frubem/NE_Delta_Schematics/Docs/delta_floppy_interface.pdf

ln Iaae dl progettazione. contemporaneamente alla piastra base del computer DELTA, cl siamo preoccupati di realizzare anche una adatta e specifica lntariaocla tloppy. in quanto tutti i DRIVE FLOPPY utilizzati nei computer Apple sono totalmente diversi da quelli utilizzati nei normali cornputer standard, per cui diversa risulta anche la tecnologia circuitale.
Per questo motivo, diciamo subito che questa interiaccia serve solo per i computer Apple 2 e Apple 2E, per tutti i compatibili Apple giapponesi. thailandesi. ecc.. per il nostro Delta e per gestire esclusivamente DRIVE FLOPPY per computer APPLE.
Non tentata quindi di pilotare con questa intertaccia altri modelli di Drivelloppy, perche non tunzionerebbero.

Questa interiaccia cl occorreva "subito", non solo per collaudare il nostro computer DELTA, ma ancor più per controllare tutti i vari Drive compatibili Apple, e verilicarne l'attidabilità di funzionamento.
lnlatti. troppi sono i Drive reperibili sul mercatoe troppe le "ditterenze" di prezzo da una marca ad un'altra.
Pertanto, volevamo appurare se per alcuni Drive si paga il "nome". oppure la qualità. e la conclusio~ ne a cui siamo giunti è che non conviene mai scegliere dei Drive economici ritenendo di fare un affare, perchè dopo pochi mesi, immancabilmente. occorre sostituirli con quelli più costosi
il Drive è l'accessorio più IMPORTANTE di un computer' quindi, è meglio spendere subito un po' di più, perchè con il tempo se ne trae un vantaggio

### Per utlllzzare con Il nostro computer DELTA. la vastissima blblloteca dl programmi, glochl ed applicazlonl varie disponibili per I'Apple, è

Indispensabile questa “lnteriaccla tloppy disk", In quanto Il software Apple è reperibile più facilmente su norrnall dischetti.

Nella pagina accanto, In

### hanno. potete osservare

l'lntorinocla che vi permettere dl gatlrc due
drive-floppy.

# per computerDELTA

sull'attidabilità. che si traduce in un sicuro vantaggio economico. Non bisogna dimenticare intatti, che il Drive e l'unico componente MECCANICO gestito dal computer ed e sufficiente che dopo breve tempo presenti anche ll più piccolo inconveniente. per ritrovarsi irrimediabilmente “in panno".

SCHEMA ELETTRICO
Iniziamo la descrizione dello schema elettrico di questa interiaccia visibile In tig. 1. dal connettore dl ingresso posto sulla sinistre che. nella realtà. rappresenta il connettore a "pettine", che andrà Inserito nel connattoridiespansionedel computer. Procedendo dal basso verso l'alto. troviamo aubito il collegamento al BUS degli INDlFlIZZI (ingressi da 2 B a 9 B), raggruppate nella lascia colorata in BLU e siglato ADO-ADI
Questo BUS che comprende B tili. giungerà sui piedini 1-2-34-5-6-7-8 dell'integrato ICS, una EPROM tipo 2716 siglata EPJBÀ/B. nell'intemo delle quale e scritto tutto Il programma dl gestione peri tloppydisk` cioè. in pratica, tutte le istruzioni che il computer dovrà eseguire per leggere o scrlvere i dati sul dischetto

ll BUSdegli indirizzi giunge anche sull'íntegrato ICQ. un TTL tipo 74LS259. dal quale preleveremo i segnali di comando per il motore PASSO~PASSO del drive tloppyt necessario per spostare avanti o indietro sul disco le testina di lettura e scrittura del drive stesso
Ritornando al connettore di ingresso collocato sulla sinistra, subito sopra al BUS degli indirizzi troviamo il terminale siglato 1 8 (vedi I/O SEL.) sul quale giungerà il segnale di selezione delle EPROM EP.784/B(vedlpiedlnl18 e 20 di ICE), per leggere e selezionare le istruzioni in essa contenu-
te,
Questo stesso segnale di selezione verrà utilizzato anche perabilitare l'integrato ICS (vedi piedini 1-19). un “bufler” TTL tipo 74L8244. necessario per amplificare e squadrare i dati provenienti dalla eprom EPJBA/B da inviare al computer4
Sempre sul connettore di ingresso, troviamo il terminale siglato Ztl A (vedi RES) che servirà.all'atto dell'eccensione, a RESETTARE tutto il circuito di interfaccia floppy.
Subito sopra, troviamo il terminale 10 A, siglato DRVSEL a. come dice la parola stessa (^'Drìve Selector"). questo ingresso ci serve per selezionare.

99

..In
H'.
.mi
l-

## Il lc: n I

u ls us n

# JB; L-«-1--«1-H--- i ë. nav'- l'" _' '4' '_

Fly. 1 Schola: olcflrlco doll'lmuilcela dmn Iloppy. La had. “fucili vlnlbllc I :Iulm npprucnh Il conncflon I pmlm, lo duo luca poni a dmn l due connettori dl una": pu I dll".Prlcllllmo che I hrmlnlll dl quufl duo connollml(uclulllplldlnl14)nm llfll colhßlfl In pirlllllc, anche u per non templlcln Il dlugm lbhllmo "ldlndllo In colon II mln colloglmønlo del phdlnl 2 n 10.

tramite ICQ. lCt/D ed lCi/C. uno dei due drive collegati ai due connettori di uscita posti a destra. sul quale desideriamo scrivere o leggere. Osservando lo schema elettrico potrete notare che. in questo circuito di selezione dei due drive. e presente anche un integrato. IC1. che altro non e che un NE.555.
Questo NE.555 utilizzato come temporizzatore. ci serve per mantenere in lunzione il drive-tloppy selezionato per un breve periodo di tempo. determinato dai valori della resistenza R3 e del condensatore 06. dopo che il computer ha tinito le operazioni di lettura o di scrittura sul dischetto.
Questo ritardo risulta indispensabile. soprattutto nei casi di lettura o di scrittura ripetuta e veloce dei dati` onde evitare che, accendendo e spegnendo continuamente il drive. si possano veriticare degli errori di accesso.

ELENCO COMPONENTI LXJM

111 : 3.300 ohm 1/4 walt
Il! 3.300 ohm 1/4 wall
R3 : 41.000 ohm 1/4 “11
C1 : 22 mF elettr. 25 volt C2 : 22 mF elettr. 25 volt 03 : 100.000 pF poliestere

## ca = 100.000 pF poliester- = 100.000 pF poliestere

C6 : 22 mF elettr. 25 volt

I DRIVE-FLOPPY. invece. accettano questi Dati solo in versione SERIALE. cioè abbiamo a disposizione un solo “tllo” d'lngnaao per scrivere sul dischetto (vedi il terminale 18 del connettore di uscita. posto sulla destra. e siglato W DATA) ed un un loto “tile” d'uaclta per leggere dal dischetto (vedi Il terminale 16 del connettore dl uscita siglato Fl DATA). Per questo motivo. ci occorre un "circuito" che legga dal computer questi otto bit paralleli e Ii converte in SERIAL! ed ancora che legga dal tloppy i dati "seriali" e Ii riconverta, prima dl giungere al computer. in dati PARALLELI.
Il circuito costituito dalla eprom EP.784/A e degli IC4 ed lCä svolge appunto tale tunzione. cioe converte i dati PARALLELI in SERIAL! per trasterirli dal BUS sul dischetto o. viceversa. converte i dati SERIAL! in PARALLELI. per trasterirti dal dischetto al BUS DATI.

C7 : 100.000 DF poliestere

Tornando al connettore di ingresso. troviamo ora il BUS DATI (piedini da 2A a 9A) raggruppati ih un'unlca tascla colorata in AZZURRO.
Tale BUS. come vedesi in tig. 1. giunge direttamente sui due integrati ICS ed ICS.
Il primo integrato. cioè ICS. è un normale "butter" TTL tipo 74L5244. che utilizzeremo per ampliticare e squadrare i dati provenienti dalla eprom EP,784/B, entro la quale sono contenuti tutti i programmi di gestione dei lloppy. mentre il secondo integrato. ICS. un TTL tipo 74L5323. ci servirà per trasterire i dati dal disco tloppy al computer. Questo stadio. puressendo composto da pochi e semplici Integrati (vedi ICS. lcd. i tre inverter lC2/B. lC2/C. lCZ/A. e i due NAND lCl/A ed ICI/B), svolge complesse ed importanti tunzionl. L'integrato ICS. ad esempio. collegato al BUS del DATI (vedi piedini 1H-15-5-14-6-13-7l. viene utilizzato pertrasterire i dati dal computeral circuito di intertaccia eviceversa. Tale BUS. costituito in pratica da otto lili. prowederà ad ettettuare lo scambio dei dati tra I'intertaccia ed il computer in modo parallelo. cioe a otto bit alla volta (un "bit" su 'ogni tllo del BUS).

Continuando la descrizione dei terminali presenti sul connettore di ingresso. visibile sulla slnistra dello schema elettrico di tlgÀ 1. sopra alla connessione del BUS dei DATI. troviamo il terminale 1M. siglato 03. che il computer utilizzerà per Inviare il ugnalc dl controllo necessario per abilitare il trasferimento dei dati tra la scheda di intertaccla ed il computer.
Salendo ancora su tale connettore troviamo due ponticelli. posti tra i terminali 248 e MA e tra I terminali 235 e med inline i terminali per le tre tensioni dl alimentazione a+ 5 volt.-12 volt e+ 12 volt, più Il terminale comune di massa (vedi 25/1)A
La tensione dei 5 volt positivi verra utilizzata per alimentare tutto il circuito di lntertaccia e. congiuntamente ai + 12 volt ed ai- 12 volt. per allmentare i DRIVE-FLOPPY.
Queste tre tensioni di alimentazione giungeranno sui due connettori dl uscita (posti a destra). più precisamente sui quattro terminali 13. 15. 11 e 10 giungeranno i + 12 volt. sul terminaleã i-12volt. sui due terminali 11 e 12 i + 5 volt. iterminali1,3.$ e 1. come riportato nel disegno. sono tuttl collegati alla MASSA..

DIIIVE 2 | DRIVE I
j I f | I | H _ L
iiliiiiilllliiiillliilii..

Fig.2 Schemapratloedlmontaggiodall'lntarlaociadrivatioppy.Cernovedeeineliatotod inizio articolo. nello zoccole siglato Im andrà Inserita la Eprorn siglata EPJMIA. mentre. mile zoccolo siglato IGG, ia Eprorn siglata EPJM/l.

Anche se nello schema elettrico troveremo congiunti tra loro solo i terminali 2 e 10dei due connettorl di uscita DRIVE posti a destra. e sottointeso che anche gli altri tenninaii che portano lo stesso numero risulteranno collegati tra dl loro4
Fa eccezione a tale regola il solo terminale 14. che dovrà giungere separato ai due connettori.
perchè su questi deve giungere al Drive i eal Drive 2 Il segnale di abilitazione Di quanto sopra precisato non dovrete assolutamente preoccuparvi. perchè` inserendo nei circuito stampato i due connettori. le piste in rame presenti prowederanno automaticamente a collegare tra di loro i diversi piedini.
Anche per il connettore d'ingresso posto sulla sinistra non avremo alcun problema. perchè sarà sufficiente inserire il circuito stampato nel CON-NETTORE 6 presente sulla scheda base del computer e tutti i collegamenti verranno effettuati come richiesto.
Per agevolarvi ulteriormente, in tig. 4 abbiamo riportato il CONNETTORE 6 visto dall'aito, quindi se avete dei dubbi in proposito potrete sempre controllare i terminali A17 - A18 - i325. perchè su questi dovrete rilevare. rispetto alla massa (piedino A25). ie tensioni dl - 5 voit,- 12 volt e + 5 volt.

Terminata la descrizione dello schema elettrico, possiamo ora passare tranquillamente alla realizzazione pratica. che risulterà molto più semplice dl qualsiasi supposizlone.

REALIZZAZIONE PRATICA

Il circuito stampato che riceverete per tale realizzazione. oltre a risultare a lori metallizzatl e completo di vernice protettiva, perevitare in iase di saldatura di cortocircuitare due piste adiacenti per eccesso di stagno. dispone di piste argentate per assicurare un perfetto contatto con il CONNET-TORE 6.
Ancora una volta vi ricordiamo che il segreto per ottenere. a montaggio ultimato` un circuito perfettamente funzionante sono le “saldature”.
II montaggio avrà inizio inserendo subito i due connettori di uscita per i due drive.
Dopo averne saldato tutti i terminali. inserirete nello stampato tutti gli zoccoli. poi proseguirete inserendo le poche resistenze. i condensatori al poliestere e gli elettrolitici. rispettando per quest'ultimi la polarità dei terminali
Terminate tutte le saldature, potrete inserire negii zoccoli tutti gli integrati controllandona ia sigla e rivolgendo la tacca dl riferimento come chiare-
mente riportato nello schema pratico dl fig. 2.
A questo punto. potrete inneslare tale scheda nel CONNETTORE 6 presente sul circuito base del computer. e indicato con ia dicitura CONN.6. Come vedesi nella foto. questa scheda andrà inserita tenendo il lato con sopra tutti gli integrati rivolto verso il "CONNETTORE 7".
Se inserirete tale scheda alle rovescia, oltre ad uscire esternamente dal circuito base del computer parte di esse, con un risultato decisamente antiestetico. invertirete tutte le connessioni e le tensioni di alimentazionl.
Invertendo in un integrato le tensioni dl eilmentazione. non solo questo non funzionerà subito. ma si danneggere . Se disponete di un drive idoneo per APPLE. po-

trete collegarlo subito al CONNETTORE USCITA "DRIVE i" e per stabilire se funzione correttamente. potrete iniziare a scrivere sul floppy e a rileggerIo.

COME UTILIZZARE L'INTERFACCIA
Per utilizzare I'interfaccia floppy-disk. dovrete aempllcemente Inneetare la schede ultimata nel connettore dl espansione 6 (vedi CONN.6). Inserita la scheda e collegati a questa uno o due drive-floppy. potrete accendere il vostro compu-
ter.
lmmediatemente udrete uscire dalf'eltoperlante un "beep" e. contemporaneamente. vedrete apparire sul video le scritta DELTA.
Non vi apparirà invece il “cursore”. ne il simbolo “1" che indica “computer pronto a funzionare". Infatti. il computer rimane in attesa di leggere del dischetto le istruzioni da eseguire e. perciò. fino a quando non inserirete nel drive un dischetto con un qualsiasi programme. Il computer rimarrà in “attese di istruzioni".
Se avete a disposizione due drive-floppy. noterete che solo su uno dl questi. precisamente su quello lnnestato nella presa DRIVE 1. si accendere il l'led" frontale.
Il dischetto con il programma gia memorizzato dovrà essere inserito In queeto drive ed. infatti, appena chludereie lo sportello frontale. Il computer inizierà a leggere i dati presenti sul dischetto e ad eseguirli.

## SNMIIS

nua | v..
ni | iu
ei un
in | ns
n: : | :i ns
in | 1 u-
n: | 1 in
m | :unu
SN74I74 | SIT/“5244
m | m
mami | miu
un. | unu
mu _ | :uu-u
'E555

## SNMLSIJZ

Flg. 3 Conneulonl degli Integrati vletl tutti da copre. Le Eprom

## uglm :nel me In pmiu cui. "2110 (nei magma ma a

dalle), progremmete appositamente perquesta Inievfloeia floppy.

“ur

SN74LS3ZJ | 52784

IIiIIII tinimil'
l-Ll-l-luJ-IJJ-Llw-l-l-l-I-l-LA-l-I
_

Fig. 4 Questa Interfaccia andrà Inserita nei COMME. rivolgendo gli Integrati siglati ICI - IC'I (vedi schema pratico di tig. 2) vano la “traccia” e gli Integrati lc! - lcd verso l'lnterno del computer.

Se aveiea disposizione un solo drivetloppy. non inseritelo mai nella presa DRIVE 2: intatti. poichè inizialmente il computer leggerà sempre il DRIVE
I. non vedrete accendersi il led posto sul Irontale del drive ed il computer rimarrà bloccato.
ln questo caso. dovrete spegnere nuovamente Il computer. spostare la presa del drive sul connettore DRIVE 1 e riaccenderlo.
Utilizzando un qualunque programma per Apple su dischetto. non sarà necessario scrivere alcuna Istruzione. in quanto tutte le operazioni di accesso. caricamento e lettura del disco vengono eseguite automaticamente. senza alcun intervento esterno
dell'operaiore.
Per terminare vogliamo aggiungere di non epognare mal il computer con il dischetto lneerlto nel drive. in quanto, anche se accade raramente. tale operazione potrebbe danneggiare i dati contenuti nel dischetto.
Lo stesso dicasi all'accensione del computer. cioe non accendete il computer con dei dischetti Inseriti nell'inierno dei drive.

IN UN FLOPPY. DOPPIA CAPACITÀ

Non tutti sanno che il disco tloppy puo essere utilizzato da entrambi I lati. pertanto. se prima ci occorrevano 10 dischetti per memorizzare programmi o giochi` adottando I'accorgimento che ora vi Illustreremo na occorreranno solo la meta.
cioè 5. e questo comporterà un certo risparmio.
Provate intatti a controllare II vostro dischetto
tloppy. e noterete che su un solo lato del perimetro è presente una "tacca" a U: se inserirete nel Drive-
Floppy il dischetto In senso Inverso al richiesto.
provando a salvare un tile su tale disco. sul video del computer apparire un messaggio di errore. Se invece pratichere un'ideniica "tacca" anche sul lato opposto della custodia del vostro dischetto. potrete utilizzare entrambe le taccie del disco. che owiamente siglerete lato A e lato B. ed II cornputer lunzionera perfettamente
Ottenere questa "tacca" supplementare e molto semplice. perche sarà sulliciente appoggiare sopra ad un dischetto. un secondo rovesciato. e segnare con una matita questa U' che pol tepllerete con un paio di lorbici.

COSTO DI REALIZZAZIONE

Tutto I'occorrente per la realizzazione dl questa interlaccie. come visibile nella loto e in tig. 2 cornpreso ii circuito stampato. gli zoccoli per gli Integrati e un circuito a to metallizzatl completo di
disegno serigralicc | L. 84.000
Il solocircuiiostampato LXJM | L. 10.500
Nei prezzi sopraindicati non sono Incluse la spese postali di spedizione a domicilio.
