frubem/NE_Delta_Schematics/Docs/delta_computer.pdf

Qualche annoia. quandodecidemmo dl presentare ai nostri lettori il primo ed unico kit di un computer, la nostra prima preoccupazione tu quella di realizzare un computertecnicamente pertetto e molto duttile. suscettibile di espansioni tramite schede periferiche e. cosi iacendo. ritenevamo di aver raggiunto un valido obiettivo.
Purtroppo avevamo sottovalutato un particolare. che In seguito sl e rivelato londamentale. cioe tuttii lettori che avevano acquistato ii nostro kit. dopo averlo montato. hanno Iniziato a richiedercl sempre più insistentemente dal "software", cioe l programmi per il computer. i giochi più svariati. ecc..e noi. colti alla sprowista da tali sollecitazioni. non alamo stati In grado dl soddisiare le loro richieste. non avendo minimamente previsto un tale servizio. Nel progettare quel nostro primo computer cioe. avevamo proceduto come nella realizzazione di un qualsiasi "organo elettronico" o di un “distorsore perchltarra". nei quali casi diamo per scontato che chi ha acquistato tall kit. conosca gia bene gli raggiungere ll massimo delle prestazioni. tralasciando il iattore "costo".
Chi si costruisce un computer, intatti, non lo la per usarlo con del "video giochi". (per l quali esistono già dei computer a bassissimo costo). ma lo costruisce perche ha bisogno di un computer professionale. per gestire magazzini. amministrazioni, per stampare bolle di accompagnamento e fatture. e volendo.m anche per giocare.
Abbiamo quindi previsto anticipatamente l'inserimento di uno. due drive-floppy con la possibilità di sostituirli con dei winchester. abbiamo pol Inserito un doppio banco di memoria per un totale dl 128 K. scegliendo degli integrati solleticati. anche se questa operazione ha accresciuto considerevolmente ll costo linale del computer: ci e comunque sembrato assurdo risparmiare 100.000 lire. per
tornirvi poi un circuito tecnicamente sorpassato.
gia al momento deli'acquisto.
Abbiamo anche realizzato un circuito stampato a tori metallizzati protetto da una speciale vernice.

### Il computer DELTA da noi realizzato. pouleda l'Impagabile caratteriatlca di lunxlonara con tutti l programmi utilizzati per I'APPLE 2 e

per I'APPLE 2 E. Progettandolo. abbiamo cercato di renderlo univer-

### aala e periettamente compatibile. tanto che tutte le schede paritari-

che utilizzata per I'APPLE. pouono essere tranquillamente Inserite
in questo computer DELTA.

# DELTA an COMPUTER m

strumenti in questione e non ci richiederà certo una descrizione accurata del pentagramma. ne delle lezioni per imparare a suonarli.
Con il computer perciò cl siamo trovati in ditiicolta ed abbiamo cercato di owlare a questo inconveniente. prevedendo un adattamento che lo rendesse compatibile con qualsiasi programma in CP/M. rlsultandoquesto un sistema operativo. dotato dl rilevanti programmi. tacllmente reperibili. Proprio per evitare che sl rlpetesse una tale esperienza. nel progettare questo “nuovo computer". contrariamente alla prassi normale che si segue In iase dl progettazione. per cui sl ricercanogli integrati e su questi sl costruisce la "macchina". abbiamo ricercatoquanti equali siano i programmi più facilmente reperibili e a basso prezzo e. In iun~ zione a questi. abbiamo progettato la macchina. scegliendo owiamente soluzioni clrcuitall tecnicamente all'avanguardia. che ci permettessero dI

### 1 .allunmmnalmma

### per evitare che con il tempo le piste si possano

ossidare e abbiamo iatto “testare” ogni circuito da industrie specializzate di Milano. per escludere subito. quelli che in fase dl incisione preaentaaaero una pista interrotta o in corto.
Cosi facendo. possiamo assicurarvi une maggiore afiidabilita, anche se un tale servizio. tra apeee di controllo, corrieri' iVA, hanno ulteriormente contribuito e tar salire ii prezzo del nostro computer.
ll computer DELTA che ora vi presentiamo. e un progetto che abbiamo realizzato circa un annoia e che abbiamo graduaimente periezionato, al punto

### Nmmfkmmdhw ddhmlptùcelcpuadd

tale che oggi possiamo proporvelo, certi che sarà un'altra realizzazione di cui rimarrete pienamente Søddlafatil.
il vantaggio principale offerto da questo computer. come gia accennato, consiste nel risultare pariettamente compatibile con I'APPLE 2 e I'APPLE 2
E. anche se ciò non deve iarvi pensare che esso ala una volgare "imitazione", come tante altre presenti in commercio, con nomi di frutti più o meno mangerecci.

### Come potrete constatare controllando lo sche-

ma elettrico` si tratta di un progetto Interamente realizzato nei laboratori di Nuova Elettronica. quindi totalmente diverso da un qualsiasi APPLE. Per tal motivo. realizzando questo nuovo computer, abbiamo Inserito tutte quelle innovazioni
che esaliassero al massimo le caratteristiche del-I'APPLE, senza dovere aggiungere in un secondo tempo costosi circuiti di espansione.

La configurazione del computer DELTA puo eesere cosi riassunta:

## ,-uønmmlmwloman

l - Oadonadeividao

### VVideoaitlloaotioratoarie

f maddtartaoiuzloneeom

## i, -nxupunansmri

hmaifipuntlaloolorl

Aggiungendo a tutto questo. il vantaggio di poter utilizzare tutti l programmi che gia sono disponibili pcrI'APPLEZ E, (che non riescono a "girare" su tutti gli svariati compatibili venduti in commercio), comprenderete come Il nostro computer sia veramente completo.
li DELTA accetta intatti tutti i:

Owiamente, volendo che tutti questi programmi, gia disponibili in commercio per I'APPLE 2 e I'APPLE 2 E, riescano a girare sul nostro "nuovo computer”. abbiamo dovuto scegliere come CPU l'integrato 8502, e realizzare schede periferiche standard. che possano ìnnestersl senza alcuna moditica in qualsiasi computer APPLE. cosi come le APPLE su questo computer DELTA.
Per avere questa completa compatibiilta` abbiamo progettato anche tutti i collegamenti sui connettori d'lngresso e di uscita. per poter cosi utilizzare piattlne, drive-floppy, registratori, tastiere. che gia possedete, adatte all'APPLE.
L'ultimo e più importante l'ventaggio" presentato dal DELTA. consiste nel iatto che avendolo montato voi stessi. lo conoscete a iondo. quindi ln caso dl guasto sarete in grado di riparario e in brevissimo tempo.
lnlattl, un guasto può essere causato solo da un integrato che con il tempo si rivela dilettoeo. e poichè tutti gli integrati sono montati su zoccoli, siilario. per sostituirlo con un altro eimilare. e una operazione semplicissima.
Se In passato avete posseduto un computer commerciale, che Improwlsamente ha cessato di iunzionare, avrete constatato personalmente quanto sia diiticoltoso ripararlo, non solo perche tutti gli integrati sono saldati sul circuito. ma anche perche spesso non risultano più disponibili sul mercato. con i'owla conseguenza di dover sostituire "tutto" il computer.
Nei nostro caso. tutti gli integrati utilizzati sono facilmente reperibili e se da soli non riuscite a scoprire il guuto. noi siamo pronti a rimettervelo ln iunzione. comunque possiamo gia tin d'ora assicurarvi che se iarete delle perlette saldature, s non vi dimentichereto di saldare un piedino di un integrato. e non ne Inserirete alcuno alla rovescia. ll computer vi funzionerà subito e senza Inconvenientl.
Da oltre un anno maltrattiemo i nostri prototipi.

### togliendo e sostituendo Integrati. inserendo proto-

tipi di lnterlaoce varie, che spesso presentano dei coflocircuítì, inserendo distrattamente In uno zoccolo degli integrati destinati ad un'altrs zona, ci e anche capitato di sovraaiimentsrll con un “variac” a 250 volt. pertanto. non avendoci mal dato il benchè minimo problema. possiamo assicurarvi ia totale aflidabiiita dei nostro computer.

INTRODUZIONE ALLO SCHEMA ELETTRIOO

Prima di passare alla descrizione dello schema elettrico. dobbiamo precisare che questo computer e un "single-board", vale a dire che tutti lcompcnentl. memorie. interfacce, CPU, eprom. prom, ecc.. risultano montati su di un unico circuito stampato (vedi loto e scheme pratico), pertanto. non potendo iar rientrare in un'unica pagina questo complesso circuito elettrico. lo abbiamo dovuto dividere ln tre stadi.
Osservando questi tra schemi. si avrà subito l'impressione di trovarsi di ironte ad un circuito molto complesso, riservato a "super-esperti". in~ vece, come voi stessi potrete constatare' montare questo computer e semplice quanto montare un circuitoad un solo Integrato, con i'unica diiierenza che. in queato caso. occorre montare “un solo" integrato, per un maggior numero di volte.

inoltre. ii circuito stampato a lori metallizzati da noi lomlto e protetto da una apposita vernice leo-Iante. in modo da lasciare scoperti i soli punti da saldare. per scongiurare cosi il rischio di mettere in corto. per un eccesso di stagno. due piste vicine. Le scuole e gli istituti professionali che da tempo ci hanno chiesto di presentare nella rivista il progetto di un “Computer”. per dotare di questo prezioso e moderno strumento di insegnamento I propri laboratori. troveranno in questo articolo la soluzione a tale problema.

SCHEMA ELETTRICO DI FIG. 2

iniziamo pertanto la descrizione dei nostro schema elettrico. riprodotto in llg. 2. dalla CPU tip06502. siglata I031. percheatale lntegratosono collegati tutti gli altri integrati supplementari pre-
senti nello schema.
Precisiamo che questo collegamento ira ia CPU e tutto ii resto dei circuito avviene attraverso due “vie principali". che sono la "vie" dei DATI e la "via" degli INDIRIZZI.
La terminologia corretta sarebbe ln realta ben diversa da quella con cul ora cl siamo espreai. Iniattl si dovrebbe parlare dl BUS-DATI e BUS-INDIRIZZI; in analogia con Il termine “BUS"dl uso comune (cioè “mezzo di trasporto pubblico". BUS o autoBUS). perche Ii BUS nel computare il "mezzo di trasporto" sul quale "vlagglano'I tutte ie iniormazioni che necessitano. sia alla CPU. che a tutti gli altri integrati presenti nel computer.
Queste due via di comunicazione sono riportate nello schema elettrico dl tig. 2. con delle luce colorate. quelle in blu per gli lNDIflIZZI. quelle in azzurro per l DATI e quelle In grigie per l DA11 SECONDARI.
Utilizzando queste lasce "compatte" per la reppresentazione dei BUS di comunicazione. lo schema risulta molto più comprensibile, iniatti.sara sulticiente immaginare che entro queste "fasce" colorate scorrono tutti l lili. che collegano tra dl loro gli integrati.
Accanto ad ogni singolo lilo che esce da queste "tasca". abbiamo riportato una sigla per individua-
re i vari collegamenti.
Partendo dalla CPU (ICST). le uscite degli INDI-RIZZI che lanno capo ai piedini dal 9 al16 e dai11 al 25. si coliegheranno direttamente agli ingressi del due integrati l635 ed ICSG.
Questi due Integrati. tipo 74LS244, ci servono per ampiiiicare la debole corrente che le CPU lornisce in uscita. che non potrebbe msi giungere attraverso le lunghe piste del circuito stampato. agli altri integrati con una intensità sui'liciente per pilotarli correttamente.
i DATI escono invece dalla GPU. sul piedini 26-27-28-29-30-3142453. e poiche Il corrente che la

CPU e In grado di iomlre e più che sufficiente per pilotare qualsiasi integrato posto anche a notevole distanza. risulta superfluo ampliflcaril.
Seguendo verso ii basso questo IUS del DATI. troviamo l'integrato siglato 1038.
Ouestc integrato SN.74LSZ45 viene utilizzato solo per amplliicere e squadrare i del provenienti da eventuali circuiti dl espansione. che innesteremo nei CONNETTORI presenti sulla scheda del
computer.
La linea del BUS del DATI collocata a sinistra. dopo poco rlplega verso destra. per collegarsi al due integrati. siglati l027 ed i028. due memorie EPROM tipo 2764, che contengono Il programma dl IAONITOR in linguaggio macchina, tutti l programmi BASIC perla gestione del vldeeaeoeaen

### colonne. sia in bassa che in alta risoluzione. ed aitrl

programmi supplementari. necessari alla gestione di lunzioni particolari del computer (come ad esempio l'assegnazione dei vari indirizzi ai connettori di espansione. le routines di inizializzaziane per il RESET del computer. ecc.).
Sopra a questa due EPROM e sempre collegata ei llJSdel DATI. troviamo la prima tlia dleRAM del banco di memoria da 64 Kilobyte. siglata rispettivamente iCS. ICH. ICIS. ICIS, ICW. ICI9. I021 ed
lCZJ. | ` La seconda ille di integrati presente in alto. sigla-
ti IOS. lCiO. i612. ICH. ICIG. ICIB. IC20ed | .
costituisce un secondo banco di memoria da 64 Kilobyte (totale tuKllebyta). che. adlllerenza del primo. non risulta collegato direttamente al BUS principale dei DATI. bensi ad un BUS secondario. collegato e quello principale tramite 1024.
Per chi conosce la tecnologia APPLE. possiamo dire che questo secondo banco dl memoria gli presente nel nostre computer. sostituisce la "LANGUAGECARD" che. originariamente. doveva essere acquistata a parte e che consentiva di ottenere. assieme ad un'altra scheda aggiuntiva. un lormato video ad 80 caratteri ad alte risoluzione. Risultando questa due espansioni gia presenti sul circuito stampato. il formato video sara immediatamente sugli 00 caratteri-alta risoluzione: pertanto. sul DELTA potrete iar"girare"tutti quel programmi che neII'APPLE 2 richiedevano l'espansione della “LANGUAGE-CHARD".
ln pratica. Il nostre computer DELTA disponendo gli internamente del massimo delle espenslonl possibili. ci consente di adottare tutti l "migliori" programmi reperibili per I'APPLE 2 e l'APPLE 2 E, che richiedono una espansione di memoria a 128 Kilobyte4
Proseguendo con il BUS del DATI che ci coile~ gava con la prima lila RAM. troveremo. In londc a destra. l'lntegrato l026: questo Integrato. congiunto a ICZS. serve per interfacciare i'unlta video con Il bus principale del DATI. ln modo da rendere dispo-

### _ 1i'f`

# la"1.» II

# '¦___ g

I

ü

'4L

FlgY 1 Foto della scheda base dI questo computer. SI notlno a destra I sette connettori che utilizzem rno perle iuiure eapanalenl e le lnteriloce drive-floppy, stampante, ecc. Oueato oempuiere completo dl 128 Kllohytee di memoria RAM e dl 16 Kllobyle dI memoria ROM. Tutti l componenti che vedete riportati negli schemi elettrici dI ilg. 2-4-5. risultano Inseriti In quello circuito stampato.

nibíle all'interiacoia video un'eree di memorie. nella quale verranno poi riportati tutti i dati necessari
per “creare” la pagina video.
Completato Il percorso del HUS dei DATI. vedlamo ora quello relativo al IUS degli INDIRIZZI che. come già sappiamo. parte amplitloata dal ple~ cllnl dl uscita 3-5-7-9-12-14-16-18 del due Integrati l035 ed ICSG, visibili sulla sinistra nello schema elettrico di Iig. 2.
All'lnizlo dl questo BUS. troviamo collegate le due memoria EPROM (vedi l027 ed ICZB). di cui abbiamo gia parlato precedentemente. risultando questa pure collegate al BUS dei DATI, quindl. proseguendo in linea retta possiamo osservare la "lascia" di questo BUS scendere verso ll basso, per collegare! al piedini BZ e 517 del connettore (vedi rettangolo in verticale. collocato alla sinistra del

### BUSL

80

Questo unico connettore. in pratica “saranno SETTE connettori". tutti collegati In parallelo, come potremo anche vedere nella ilg. 4. Proseguendo sempre vereo il basso su tale Iaeoia del BUS degli INDIRIZZI troviamo una ulteriore dlramezione (vedi bollini poatl In basso con ecrltto A4-A5-A6 lino ad A11, SLCS-SLCX e SLCXX e ROM/C), che andrà a collegarsi allo schema riportato in Iig. 4.
Inline, proseguendo. questo BUS ei collegherà agli integrati siglati IC41, IC42, IC45, IC47 e ICÀB. necessari per abilitare le varie iunzioni del compu-
ter.
Solitamente. per gestire tutta queste iunzionl el utilizzano nei computer delle reti di porte logichee dl il-ilop` ma, cosi Iacendo. ll circuito sarebbe diventato notevolmente più complesso per I'eleva-

### to numero di integrati necessari. Noi, invece, ab-

I1=1M01IIIMUNOII11I | | | | | 100:”.7m
I! : 1M Ohm nb "dm | | | | | 104 : SNJ4LS1$I
Il : 470 Ohm 1/4 'Ill | | | | | ICS = SNJ4LU4
R4 : 470 ohm 1/4 Il!! | | | | | IO. : SN.74L832
IIS : 33 ohm 1/4 Intl | | | | | IC'I : 811.103180
Il : nohm 1/4II1! | | | | | ICI-Im : Hula
m : 1M ohm multi' | | | | | IW _ SNJ4L8245
Ill : 1M Ohm 1/4 "Ill
R9 = 1.000 ohm 1/4 Um | 11:25 | SN.74L$374
.10 | .M ohm 1/4 N.11 | 1627 | EPJOO/À (EPROI m)
'11 | .000 Ohm 1/4 'Ill | le” | EPJlO/B (EPROI m)
l12 : 1.000 ohm 1/4 Il!! | Im | EP.700/1 (MIDI)
R13 : LM ohm 1/4 mi! | IGM | SNJ4L874
l14 : 1.000 Ohm 1/4 M | | | | | 1031 : SN.74LS153
500 011m 114 un | | | | | Im = smmsm
seo «mn 1/4 un | | | | | una = smusm
su ohm 1/1 un | | | | | ma = “msm
seo «nm 1/4 un | | | | | ma = mmszu
| | | | | una = snmszu
| | | | | 1001 = crussoz
| | | | | ma = 011.141.024; 11:0 = summa
| | | | | 1040 = sunwoa
| | | | | 11:41 = mmsm
| | | | | la: = :nno/:(00011) lcu = :N.mszo
1011 = 014.141.000 = 1. | las = :nno/a (non) = 10. | Im = smusn = .2 mega | 1c41 = :nno/4011011) n01 = 12.000 ohm 114m | lcu = :nno/5911010)
m = :1,: mmm 1/4 ma | | | | | Im = :mamme
c1 = 1001111¦ ohm. :s un | | | | | lw = sNJussn
m = 100.000 pr peu-mn | | | | | 11:1 = 311.141.002
u = 100.000 pF pøumm | | | | | lcs: = 001.141.3014
a = 100.000 pr palm-n | | | | | less = 011.1415151
- cs = 100.000 pF palm-n | m4 = :ano/0 (mou) 00 = 100 mr .1110.201011 | las = :nno/cammina) c1 = 10.000 pF poll-mn | leso = 911.141.015: ci = 100 mr 01.111. as von | lw = 511.100” (non) 00 = 22.000 pr poumm | Icon = smuszsø

Im : SN.14L8203
I000 : SNJ4LSM
1001 : SNJ4L$151
Im : CRTCM
Im : 91.10.8251

ALTO? = mimi-l
y
Nei In schemi olmrici dl flg. 2-4-5 non comp-bono I oondunutorl dl lug. alqlau 05. tutti di. pF. dbuItl sulla scheda bu.null. pino 0h.dlmmtml dmn! lmgml. In pmünl.

### MOSmlonchunnprlflcodfig. 18linúhflohlultliul-III-.udllpullllmddfil

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
biamo voluto sempllilcare questa parte di circuito utilizzando delle memoria programmate. per avoigere tutte queste iunzionl necessarie el iunzionamento del computer.
Senza “appeaantire” lo schema. abbiamo inserito in esse anche la gestionedi tutti l `l'a'litiiolryted

### memoria. quella del vldeoaBO colonnee la graiica

ad alta risoluzione.
In particolare. le iunzloni svolte da queste FROM. possono essere cosi riassunte:
- IO!! (vedi EPJBO/ã) gestisce I'abilltaxlone deil'area di memoria delle due EPROM 1021 ed I02! e seleziona l'aoceseo al due banchi di memoria RAM, abllitando il banco principale o quello secondario
(64 o 126 K).
- Ice! (vedi EPJBO/S) decide. ln base alla richir ate della CPU. quale delle due EPROM deve essere collegata al BUS principsiadei dati ed inoltre attiva con la giusta temporizzazione l`ampliilcatore/ aquadratore (vedi 1638) per i dati provenienti dai connettori dl espansione e gestisce l'acoesso della CPU per la grafica ad alta risoluzione (vedi segnale
SLO.3).
- IO" (vedi EPJSOM) genera ll segnale dl "STROBE" da associare al dati Inviati alle peritonche inserite sul connettori di espansione e serve per "comunicare" alle periferiche stesso. che Il dato presente in queil'lstante sul BUS puo essere letto.
- lu. (vedi EPJBO/S) gestisce l'acoesao al due banchi di memoria RAM e genera i segnali necesaari al "rinfresco" di queste memorie.

Ii circuito completo per Ii rinfresco delle memorie e costituito. oltre che da lcee. dei tre nand IGM-B. IGM-C e lCN-D e dai quattro inverter lC2-B. iCZ-C. lCâQ-C e lCSS-D.
Per I meno "esperti". specifichlamo che la tunzlone oi "riniresco" delle memorie dinamiche e dl iondamentale importanza. perche queste. a ditterenza di quelle "statiche". mantengono I dati in memorie. solo se le loro celle vengono ripetitivamente attivate ogni 2 milllaaoondl; mancando tale “rinfresco”. le memorie si cancellerehbero. biocoando cosi li funzionamento del computer. ll vantaggio che offrono le memorie dinamiche. rispetto a quelle statiche. e essenzialmente dl tipo "eccnß mico": se avessimo utilizzato delle RAM statiche. il prezzo avrebbe subito un ulteriore aumento di 200.000 lire. pertanto. un tale risparmio ripaga abbondantemente questo circuito supplementare. necessario per "gestire" ll ciclo di rlniresco dei
banco dnamioo.
Ritornando al nostro schema elettrico di iig. 2. al due lati superiori ed interiori degli integrati siglati l031.iC32. ICSG ed lCM. troviamo altri due BUS aeoondari.
B4

ll primo. riportato in alto e siglato MAO-MAL si congiungera al due banchi di memorie RAM. mentre llsecondo. siglato VAO-VAT. riportato in basso. raggiungere l'interiacoia video.
Per completare questa prima parte dello schema elettrico. ci rimane ancora da descrivere lo stadio dei segnali di clock.
Questo circuito. composto da una memoria programmata (vedi IC29 siglata EPJetJ/i). dal due inverter ICS-B ed ICS-C. dal nand ICS-B e dal Flip/-Flop l030-A, lo troviamo riportato si centro dello schema elettrico di ilg. 2. L'oscillatora quartato ottenuto con i due Inverter siglati ICS-B ed ICS-C. iunziona ed una irequenza di 14.310 ll.
Il segnale ad onda quadra. presente sul piedino dl uscita 12 di ICS-B. giungere sul piedino di ingresso 1 di IC29. che provvedere. con uns complessa rate di divisori. a iomlre ln uscita tutte le frequenze necessarie per il corretto funzionamento del computer. cosi:
- Dai piedino 1! uscire una irequenza ad onda quadre di 1,10. ll, necessaria all'interiaccia vi-
deo per ottenere il iorrnato a en colonne.
- Dal piedino 10 uscira il segnaledi RAS. necessario alla selezione delle memorie RAM.
- Deipiedlno iluscira il segnaiedl ciooii0a1. i r" mix. necessario alle espansioni e all'intsriaccla video.
- Di piedino 15 uscire il segnale di dock 1, sem-

### pre a 1.023 Ill-lx . ma con iase invertita rispetto al

clock 0, che viene utilizzato dall CPU come segnale di cioeii principale.
- Dal piedino 10 uscira una frequenza di 1 MHZ. necessaria alla sincronizzazione delle schede di
espansione.
- Dal piedino 13 uscire una trequenza di 2.046 I": asimmetrica. che viene utilizzata come "STROBE" per le perlterlche di espansione.
- il piedino 2 è un ingresso utilizzato dall'integrato
16.29. per stabilire se la irequenza necessaria all'interiaccia video deve essere da 14,31! IN: (iorrnato ad 00 colonne), oppure da 1.100 IH: (ionnato a 40 colonne).
- Dal piedino 12 usciranno degli lmpulsi di clock a 1.040 Il. per ottenere il segnale SRLO per ii circuito di uscita dell'lnteriaccia video (vedi "2.40 ed lC.50 sullo scheme elettrico di tig. 5).

Prima di passare al successivi schemi elettrici riportati in iig. 4 eiig. 5. precisiamo che al rettango- ~ lo In colore con sotto scritto "GONNA-7", visibile in basso nella parte centrale di tale schema. ianno capo tutti I segnali che giungeranno ln parallelo sul SETTE connettori di espansione visibili in iig. 4. Sempre in basso. spostandosi verso destra. e visibile una iils di 13 bollini. indicati DEV.8. M. A5.... ROM C. che andrannoacollegaral ai 13 bollini collocati alla alniatra dello schema elettrico di q. 3 Foto dello atldlo di alimentizlone utlilmto per questo computer. Al due tati dello atampato andranno applicate due alette dl ratlrodoemenin. come visibile nella toto d peg. 103.

tig. 4, cioe quello completo del 7 connettori di espansione.
Sui lato destro di questo stesso schema elettrico. sono inoltre presenti tutte ie altre connessioni. contraddistinte da delle lreccette in colore. che andranno a congiungersl aiio schema elettrico di llg. 5, cioe a quello relativo ali'intertaccia video ed aii'ingresso della tastiera.
Per terminare. i rettangoli colorati. al cul interno sono disegnate un certo nu mero di resistenze (vedi R1-R2-R7). sono delle reti relative inciuae In un unico chips.

QCNEMA ELETTRICO DI FIG. 4
In lig. 4 troviamo la seconda parte dl questo scheme elettrico, quella cioe completa del 7 connettori di espansione. Questi connettori vi consentiranno di inserire nel computer DELTA tutte ie schede di espansione che già possedete deil'AP-PLE 2 e delI'APPLE 2 E, oppure di utilizzare le nostre schede di espansione per lnserlrie nel vostro APPLE.
Tra le schede più comunemente utilizzate. potremmo citare i'eapanslone per ii Happy-dial: controller e quella per ia stampante. per le quali poesiamo pia anticiparvi che appariranno sul prossimo numero della rivista.
Lo schema di tig. 4 e molto più semplice rispetto lo schema precedente. perche su di esso troviamo un numero inlen'ore di integrati, utilizzati come "decodilicatori" di Indirizzi. per selezionare uno qualunque dei aette connettori di espansione presenti.
in particolare IC4 lomìace in uscita un segnale che specilice la "DIREZIONE" dei datl. cioe indice ae ie lnlorrnazioni da scambiare ira ii computer ed ilcirouitodiespansioneselezionato.devonoandaredalcomputervenolaporttericaovlceveraa (vedi piedino B1 del connettore, Indicato con la sigla llOn), mentre iCT lornisce il segnale di abilitazione ad ogni singola scheda. Come. intatti. potreteconatatare. le sue sette uscite risultano collegate al piedino A10. siglato DEV. SEL. (abbreviazione dail'lnglese "Devices Seiect"), che potremo tradum molto semplicemente "seiezionami Ii connettore sul quale devo lavorare".
Su ognuno dei sette connettori giungeranno tutte ie tensioni di alimentazione, che lenno capo ai connettore posto In basso a sinistra nello achema

### elettrico (vedi rettangolo in colore siglato

l'(30NN.8"). l valori di tensione che giungeranno su ogni connettore sono i seguenti:
+ 12 volt (piedino 2) : utilizzati dell'lnterteocll video e dalla schede dl espansione.
- 5 volt (piedino S) : utilinati dal circuito di interfaccia-registratore e dalla schede dl espertalone.

- 12 'ott (piedino 4) : utilizzati delle tlltlerl e dalle schede dl espansione.
+5 veit (piedino 5) = utilizzati da tutti gli integrati presenti sulla scheda.
llaeea (piedino 1) : terminale comune a tutto ll circuito.
Come precedentementeaccennato. tutti I "bollinl" visibili sul lato sinistro di questo schema. risultano elettricamente collegati con le uscite riportate in ilg. 2 (vedi uscite con identica dicitura).
Per quanto riguarda i sette connettori. precisiemo. che tutti i loro piedlnl (eccetto l piedini dl "lezione e direzione del datl)l risultano collegati In parallelo.
Vi ricordiamo che nello schema elettrico tutti l connettori aonovlati dal baeao, quindi osservando-Il dall'alto` la iiie A sera sopra e le illa B sotto (vedi disegno lngrandlto ln bacio. rlproducente un solo
connettore).

### SCHEMA ELETTRICO DI FlG. 5

Per completare la descrizione del computer DELTA. rimane ore lo schema elettrico visibile ln iig. 5.
Sul lato sinistro di tale schema. e riportata la sezione relativa all'inieriaccia video, mentresul iato destro I'inieriaecia per la tastiera. per il JOV-STICK dei giochi e per il regiatraton a ceaeetta. Sul lato alnlstro di tale scheme. riportato in baaao. troviamo l'integrato l062. una CRTC tipo M. in gradodi generare tutti i segnali videodi base. sia per ll iormato a 40 che per quello a 80 colonne. compresa owlamente la grafica.
ll CRTC per "comunicare" con la CPU e ricevere da questa tutte le istruzioni necessarie al auo tunzionamento. utilizza il BUS di DATI (vedl la fascia colorata siglata DO-D7 ed I collegamenti sul piedini 26-27-28-29-30-31-32-33).
Per l'indrlne. invece. e sufficiente un solo collegamento (vedI fascia in basso del BUS A0-A15ed il collegamento aul piedino 24 di l062).
Sul piedini 4-5-6-12-13-14-16-7-6-9-15 della CRTC risultano dlsponlblii gli indirizzi per l'area dl memoria della pagina video.
Come vi avevamo precedentemente accennato nella descrizione dello schema elettrico di iig. 2. una parte della memoria principale del computer verra utilizzata per "creare" le pagina video e a questo punto possiamo precisare che. quando viene richiesto il iermeto a BO colonne ola pagina greiica ad elia risoluzione, occorre più memoria, pertanto, tutte le iniormazioni relative ad una pagina a 40 colonne vengono n'poste nel banco principale di memoria da 64 K. mentre per le BO colonne inizieremo a siruttere ed occupare anche le memorie nel banco secondario, composto da altri 64 K. Per questo motivo. abbiamo ineerito nel computer Il banco secondario di memoria per une eepanaioM totale dl 12. Kllobyte, per ottenere subito 80 colonne e una grafica ad alta risoluzione. senza dover inserire nessuna scheda aggiuntive nel connettori di espansione.
Flitomendo alla CRTC. collegato sulla uscite de-

### gli Indirlzzl di l062 (vedi pledinl da 4 a15), e pre-

sente I'Integrato elglato ICSD.
Questo integrato svolge una lunzione molto Imponente. cioe quella che cl ha permesso dl rendere questo computer DELTA periettamente compatibile con tutti i modelli APPLE; lnlatti. nell'APPLE 2 e neli'APPLE 2 E vengono ulilizzatealcune speclflche "zone" deli'area di memoria per creare l'lmmagine video. pertanto. era assolutamente necessarlo "ricomporre" scrupolosamente tale Indirizzamento anche su questo computer. in modo da garantire la totale compatibilità dl tutti i programmi reperibili in commercio per I'APPLE.
Per le stessa esigenza dl "compatibilita", abbiemo inserito nel circuito anche l'intagrato lOßi, che “rlcompone”. punto per punto. lo stem codicedel colori presente sugli APPLE.

bmw

I | __ alareiaxruuvn-olieu

miamutdl Ira-a

unu O n. E:
"I 0 | ,Käìš'

Lf! wgnvvmwm.

### .. Emnun r W" I N q A Ji

# ,bl-ML. mm “'IIIII

Flg.. mmmdollonchomlflomeadlqlmtompubmnquubmmllm rlpomfl Mil l eonnnflorl menu!! por lo Mura uplmlonl. 8| Il punnh em hm! I lennlnlll dl quufl conmflofl, nella! I nell collogunonll dl ululonu, sono collegati In plrlllolo. ln quulo lemmi I. connuølonl dol oonndlafl rllulhno vllíl dll buio, momn ml dla-gno dl :Iulm nono vldl Inne- dall'lllo, :la como vlnlbllo In Ilg. 13.

# f ` *_- :ƒz'ä :ff-h' *f*g*

IL. | w | " Ii" | ›- | “' iQIMT. | ' | '7

un"

# "2: Ill! liiii

o..
"- | c ICSI-C

ICI-C

u

myvasuu. | nuuxßzlu
I: 5
Ißlšd | I | ICGS u
"121.m | nlll

u u u ß |
ICSI!

M5 Ummmmm

# › sw.m E m.. m

pjmm m
I ISVIC | EI
'1"
' | W | comu

# ~ n coun

*___-___-

Flg. 1 Se possedete un
monitor a colori con Inom R-O-B, In costituzione della scheda
LXJH, dovrete realizzare questa scheda slglala LXJBS e, coal lecendo, potrete ottenere
Immagini a colori ad alta
dellnlxlone.

Proseguendo nella descrizione. troviamo poi le EPROM del generatore di caratteri I055 (una EPJED/C) collegata al BUS secondario dei dati (vedi lascia con indicato VDO-VD?). che sl collega sul piedini 54-3-2-1-23-22.
Con i'aiuto degli integrati IC49, ICSO` ICS2 ed i053. il codice del caratteri presente sui piedini dl uscita 17-16-15-14-13-12-11-10-8 di 1055. giungerl sulla PROM ICS4, visibile in alto e destra. dalla quale preleveremo i segnali per un monitora colori In lt-G-B, o per un monitor monocromatico (cioe in blanco e nero), oppure per un normale TV In blanco e nero. per portarli al connettore video (vedi
comu).
Poichè un monitor a colori in Fl-G-B richiede del

Flg. e Foto della Interleccla LXJUI. che dovrete Inserire nel computer ae desiderata utilizzare come monitor un
qualalaal televisore a colori o in blanco a nero.
Sul TV a colori le scritte risulteranno umore In
B/N.

segnali diversi da quelli necessari per un monitor monocromatico e diversi sono anche quelli richiesti per un normale TV` abbiamo previsto due schedine esterne da lnnestare a scelta nel connettore di uscita video (vedi CONN.9). e grazie alle quali si potranno collegare indifferentemente al nostro computer, un monitor a colori o monocromatico. oppure un normale TV In bianco e nero.
Poichè siamo passati sul lato destro dello schema eiettrico. proseguiamo la descrlxione con i due “CONNETTOHI GIOCHI" visibili nella parte superiore di tale schema.
Su questi due connettori potremo collegare un qualsiasi JOY STICK, per control lare il movimento delle "astronavi" o dei vari "personaggi" che ani-

### CDNNETTUHE VIDEO

Fig. 0 Schema elettrico della inlerlaccla n.702. lhdlspensahlle per utlllzzare unmonltorlnblaneoeneroounnolmlle TV.

ELENOO COMPONENTI mm
R1 : 1.500 ohm 1/4 'III
R2 : 3.300 ohm 1/4 'III
R3 : 020 ohm 1/4 IMI
R4 : 1.500 ohm 1/4 v1.1!
R5 : 3.900 ohm 1/4 watt
R6 6.800 ohm 1/4 WII!
R1 : 1.000 ohm 1/4 Wall
RI : 41 ehm 1/4 watt
m | 410 ehm trimmer
R10 | 90 ohm 1/4 wlfl
R11 | 20 ohm 1I4 WII!
R12 | .300 ohm 1/4 Will
R13 | .700 ohm 1/4 WIR
R14 | .300 ohm 1/4 vlltl
R15 | 680 ohm 1/4 watt

## 100.000 pr pollame

| 100.000 pF poliestere
| 47 mF eletti. 25 volt
| 100.000 pF polleolel'l
| 100
| mF eleltr. 25 vol!

ll ll U ll Il Il ll

889.822889

.200 pF poliestere

vedi tuto . NPN tlpo 88X10 o BFRJI L$04

cn
m

mano l numerosi video-games. ecc.. disponibili per I'APPLE e per questa specifica lunzlcne abbiamo dovuto Inserire nello scheme elettrico, gli Integrati ICSG, ICGG. l067 ed ICSB.
Scendendo. sul lato destro dello schema troviamo |l Flip-Flop siglato ICH-A e l'operazlenele ICTO. necessari al reqlstretoiev Il connettore posto

### nello schema elettrico vicino all'altoparlante. ci

consentire di collegare a questo computer un qualsiasi registratore e cassetta. ullle per salvare su nastro tutti i vostri programmi.
A chi volesse usare un dltve noppy dieci. tin d'ora possiamo assicurare che il progetto di questa interfaccia verra pubblicato sul prossimo numero della rivista.
il secondo lllp-llop, siglato ICH-B. ed il transistor TH1. cl serviranno per l'altoperlanle, utile per indicare "acusticamente" un errore dl battitura. oppure per creare divertenti efletti acustici nel vi-
deo giochi. | ›
In basso a destra. sempre nella lig. 5, troviamo il circuito composto da lCâO-B. lCS1-D. TR2 e da IC73. cioè lo stadio che genera l'impulso di RESET. (esce sul pledino 5 dl 1073). che ci consentirà. ad ogni accensionev di ìniziellzzare tutti i vari stadi del computer.
Il diodo D82 collegato al piedino 3 dei "CON-NETTORE TASTIERA". cl e utlle per resettare Il computer (agendo sul tasti CTRL - Mela chluse -SYS RES della tastiere), se per un errore dl pro-

### CONNETTORE VIDEO

### gramma o por un comando errato, ll computor si

bloochorì . Controllando la llala dei componenti. potrete no~

tare che I'lntegroto IC73 è un doppio temporizzotore, tipo 556. pertanto, avendone utilizzato una metà por generare l'lmpuloo dI reset, siruttoremo II secondo tomporimtoro por ottenere la lunzlono di “BLINKER”, cioè per lor Iompogglare sul video dei

### oaratteri4

Per terminare, vl dlromo che l'intogroto IC72. posto moralmente al “CONNETTORE TASTIE-RA". urve da lntorioooìa par la lutiora atomo

INTERFACCIA VIDEO BIANCO/NERO

Questa prima intorioocla cl conaontira di collogaro al nostro computer un qualsiasi monitor in blanco o nero o un qualalui toloviaore. :ampio in blanco o nero.
Como vedasi in Iig. 8, quella interfaccia utilizza un aolo integrato TTL. tipo 74LSO4, al cui Intorno sono contenuti l sei Inverter. lndlcall nello schema elettrico con lo sigla lCl.
Tromlio In rote di diodi collegata sulle uscite di questi 6 inverter. tutti i segnali video provenienti dal computer, vorranno aommntl Ira loro` paflanio :ul terminulo di congiunzione dei sette diodi DSG-DSG-DSlO-DS11-DSiì›DSlS-DSN sarà presente il segnalo vlooo oompoallo. che polnmo applicare dirottamento ull'lnorosoo di un quolalul monitor monocromatico.

Fig. 9 Schema elellrico deil'inlerlaccia LXJOS, da utilizzare solo "al dispone dl un monitor a colori con Ingrosso
R-G-D.

ELENCO COMPONENTI LIJI

### R1 : 270 ohm 1/4 watt

390 ohm 1/4 WIR
210 ohm 1/4 watt
90 ohm 1/4 n.11
210 ohm 1/4 WII!
90 ohm 1/4 wall
.000 ohm 1/4 Will
60 ohm 1/4 Will
60 ohm 1/4 In!!
R10 560 ohm 1/4 vllfi
R11 : 470 ohm 114 'III
R1! : 410 ohm 1/4 'III
R13 : 410 ohm 1/4 “Il
R14 : 410 ohm 1/4 WII!
R15 : 60 ohm 1/4 VIII!
R15 : 60 ohm 1/4 WII!
R17 : 60 ohm 1/4 walt
R10 : 68 ohm 1/4 mlt

## c1 = 100.000 pF pollame

### 1111-1114 : NPN llpolflm Il¦1 : SN.14LSM

Per utilizzare invece un normale TV. dovremo necessariamente servirci di un modulatore in VHF ' (un minuscolo trasmettitore).
ll modulatore VHF utilizza un solo translator aigieto TRl . La frequenza di oscillazione vieneetablilta dal valore del condensatore CG e dalla spaziatura tra spira e spira della bobina L1, pertanto ailargando o restringendo leggermente queste spire. ne varieremo la sintonia.
La modulazione dì ampiezza della portante VHF si ottiene applicando il segnale video sulla presa presente sulla bobina L1. ii trimmer R9 ci permettere dl dosare la modulazione, cioe dl impedire che un segnale troppo "torte", sovrarnmoduli il segnale VHF
li segnale VHF modulato. verra prelevato tramite ll condensatore C10 e da questo applicato al cavetto coassiale, che coilegheremo alla presa d'antenna dei nostro TVA

### Come risulta owio osservando lo schema elet-

trico, se per I'uaclta monitor avevamo prima posizionato ii ponticello P1 au A-B. per utilizzare un televisore dovremo ora posizionare P1 su I-C. Per I'alimentazione di questo primo circuito ver-

ZNIZZZ | S

B
Fio. 10 Connessioni
vlete dall'alto dell'inb- | E | c
'rato SNJlLSM e dal
translator, vieta invece
albano. | ISXZ!

ranno utilizzate le tenaloni preeenti sul connettore del computer (vedi tig. 2), cioe i + 12 volt (vedi tenninaie 4 dei connettore video), peraiimentare ii transistor TRI ed i + 5 volt (vedi terminale 2 eui connettore video). per alimentare l'lntegreto lO1.

INTERFACCIA COLORI RB...

Questa seconda interlaccia (vedi tig. 9), ci permettere di collegare al noatro computer un qualsiasi monitoracolori in lt-G-lesequeato risultadl qualita , otterremo il massimo della risoluzione e della delinizione dei colori.
Anche in tale circuito troviamo un integratom tipo "LSM, (vedi i 6 inverter siglati lC1), che utilizziamo per amplilicare e squadrare iaegnall video provenienti dal computer.
ln questa scheda. anziche sommare tutti i segnali. come avevamo tatto precedentemente sulla scheda di lig. 5, ne sommeremo solo duepercanalel in modo da ottenere in uscita i tre colori tondementaii H-G-B (roaeo. verdev blu).
Più precisamente:
IC1/A, ICI/l ci sommerenno i due segnali RM ed FlL. relativi ai codice del ROSSO.
lc1/C. Ici/D ci sommeranno i due segnali GM e GL relativi al codice dei VERDE. (La lettera G ata per GREEN che. in ingiaae, aignitica appunto “verde").
Ic1/E, IC1/Fciaommerennoiduesegnali BMeBL relativi al codice dei BLEU.
i tre aegnell sommatl dalle coppie di resimnme R1/R2-H3/R4-R5/R6. verranno amplificati in corrente dal tre transistor TR1, TFl2 e TM.
Dagli emettitorl di questi transistor il segnale verra poi applicato sul connettore di uscita dal quale potremo poi preievario, per lneerlrlo aui monitor a colori.
Il translator TR4 presente in tale scheda (collegato tramite ia resistenza R7 ai terminale 5 siglato SVNC), lo utilineremo per amplificare eernpre in corrente il eeonele dl elncrenluno da applicare ench'eeso al monitor.

UN ALIMENTATORE SPECIALE

Per alimentare questo computer etrbiemc progettato un circuito Inedlto. che impiega un trader'-metore toroldele di qualita . Poichè le massime correnti aaeorblte sl verifica-

no aulle due tensioni dal 5 volt positivi edel 12 volt positivi, abbiamo realizzato un circuito "avrichtlng", onde evitare di utilizzare alette di ratlreddamento mastodontiche e di inserire della ventole perespellere tutto il calore generato da un normale alimentatore lineare.
Per aempiilicare lo schema, in questi due stadi

“awichtlng” abbiamo Impiegato due Integrati L296 (vedi i e l02). appositamente studiati per tale funzione, in grado di erogare picchi massimi anche di 5 amper.
Sulle uscite delle due lmpedenze JAF1 e JAF2 avvolte su due nuclei loroidali. sono presenti le due tensioni richieste perfettamente stabilizzata. che potremmo gia inviare alia scheda del computer, ma, per questo DELTA. abbiamo voluto aggiungere un qualcosa in più .
.- Sapendo che per un lnvolontario errore. la tensione in uscita potrebbe superare il valore prestabilito. con Il pericolo quindi di bruciare tutti gli Integrati del computer. senza troppo complicare lo schema. vi abbiamo aggiunto un "efficace" circuito di protezione.
Come vedasi in fig. 12. in parallelo alle due uscite e dopo i lusibili indicati con le sigle F2 e F3. abbiamo inserito due diodi SCR. collegando il "gate". al piedino 15 dei due integrati stabilizzatori L.296. Se per una malaugurata ipotesi la tensione dovesse salire bruscamente fino a raggiungere valori pericolosi. immediatamente i due SCR si porterebbero in conduzione. "cortocircuitando" l'usci~
fa.

### ln tale modo. alla scheda del computer non

giungerà più alcuna tensione "dislruttrice". e. saltando i due fusihili F2 e F1. il resto del circuito non correre più alcun pericolo.
Per le altreduetensloni richieste. cioè perquella dei 5 volt negativi e per quella dei 12 volt negativi, considerato il basso assorbimento. abbiamo utilizzato direttamente due integrati stabilizzatori uA.7905 e uAi7912. indicati nello schema elettrico con le sigle ICJ e lcd.
Risultando gia completi di una sufficiente protezione nei confronti del cortocircuitl e considerando che le due tensioni servono unicamente per alimentare le periferiche aggiuntive sul sette connettori. o per ottenere tensioni di polarizzazione. 'risulterebbe superfluo Inserire anche au dl esse altri due SCR, perche. anche se accidentalmente dovessero raggiungere valori elevati. Il computer non sublrebbe comunque alcun danno.

REALIZZAZIONE PRATICA

Proouratevi un piccolo. ma buon saldatore, perche in tale scheda dovrete ora saldare ben 75 zoccoli per integrati e se eseguirete delle saldature fredde o vl dlmenticherete di saldare anche "un solo piedino". il computer non funzionerà . Noi abbiamo cercatodi agevolarvi In tale compi-

to. lasciando"scoperti" equindi ben visibili. rispetto al verde della vernice che ricopre tutte le piste del circuito, solo i "punti da saldare".
ll segreto del perfetto funzionamento dl questo computer consiste nelle saldature. e di questo siamo più che certi. perche da oltre un anno montìamo e rimontiamo diversi prototipi e tutti. a mon~ taggio ultimato. hanno "sempre" funzionato.
Se qualche volta ciò non è avvenuto. sapevamo gia che per una disattenzione avevamo inserito un integrato in uno zoccolo sbagliato. e. infatti, rimettendolo nei suo esatto zoccolo. il computer riprendeve immediatamente a funzionare
Le operazioni che dovrete compiere per non dimenticare neanche una saldatura. saranno quelle dl inserire uno zoccolo per volta. di saldare tutti l relativi piedini. passndo poi ad un secondo zoccolo e cosi via. lino ad avere la scheda totalmente ricoperta di zoccoli.
Eseguite questa operazione. potrete inserire nelle posizioni visibili ln fig. 13. tutte le resistenze, i pochi diodi. non dimenticando dl collocare la lascia che contorna il corpo come visibile nello schema pratico.
Per evitare ogni possibilità di errore. troverete riportato su ogni circuito stampato un disegno serigralico dei simboli, con accanto indicata la relativa sigla della resistenza del diodo o del condensatore.

K A

## BYWIO

### MAZ lì Tl'lllC

### M E U pATUIli-IA'IQIZ

Flg. 11 Connessioni dell'lntegralo LJ” dal diodo achotllty BWIM) del trlac plaattco a del due integrati stabilizzatori implagatf nello afadio dl alimentazione.

Flg. 12 Schema omlrlco doll'nllmcnhwn pu ll compuhr DELTA. Como :pm mll'afllcolo. domh nulocoslrulul la due Impødcna JAFl o JAF2. lmlgundo lul nuclio Id mollo prucnlø nel klt Ilapln con Illo amalblo da 1 ,2 mm. A dmn In 1110.1. hmlunl, call come uoclrlnno dal CONNJ.

ELENCO COMPONENTI LXJH | €15 - 220.000 pF polieslere
00.000 pF pullula"
ll1 - 15.000 ohm 1/4 will | | 220.000 pF pollulen
1500 ohm 1/4 ma | | uomo pF pallam-
00 ohm 1/4 volll | | dlcdo Schollky BYVIM
.100 ohm 1/4 wall | | diodo Schollky DYWM
4.100 ohm 1/4 wlfl | .IAF1 : 300 mHenry
15.000 ohm 1/4 will
100.000 pF 900001010
4.100 mF elellv. 50 M
2.2 mF elettr. 63 vali
300 pF I disco
22.000 pF polluti"
100 lnF del". 35 'dl
1m mF eum. as vøll | | mp!
2.200 pF pollame | R52 | ponte mldrln. 1lll 'dl 1 In..
2.2 mF elellr. 63 volt | F1 | lullblle 1 A
C10 : 300 pF a disco | F2 : lunlblles A
€11 : 22.000 pF pullman | F3 | luslblle 5 A
C12 : 100 mF elettr. 35 volt | 11 : lnllumlllørl (n.101) mbflnll
C13 : 100 mF elellr. 35 vol! | | sec/26 volt-3 ampeflfls volt-0,5 lmpu)
C14 : 2.200 mF elellr. 25 vol! | S1 : lnlerrullore

# Qflfiäâflfl

ß

# flåãšãš

Sl'llfll | A v | m | E"Il/1 | SIMLSS!

f

g”

mln/x

e
sumsm
Q | m

snmsm

%

SNNIS'SJ

Il U i É mai!

mau/4

a | ß
:1|aq

m
sumslzs | Sumsls:
° | < f | man/s | smalsnz | sumsls: | SNNLSJM
SNTILSMI | SNHLSJM | sun 15245
Sir/.LSI | SNNLSEJ | a"
*% (5%
snmszsl | 'HI/'i

SNMLSZEI

SNMlSZN | 331741515!
Wlìlmflflli YlSTlflÃl | | sumssn
† | _\
. ›-. 1 -_ | .con

_E
SIUMS). | E97" 7 | IMSJYI

l
WW' | :umsm | u

i'
i 5

SNNLSW
SiNLSM | EFNü/ì

## FIl- 13 Summa Meo dl manna»

### “Mb-lim

Slfllßzfi
ICO]
r' v

SVINlSII

EPnu/l

SNTÃLW e
_ | "238 | ` v «susa | YYYYYYYYV | mumu "MANU | uu" | ` menu | Smnsxu | .www

gn ICH

su MLSIN

K: sumsm

m mangi!!
P'I
a- sumszsl
IC19¬¢

## ~ v v v y v v v

l ü!

Pi | "mi In_Y Y _' ` Y _' 'I

# mi: .@n_

| g_v ' f v ' r
“HQ MWx I

Proseguendo. monterete tutti icondenmtori poliesterl, ricordandovi che tutti quelli siglati 05 (per un totale di 32 condensatori), sono da 100.000 pF (sull'involucro troverete la sigla .1 mF). e pol i pochi elettroliticl. rammentando dl rivolgere il termi-
nale positivo verso il segno +.
Il quarzo siglato XTAL. contrariamente a quanto disegnato in tig. 13 dove è raffigurato in posizione orizzontale. lo potrete anche tenere in verticale. l tra clps di resistenze. vedi R2 collocata sopra a lCß, H1 sopra e IC9 e R1 posta vicino al connettore di uscita CONNJ. li dovrete inserire nei circuito. controllando che il "punto" di riterlmento riportato sull'invoiucro risulti rivolto comevedesi nel disegno. cioè per la R2 verso destra e per le R1 ed R1 verso sinistra.
Nelle posizioni riportate. lnserirete tutti i piccoli connettori maschi siglati Pt-PZ-Pa. ecc.. sui quali dovrete poi inserire gli spinottl dl cortocircuito secondo l'ordine che, a tine articolo. vi lndictieremo. lnserirete anche i due transistor. ricordando di rivolgere il lato piano del transistor plastico TR1 verso sinistra, mentre per ll transistor metallico TR2 la tacca sporgente andrà rivolta verso il condensatore 019.
Sul lato destro dl tale schema inserirete i sette connettori. cercando possibilmente di collocare la tile indicata B in basse e quella Indicata A In alto. questo solo per avere un rllerlmento che corrisponda a quanto riportato nello schemaelattricodi
rig. 2.
Per completare questa scheda manca il CONNJ! (vedi in alto a destra). necessario per il connettore iammine che parte dall'alimentatora. poi il connettore CONN.9 posto in basso. necessario per Insanre le schede per l'uscita Video, inline il connettore CONN.11. nel quale potrete inserire un qualunque Joystick da “video-games" ed inline i due spinotti

### femmina tipo Jack. per prelevare dal computer i

dati da memorizzare su dl un comune registratore a cassetta (vedi presa "uscita"). oppure per leggere dal registratore l dati precedentemente salvati (vedi presa "entrata").
Facciamo presente che per l "giochi" dovrete utilizzare lo zoccolo a 16 piedini índ lcato CONN.12: oppure` potrete servlrvi del connettore CONN.11 per quei Joystick da video-giochi, che dispongono di una tale presa maschio a 9 piedini.

## Per ami i Joystick APPLE per videogames che

dispongono di un connettore a 16 piedini disposti

### su due iile da 8 piedini ciascuno. dovrete necess-

riamente utilizzare iI CONN.12,
Polche tale connettore e del tutto simile al contenitore di un qualsiasi integrato e dispone di una tacca dl riferimento In corrispondenza del piedino
1. dovrete. sulla sua presa. rivolgere questa "tacca" verso la scritta CONNJZ.
Per collegare al computer la tastiera AiƒANU-MERICA si utilizzerailCONN.10. posto in basaoa sinistra nello achema di tig. 13 e. a questo punto. sara utile precisare quanto segue:
- La tacca di riferimento del connettore maschio andrà rivolta verso SINISTRA.
- La TASTIERA che vi torniremo, e gia completa di interfaccia SERIALE/PARALLELO con stan~ dard APPLE 2 e. quindi. utilizzando l'interlaccia che troverete ail'interrio della contezione della tastiera completa della relativa plattlna gia cablata. la dovrete solo innestare nello zoccolo sul "connettore tastiera" CONNJO. come visibile nella toto di tig. 17
- Se disponete di un'aitra qualsiasi tastiera AP-PLE 2 compatibile. potrete tranquillamente utilizzarla innestando le presa di uscita nel “connettore tastiera", rispettando la numerazione dei piedini riportata In tig. 19. cioè ii piedino 1 dello zoccolo andre rivolto vero il ponticello P8 ed Il piedino 16. ovviamente, verso IC.72.
- Poichè da tale connettore vengono prelevate anche le due tensioni di alimentazione per gli integrati della tastiera, tate attenzione a rispettare esattamente tale disposizione. per non invertire le tensioni di alimentazione e danneggiare cosi la vostra tastiera. Nello zoccolo troverete sempre incisa Ia numerazione 1-8 e 9-16. Terminato il montaggio, vi consigliamo di veriticare con una lente d'ingrandimento tutte la saldature di ogril zoccolo. perchè se avrete dimenticato anche solo un piedino. non potrete poi pretendere che il computer funzioni.
Dopo aver eseguito questo controllo. potrete iniziare ad Inserire negli zoccoli tutti gli integrati. veriticsndo attentamente che l'integrato che Inse-

### rirete in quel detemilnato zoccolo sia quello ri-

chiesto. e non dimenticando dl rivolgere. come vedasi nel disegno. la tacca di riferimento verso sinistra. esclusi l soli integrati lC62 < ICSS - ICS'I. peri quali andrà rivolta verso il basso. Neil'inserlre l'lntegrato. controllate che tutti I piedini si innestino nel proprio vano; diciamo quasto, perche spesso, risultando questi piedini molto divaricati, una iila s'lnnesta in modo perfetto, mentre I'altra rimane tuorl sede
Se vedete che i piedini sono molto divaricatl. anziche restringerii uno per uno con un paio div pinze. appoggiate un lato deil'lntegralo su un piano del tavolo. pol tate pressione e subito vi accorgerete che tutti l piedini si ripiagheranno leggermente ed in modo uniiorme verso l'lntemo. ed ln questo modo. entreranno senza alcuna difficolta nelle due tile degli zoccoliV
Completate anche questa operazione. metterete questa scheda in disparte. perchè ora vi converra montare lo stadio alimentatore e la scheda Intertaocia Video.
Prima di passare a questa reallzmzione vi diciamo ohe. per questo computer. abbiamo realizzato

..__-uso. ga!! ..oo 2:..

.2. 8.... .._ .2...- . .3... :_ .2

## ...8... __. :28..šsi .az .ãn

.8. . STE-..5x 22... i.
.._-..E3252 _u ugo.. ...v ...o

...È- oãiicø 2-2::- Bua-.u

.n _... Se _< ...2.2.5. 2.8..

## .5 .a 22 ._ 2-. _.. u :2255..-

oì- ..__-_. 238.5.: ì ..uz-:_
'EQ-0- o. ...non _:O 3 .ai

›...›!

Flg. 15 Salumi pratico doll'lnllrhoda LX.182 mentali.. a Il utlllm un monito' o TV. Ouuh ichidl andrà ncchlull .niro un continuare matllllco come
"dal qul nono. ll conmflon posto In bano lo lnnuhrnh sul CONN.9 dl "5.13. Non dlmenllu-M dl lnnrln la :him dl carloelrculto sul common P1.

Flg. 16 Schema pratico dall'lnlullccla LXJIJ. da utlllum lolo u Il dimm dl un monitor l colori con lngnuo R-G-B.

ma
“WI Ill

Y, ..vun elegante mobile. al cui lntemo troveranno posto anche due drive floppy.
Poichè questi contenitori il facciamo preparare da industrie specializzate in mobili metallici per apparecchiature elettroniche, che per eaegulre atarnpi, eerlgrafla. verniciatura e fuoco, ecc., cl chiedono perla coneegna un minimo di 80 giorni (abbiamo effettuato gli ordini ai primi di Novembre. pertanto. la coneegna dovrebbe avvenire alla fine di Dicembre). pertanto non ci estate poeeibile disporre dl un prototipo completo per iotogralario (la riviate anche ee eece ore in edicola, e andata in stampe Il 30 di ottobre). poiche la lavorazione viene effettuate in eerìe.

### Cioe. vengono prima trancietl tutti i pezzi, poi

foretl. rlpiegatì, infine ealdatl, dopodiche vengono tutti verniciati ed inline aerigraleti: pertanto. al momento della consegne. ritiriamo 2000-3000 mobili contemporaneamente e solo allora abbiamo le possibilità di fotografarll.
Perlleeare tutti iclrcuiti atampatientro il mobile. abbiamo utilizzato supporti in plaetlca eutoadeeivl. Come potrete constatare.al lnlllerenno l perni dl queetl aupportl nel forl preeenti In ogni circuito atampeto. pol sotto alla loro beso al togliere la carta protettiva, mettendo coat e nudo Il collante adeaivo. Pigiando fortemente sul piano dei mobile, questo eupporto al Incollere tenacemente.
Per togliere In seguito il circuito stampato dal mobile. occorreràeoio etringere Il gancio di fermo.

WPRATICA DELL'ÃLIEN'I'ATOE

Sul circuito elglato LXJBL monterete tutto lo stadio alimentatore come vleiblle in flg. 15.
Prime di iniziare ll montaggio. dovrete prenderei due nuclei delle due impedenze JAF1 eJAF2 e con li filo di rame arnalteto da 1,2 mm.. presente nel kit, dovrete avvolgere attorno a questo anello. eaattamente 4B epire.
Non dimenticatevi di nechlare ie eatremita del due termineli da saldare eul circuito stampato. W aendo ll filo protetto da uno etratodl vemlce isolante. A questo punto. potrete iniziare Il montaggio. lnaerendo nei circuito stampato tutte le reeletenze.
e. eucceaeivernente tutti i condenaatorl poiieeteri. gli elettroliticl. rispettando la polerlta dei terminali; potrete quindi proeeguirecon idue portafusiblli. le due moreettiere ed li connettore siglato CONN.8. Prendete ore l due SCR plaetlci ed lnaerlteli con l'aletta metallica rivolta vereo l condensatori elettroiltlcl C7-C12-C13.
Ineerite anche il piccolo ponte raddrlmtore R52 e, prima di proseguire. poiche nel disegno pratico non eono presenti. vl diremo che al due lati di questo circuito stampato andranno applicate due lunghe alette di raflreddamento (vedi lig. 17). au una delle quali andranno fieeatl l corpi dei ponte raddrizzatore R81 del diodo DS1 deil'lntegrato IO!

(I due integrati i013 e IC4 non vengono montati eull'alette). mentre auil'altra l corpi di IC2 e del diodo DS2.
Pertanto. quando liseerete sul circuito stampato li ponte raddriuatore R81. dovrete ripiegare l auol quattro terminali e L. rivolgendo vereo l'aito il terminale NEGATIVO (che dovra eeaere posizionato aulia deetre) ed uno deldue terrnlnali di "alternata" (che dovre eeaere posizionato sulla elnletra): di coneeguenza, vi ritroverete con Il terminale POSI-TIVO rivolto vereo il basso sulla elniatra. pereeeere direttamente inneateto nel circuito atempeto (vedi tig. 14).
Proseguendo verso destra. inaerirete il diodo raddrlzzetore DS1 (che ha la forma dl un translator. ma con due eoll piedini). pol l'integrato lCl. Infine ICS e ICÀ.
E owlo che. prima di saldare tutti questi componenti. dovrete controllare che i fori di fiangglo ai trovino ln aeee con oueiil praticati aulie alette di raffreddamento.
Passando ali'aletta oppoata, llaeerete l'lniegrato I02 ed il diodo D82.
Per terminare II montaggio. lnneeterete ora le due Impedenza JAFl eJAF2 e. a queeto punto. ee ineerirete anche l due tuelblil ll circuito rleultera completo.
Non dimenticatevi dl lnaerlre tra li corpo dei due diodi 081 e DS! e la superficie doll'aletu di ralfreddemento le due MICHE ISOLANTI. che troverete nei kit ed anche di ínneetare nelle due vItl dl lleaegglo le due RONDELLE lSOLANTI, perche ll corpo di queetl due diodi debbono rlaultara elettricamente lSOLATl del metallo delle due elette. Per quanto conoeme i due integrati IC1 - lCZ ed il corpo del ponte raddrizzatore RSI. non andra applicata alcuna mica isolante.
Come vedeel in llg. 17, i'allmentatore andra flauto entro al mobile. tenendolo auila destra del circuito stampato del computer. ll traeforrnatore d'r llrnentazlone toroidale T1 andre rivolto vereo lI pannello frontale. per poter coai inaerlre direttemente l auol fili nella moreettiere a 8 ingressi. Per questo computerabblamo pure previsto una l'speciale preea rete" (andre fieaata eui retro dei mobile). completa di eplna con prela di terre. dl fueiblle di rete ed anche dell'interruttore generale dl accensione.
Sul pannello frontale andre pol fienta una piccole apie al neon e 220 volt, che allmenterete direttamente con ia tensione cheentrera euil'lngreeeodel traeformatore T1 (la tensione dovrà eeaere prelevata dalla moreettlera poeta vicino al conden-tore elettrolitico C2).
Sui retro di questa "speciale preae rete" rieulteranno presenti tre terrnlnall. che dovrete collegare alla moreettlere a 3 poll (poeta vlclno ai fuaiblll), rammentando che li illo centrale. indicate I. e

101 quello dl MASSA. più precisamente la presa di

### terra chedovrebbe risultare presente inognl presa

rete a 220 volt.
Dali'altro lato. cioe sulla morsettiera a B poll.

### partendo dal basso verso l'aito, sono presenti:

morsetti 1- 2. A questi due morsetti collegherete il secondariodel trasformatore Ti a 15 volt (questi iilí dovrebbero esare di colore ROSSO e piú grossi). morsetti 3 - 4. ln questi due terminali e presente ia PRESA TERRA della rete a 220voit. pertanto. a uno di questi morsetti collegherete un filo. che congiungerete ai metallo della scatola dei mobile.
morsetti 5 - 6. ln questi due terminali e presente ia tensione dl rete a 220W". pertanto. ldue lìli d'ingresso dei trasformatoreTt andranno iisseti su questi due morsetti. raschiando i due illi per togliere lo smalto isolante. morsetti? - 8. in questi due terminali collegherete il secondario dei trasformatore Tt. che eroga 28 volt (questi iiii dovrebbero risultaredicolofe GIALLO). Per trascorsa esperienza. vi consigliamo sempre. prima di collegare un trasformatore. di controllare con un tester la tensione erogata dai suol secondari, perche puo verificarsi che. senza saperlo. ci consegnino trasformatori con i colori dei secondari lnvertiti. per cui e meglio perdere due minuti par un tale controllo, che Incorrere in spiace-
voli inconvenienti.
Anche per fissare questo stampato sul mobile, abbiamo utilizzato dei distanziatori plastici autoadesivl (più alti di quelli usati per il circuito base Lx.1eo).
. Le due alette di raffreddamento possono anche rimanere volanti. comunque se ritenete valido rendere questo montaggio più stabile. potrete utilizzare due piccole squadrette s L. per fissare. su entrambi i lati. ie due alette ai piano del mobile.
Per il fissaggio dei trasformatore toroidaie dovrete utilizzare una sole vite. che inserirete ai centro dl tale trasformatore. non dimenticando dl sppilcare sopra e sotto. ie due grandi rondelle dl plastica.
Una volta terminato ii montaggio. potrete con~ troliare se sul connettore di uscita CONN.8. sono presenti tutte le tensioni indicate nello scheme pratico.
Per portare queste tensioni dallo stadio di alimentazlone alle scheda CPU dei computer, avrete a disposizione due connettori completi di clriava. cioe due connettori che si innesteranno nello zoccolo solo nei giusto verso. per scongiurare Ii perlcoio di applicare alla CPU tensioni invertito. o dlverse al richiesto.

INTERFACCIA USCITA TV

La prima interfaccia indispensabile per lavorare su questo computer ela scheda utile perfarapparire sullo schermo di un qualsiasi TV. tutto quanto viene digitato su tastiera.
Ovviamente sul TV. anche se a colori, vedrete ie scritte in bianco/nero. Per ottenerie in colore, occorre. in sostituzione del TV. un monitor a colori con uscita RGB.
Tra qualche mese prepareremo anche una interiaocia a colori. perche possiate sfruttare il vostro comune TV color. in sostituzione dei monitor.
Lo schema elettrico di questa parte di circuito e visibile in fig. 8. mentre in tig. 15ev|sìbile il relativo schema pratico.
Montare questa scheda è molto semplice. Dopo aver inserito lo zoccolo per I'integratc ICi , saiderete di lato tutti i diodi ai silicio, rivolgendo ia lascia che contorns il corpo verso IO1.
Parallelamente ai diodi. lnserlrete tutte ie resistenze ed Il trimmer quadrato R9. poi. proseguendo, tutte le altre resistenze. l condensatori. e li diodo zener DZi
in basso inserirete il connettore maschio con l terminali ripiegetí a L e sulla destra il connettore a tre terminali. siglato P1.
in questo stesso circuito stampato inserirete anche ia presa uscita video. sulla quale lnnesterele poi lo spinotto maschio collegato ad un normale cavetto coassiale per TV. che. dal lato opposto. coliegherete alia presa f'antenna" del vostro televisore.
Proseguendo. inserirete anche il transistor oscillatore TRI. rivolgendo la tacca sporgente dai corpo verso destra.
A questo punto potrete iniziare ad avvolgere la bobina L1 e perfar otiesto dovrete procedere come

### segue:

- prendete lo spezzone di iiio di rame argentato da 0.5 mm. inserito nei kit e sopra ad un supporto cilindrico da 6 mm. avvolgete 7 spire affiancate, poi allungato Il tutto. in modo da ottenere un scienoide lungo esattamente 13 millimetri.
- inserite questa bobina nel circuito stampato, tenendola distanziata dal piano di 1 mm.
- Dopo aver saldato in modo perletto questi due till. con un corto spezzone di illo (anche più sottile). ettettuarete la presa centrale. ealdandolo auiie 3.5 spire. dopo averlo infilato nel foro del circuito stampato e qui saldato.
La bobina da noi consigliata oscillera sulla frequenza di 65 MHz circa. cioe ln gamma VHF canale B; pertanto, se nella vostra zona in questo stesso canale e presente una emittente TV che disturba lo schermo. potrete ieggennente rastrlngeria o allargaria e spostarvl cosi In frequenza.
li circuito montato. andra racchiuso entro una

## Illl-llllllll

Flg. 11 In questa Ioiovl lndlchllmocorm vorrà nun. :ul Muro mobile, In aelred: dl quinto compulor, completo oil tuo allrncnhlon. In mo a slnlllu, pole! notre Il trullomllton loroldllo dl lllmonlulono e dl fianco. lo lhdlo dl ullmenhzlnne glù complolo delle due Ilolll dl nfinddnmonlo, neque, lnflne, la prua dl rete (fluah lul mobile), completa dl luslhllood lnhmmunr a, loflo ad un. I'alloperlanle. In bauo I destra. con la piattini che .com lungo Il bordo del computer lbbhmo llmlo. sul retro del moblle, l'lnhrlaocla hill-ri vlslhllo In '19.19. Nel collogare ll common dl quuh pllfllnl cuenta dl non lmmrlrh, mll'mlcolo Ibhllmo lplcøllo chiarimento come dmn-h collegarti.

Flo. `Il Per portare tutte lo tensioni erogate dall'aiimontaton alle scheda base (GONNA), dopo aver tagliato cinque apemnl dl iiio ri~ coperto in plastica, ne aalderete le estnmitl

## ml piccolo mimmo metallica vlusllø in rigun

ed, eeequlta questa oporlzlone, lo splngonh con tom aii'lnteme della custodia In plastico.

piccola 'scatola di alluminio gle iorats. che lo echennerl totalmente. e per iissare questo circuito entro tale scatole dovrete servirvl ancore del supporti autoadeelvl. precedentemente menzionati. Ouestl ultimi avendo una base molto larga, endranno tagliati. per dere el coperchio la possibilità dl chiudersi.
Quando coilauderete questa interieccla. dopo aversintonlzzete Il TV sulla gamme VHF, provate a sintonizzarlo da un estremo all'altro delle gamme. per evitare di sintonizzervl. su di una irequenu armonica. lnlatti. se troverete due "punti" di sintonie, uno di essi risulterà sempre più potente come segnale.
Slntonlzzato ll TV, dovrete in seguito. sperimentalmente. ruotare il trimmer R9, ilno n quando ie scritte da vol digitate risulteranno sullo schermo ben nitide e localizzate.

INTERFACCIA A COLORI USCITA ROI Questa seconda Interfaccia la realizzerete solo se evete già a disposizione un monitor a colori con ingresso Ft-G-B. ll montaggio di questa scheda risulterà più semplice rispetto eoueilo della precedente. perche. come vedesi in tig. 16. su di seu dovrete solo montare lo zoccolo per i'lntaqto lC1. un condono-tore poliestere, 16 resistenze e I vquattro transistor metallicil rivolgendo verso de-
stra le tacca di riferimento che sporge del corpo.
Per completare questa schede dovrete saldare. In basso. Il connettore maschio a 13 terminali e di leto. il connettore iemmine e vaschette, entro al quale lnnesterete la presa maschio che esce del
monitor a colori.
Non dovrete racchiudere questo circuito entro alcune scatola scherrnante. quindi. una volte ultimato, lo potrete innestare direttamente sul connet-IOrB CONNB visibile in ilg. 11.
LI Milone del PONTICELLI
Sulle scheda base dei computer riportata In tig.
13. sono presenti alcuni ponticelli. che dovranno essere predisposti, come vi spleqheremo qui di seguito.
Vicino e tutti questi ponticelli. siglati P1 - P2 - P3, ecc.. troverete anche due lettere.Aec. (il termineie B e il centrale).
Inserendo le spina lemmine rivolgendola verso ie lettere A, il ponticello risulterà APERTO. mentre rivolgendola verso le lettere t:v ii ponticello risultera CHIUSO. cioe ll terminale centrale B verre cortocircultato su C.
Per un corretto lunzionamento dei computer. dovrete predisporre questi ponticelli come segue:

Pig. 19 Questa lntorincciaohovi londnmo gli montata miomeolla tastiere, vl servire per collegare la piattino che lnnntcrete nel connettore CONN.10(| 16 piednl) posto sul circuito bose (vedi tlg.1¦t)ln bosco a sinistre.

### INTERFACCIA TASTIERA

M = verso A (ponticello aperto) - Questo ponticailo porta il segnale ABTLTX sul solo connettore dl espansione 1 (vedi nello schema elettrico dl iig. 4 CONNJ) e sl users solo per applicazioni video particolari (ad esempio per rendere compatibili i colori APPLE con l colori standard del TELE-TEXT). Quando vi presenteremo questa interloccia da Inserire nel connettoredl espansione 7. eliora questo ponticello andre rivolto verso C.

P2 : verso C (ponticello chiuso) - Ouesto ponticeiio porta Il segnale dl SYNC solo ed esclusivamente sul connettore di espansione 7 (vedi CONNJ in ilg. 4). pertanto, come P1 questo cl servire solo per applicazioni video particolari.
PS : verso A(pontlcello aperto) - Questo ponticello serve per eliminare li colore delle pagina video. Questa tunzlone e molto lmpomnte quando. utillzzando un monitor o TV In blanco e nero. sl desiderano struttare del programmi utilizzati per monitor a colori.
Polche ad ogni colora corrisponde. sul blanco e nero. un diverso livello di grigio, alcune scritte In colore risulterebbero. su un normale monitor In bianco e nero, poco l“leggibili”.
Ellmlnando II colore, scompariranno tutte le "sfumature" e, pertanto. sullo schermo l contract! risulteranno più netti. Utilizzando un monitora colori RGB. questo ponticello andre eu C.
M : verso A (ponticello aperto) - Questo ponticello college il piedino 11 di ICSB el piedino 12 di ICST e serve per abilitare la pagina video ad attieellna risoluzione (560 x 192 puntl a 6 colori). Poiche nella maggioranza dei programmi grallci per I'APPLE. questo ponticello dovrà risultare rivolto verso A. Solo chi aoqulstera dei programmi ad "altissime risoluzione". dovrà rivolgere questo ponticello verso C.

### i": verec A (ponticello aperto) - Ouasto ponti-

ceilo non e riportato sul lato superiore dello stampato. ma sl trova lotto ad esso. In prossimità del tenninall della resistenze R13 (si noterenno due bollini a ionna di D). Soltanto per tuture applicazioni, queste due piste dovmnno essere collegate tra dl loro. ma dl cio parleremo. quando presenteremo queste particolari Interlacce.
PI = verse C (ponticello chiuso) -Serve percollegare I'lngresso SWO della tastiera al piedino 2 dl lceo. Questo segnale corrisponde al tasto delle MELA APERTA evlene utilizzato come uno del due pulsanti presenti sui JOYSTICK. percomandare il movimento del personaggi o delle varie "astronavi" dei numerosissimi video giochi disponibili par I'APPLE.
Polche ail'lntemo del JOYSTICK sono gia presenti tali contatti. se collegate stabilmente un Joystick el computer. potrete anche lasciare aperto tele ponticello. escludendo le funzione della MELA APERTA sulla tastiera. Lesciandolo CHIUSO. come nol ore consigliamo. questa funzione verra svolta contemporaneamente dal Joystick e della tastiera.
P1 = verso c (ponticello chiuso) - Questo ponticello, analogamente a P6. se lasciato aperto ellmlna dalla tastiera la funzione della MELA CHIUSA (vedi segnale SW1).
PI : verse A (ponticello aperto) - Anche quest'ullimo ponticello agisce su di un aegnsle proveniente dalla tastiera (vedi AKD sul CONNJO posto In basso al centro nella ilg. 5) e serve per adattare al nostro computer diversi modelli di tastiera. Esiettr no intatti alcune tastiere particolari che. al poeto del segnale di STROBE presentano ln uscita Il eegnale di AKD (Abbreviazione dall'lnglese "Any Key Down" che. tradotto. signltica "un qualunque tasto premuto"). Se disponete quindi di simile tastiera (nella note della tastiera e sempre speclilcato ee e presente tale segnale). potrete utilizzarla spostando ll ponticello P8 su C.
Dopo avere posizionato tutti l ponticelli come vi abbiamo appena descritto. potrete collegare alle piastra principale, sia la tastiera, che l'allmentato-
re.
Per l'alimentstore (vedi tig. 1B) dovrete prepararvi un cavetto di connessione. utilizzando le due prese iemmlna volanti che troverete nel Kit.
Come riportato in ligure, dovrete preparare cinque spezzoni dl liio di Identica lunghezza e. quindi. saldare al due capi di ciascun (lio ia piccola spira metallica che andre inserita all'intemo della presa. Fatto questo. Inserite a iondo ciascuna spina all'intemo del supporto plastico. (lnoa quando non avvenlrete un leggero "scatto". che aegnalerl che la spina metallica e saldamente Inserita all'intemo della presa.
Per ll connettore della tastiera. invece. non dovrete realizzare alcun connettore` in quanto lo troverete gil pronto all'intemo della contezlone della tastiera stessa, assieme all'intertaccla, che llsserete sul lato posteriore del mobile.
lntattl. all'intemo della scatola della tastiere tro-

### verete un piccolo stampato con un connettore in plastica ed uno zoccoic da stampato: nel connetto-

re andra inseritaie presa posta sul (ilo della tastiere, mentre sullo zoccolo per integrato andre innestata la pisttina pinzata tornlte assieme alla tastiera. L'altro estremo della piattina andra pol inserito nello zoccolo per integrato posto sulla scheda principale. Come vlslbiielnilg.11.lo zoccolo a16 piedini gia cablato su plattlna. andre inserito nello zoccolo presente in tale interiaccla con il lato stamplgllato 1-16 rivolto verso II basso. NON IN-VERTITE questo connettore nello zoccolo. se non volete tar giungere alla tastiera unatensione Invertite di polarità .
105

## Fl.. zo

ACCENDIÀIIO IL COMPUTER
Terminato il montaggio ecoiiegati l'allmentatore e ia tastiera. il vostro computer DELTA sara gia pronto per I'uso. Dopo aver accuratamente ricontroilato che la presa per I'elirnentatore sia stata inserita correttamente, cosi come il connettore delia tastiera. potrete collegare i'uscita deli'eitopar-

### iante sulle apposita presa. posta in basso a destra

(vedi prese l'ialtopisriante"), utilizzando un filo biliiare e i'apposita spina iemmina. Senza collegare sul CONN.9 I'interfaccie video. fornite tensione ai computer agendo suli'interrutore posto sul retro del mobile.
L'altopariante dovrà subito produrre un breve ` suono. che vI indicherà che tutto il circuito e perfet-

tamente funzionante.
Ottenuto questo "BEEP'. potrete spegnere nuovamente il computer e collegare I'lnterteccia video neceeaarla ai vostro caso (cioe ii circuito LXJBG. se disponenie di un monitor a colori in R-G-B. oppure il circuito LX.782. se disponete di un monitor in bianco e nero o di un normale TV). Rieccendendo li computer, dovrete ruotare la sintonia dei vostro TV (posto in gemma VHF). fino a trovare la posizione in cui, al centro dello echer~ mo vi apparirà la scritta DELTA ed in basso a sinistra il simbolo di una parentesi quadre chiuse "1', accento alla quale risulterà posizionato il cursore. A Aii'accensione. il computer DELTA (come avviene anohe nelI'APPLE). entrerà direttamente In BASIC. per cui potrete subito iniziare ad utilizzarlo come un normale microprocessore in BASIC. con tutti i comandi standard del BASIC APPLE-SOFT. Utilizzando la nostra tastiera. avrete anche dei tuti funzione preprogrammati. con i quell richie-
_ | 1 | \
| | f.

In questa loto, la tastiera che vi ternlremo gia monhta o compleh della lnlerlsc.` ela visibile In lio. 19. Nel prezzo di questa tastiera e compresa l'lntsrtaecia, le piattino gia oebtsta con due connettori ed I illo aneh'esso completo di connettere.

mare alcune iunzioni specifiche dei BASIC. corno ad esempio RUN (vedi il tasto F2). oppure LOAD (vedi tasto F3) o SAVE (vedi tasto F4).
Come vedrete. inizialmente ll computer utilizzerà il formato standard del video APPLE. cioe e 40 colonne. ma poiche nei nostro computere già presente I'espensione di memoria a 12! Kliohyte ed anche l'intertaccla video. a 80 colonne. potrete subito passare e questo secondo iormato video sompiicemente digitando i'istruzione:
PR 3 e RETURN.

In pratica. questa istruzione "dice" ai computer di eseguire le routine di controllo presenti nella schede di espansione 3. che. nella versione classica dei computer APPLE 2. e quella dedicata ali'e-:pensione video a BO colonne.
Come vi abbiamo detto. tale espansione e gia presente eli'interno del nostro computer. perciò. anche se nel connettore 3 non e presente “lisicamente" alcuna scheda. otterrete ugualmente una pagina video a 80 colonne, più le grafica ad alh rlsoludeno.
Se avete già utilizzato un computer APPLE 2 o APPLE 2 E. saprete gia come utilizzare questo computer DELTA. perche , come gia accennato. tutte le istruzioni sono periettamente identiche. Nei prossimo numero vi proporremo le costruzionedell'interiaccia per lloppy-dlaclt e deli'interiaocla stampante, costruite in modo che. una volta Inserite nei connettori di espansione ed acceso Ii computer. tutto si svolga “automaticamente”. cioe il computer. constatando la presenza dei "drive iloppy" e della "stampante". provvedere a gestirie
senza alcuna supplementare operazione. penanto.

inserito ll dischetto nei drive. ii computer eeegulra Immediatamente tutte le Istruzioni In esso contenute e sul video vedrete riportate anche tutta le istruzioni da eseguire.
Per ora i vostri programmi li potrete solo caricare e prelevare da un normale registratore e, come gia saprete. per leggere un programma da cassetta. dopo aver collegato I'uacita dei vostro registratore alla presa ENTRATA e I'lngreaao microfono alla PRESA USCITA del computer. sara sufficiente digitare:
LOAD e RETURN

per caricare i programmi presenti nel registratore. nei computer. oppure:
.AVE a RETURN

per memorizzare i programmi da voi preparati su una normale casaatta.

CONCLUSIONE

A questo punto sarete curiosi di conoscere il costo del kit del computer Delta. un calcoloche noi avevamo effettuato ancor prima dl acclngerci alla aua progettazione.
La cifra che ne ricavammoci sembro subito poco competitiva a confronto dei prezzi dei computer pubblicizzati nei giornali e nelle riviste. equesto ci meraviglio. poichè ii nostro costo llnale era. ed e sempre. la somma del prezzi dei soli componenti inclusi nei progetto. senza I'aggiunu di supplementi per la progettazione, per l'ammortizzamento, per i master, per i prototipi. ecc.
Eppure le cifre che compaiono nelle pagina pubblicitarie sono veramente allettanti. "computer X, L.399.000". "computer Z. L.599.000". tanto da suscitare in nol molta curiosita. E cosi. perun giorno, ci siamo improvvisati “comuni acquirenti". Dai negoziante a cui ci siamo rivolti ci a subito stato sconsigliato Il modello di prezzo interiore, perche non suscettibile di espansioni di memoria. non in grado di accogliere. eventualmente ne avessimo i'esigenza, un secondo drive-lioppy ed. infine. perche valido solo per chi avessecome unico line quello di divertirsi con dei "semplici video giochi".
Desiderando noil invece. un computer per un futuro uso gestionale, ci e stato consigliato di soagilera ii modello da L.599.000. Siamo quindi passati alla "cassa" e qui, anziche pagare 599.000 lirel abbiamo dovuto versare con l'iVA. 101.000 lire. Giunti in sede. cisiamo accorti che nei computer appena acquistato non erano Inclusi, nè i'estenaionedi memoria. nè I'interiaccia videoa80coionne. ne tanti altri piccoli. ma indispensabiiiaccesaori. per poterlo utiilnara.
Abbiamo cosi dovuto acquistare diverse interfacce. con l'aopiunta dl 200.000-300000 lire. ecc.. e alla line questo computer ci e venuto acostare quasi 3.700.0w lire.
A questo punto. abbiamo pensato di estendere la nostra "Indagine" ai servizio assistenza e. dopo aver deliberatamente bmclato una comunlasima memoria (costo massimo 4.000 lire). cisiamo rivolti ai medesimo negoziante per la riparazione. Ouesti. dopo averlo ritirato. ha Inviato a Milano il nostro computer e dopo 2 mesi quest'uitimo ci e stato restituito con una spesa di 145.000 lire per la riparazione. Per lortuna non abbiamo bruciato. com'ara stata nostra Iniziale intenzione, oltre alla memoria. anche un decodificatore di lndiriai. Conoscendo tutti questi particolari. possiamo ora affermare che Il costo dei DELTA. essendo gia COMPRESO DI lVA. con inclusi un banco di rnemaria da 128 K. un video ad 80 colonne e una gralica ad alta risoluzione. e vantaggioslsslmo. Dobbiamo inline considerare. che nessun intagrato presente in tale computer è saldato direttamente sul circuito stampato. ognuno di essièiniatti dotato del relativo zoccolo. quindi se un domani sl dovesse bruciare una memoria. e possibile sostituirla ln pochi secondi e con una modica spesa. senza rovinare lo stampato.

### cOITO DI REALIZZAZIONE

Scheda base LXJBO visibile in flg. 13. completa di circuito stampato a lori metallizzatl. zoccoli. ln-

### tegratl. connettori. quarzo, condensatori. resisten-

ze, altoparlante. ecc. | | L. 600.0m
Lo stadio di alimentazione LX.781. completo dl un trasformatore toroldalel due alette di raffreddamento. presa rete speciale. tutti gli integrati. SCR, lampada spia. nuclei toroidail. ponti raddrizzatori.
connettori. ecc. | L. 150.000

interfaccia TV ( lanco/narc) LX.782. completa di
scatola metallica | | L. 18.0fl)

interfaccia per Monitor a Colori in RGB. siglata
LX.783, visibile in lig. 16 | L. 15.00)
li solo circuito stampato base LXJBO a lori metal-
iizzati con disegno serigratico | L. 05.000
ll solo circuito stampato LXJM | L. 12.000
Il solo circuito stampato LX.782 | L. 3.000
ll solo circuito stampato LXJBS | L. 3.000
Una tastiera proleasionale dl 86 tasti. completa dl una schedina di interfaccia seriale / parallela Ap-
ple. come vedasi in loto ...... | L. 260.000
NOTA = Nei prezzi lndicatl I'IVA e gia Inclusa
