frubem/NE_Delta_Schematics/LX782_Monochrome_Video/scans/lx782_front.jpg

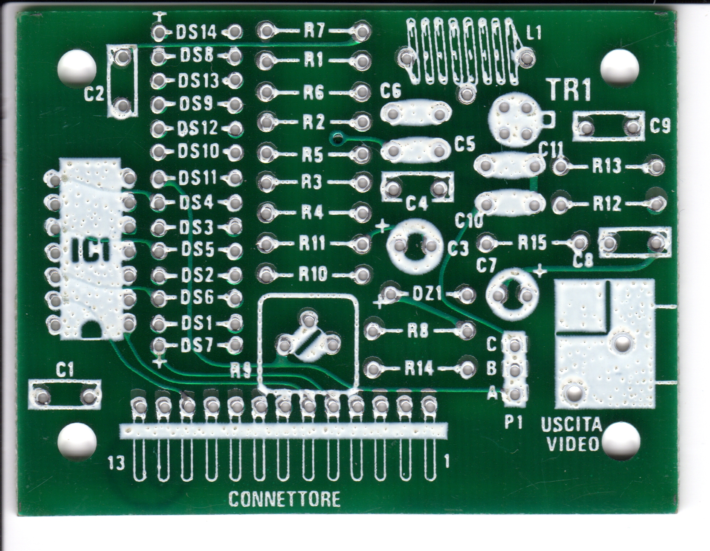
LX782_Monochrome_Video/scans/lx782_front.jpg
