frubem/NE_Delta_Schematics/LX782_Monochrome_Video/scans/overlay.jpg

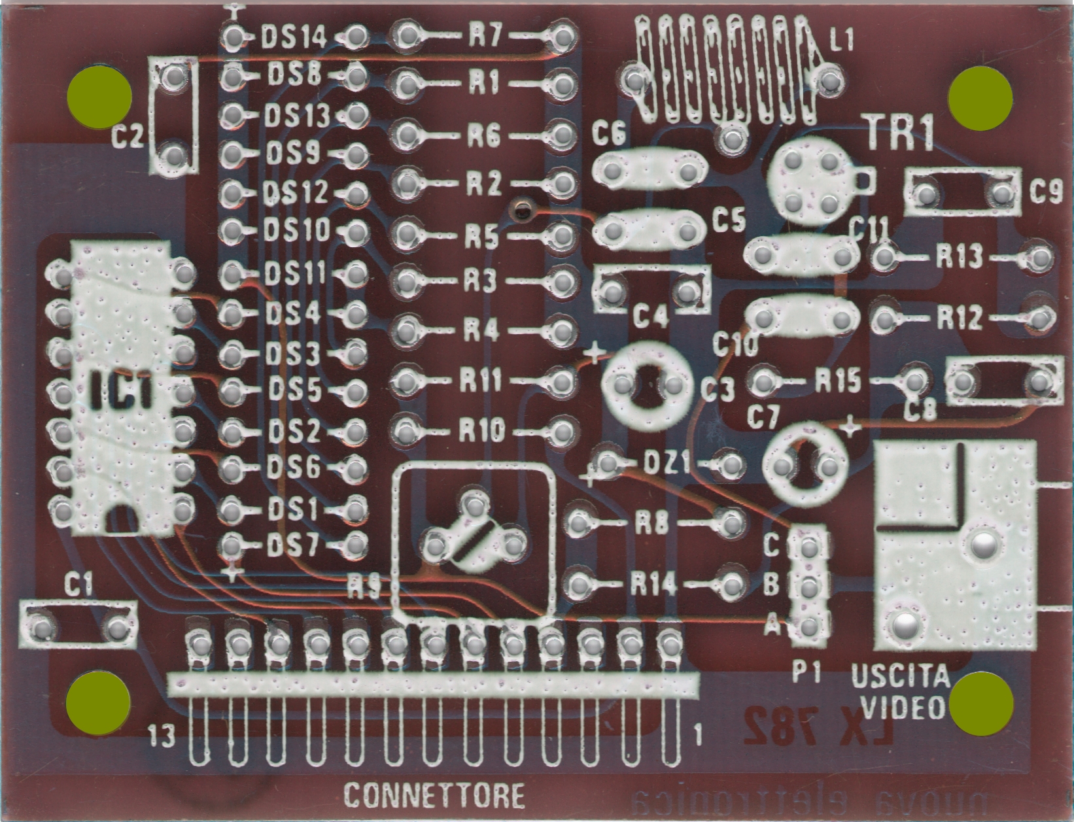
LX782_Monochrome_Video/scans/overlay.jpg
