frubem/NE_Delta_Schematics/LX783_RGB_Video/scans/lx783_front.jpg

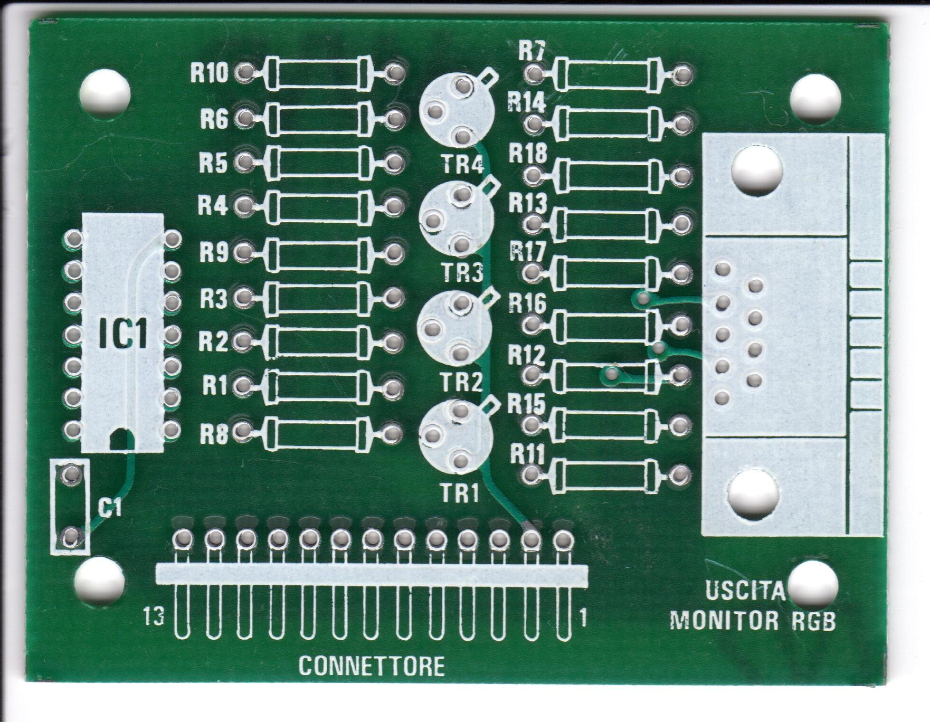
LX783_RGB_Video/scans/lx783_front.jpg
