frubem/NE_Delta_Schematics/LX783_RGB_Video/scans/overlay.jpg

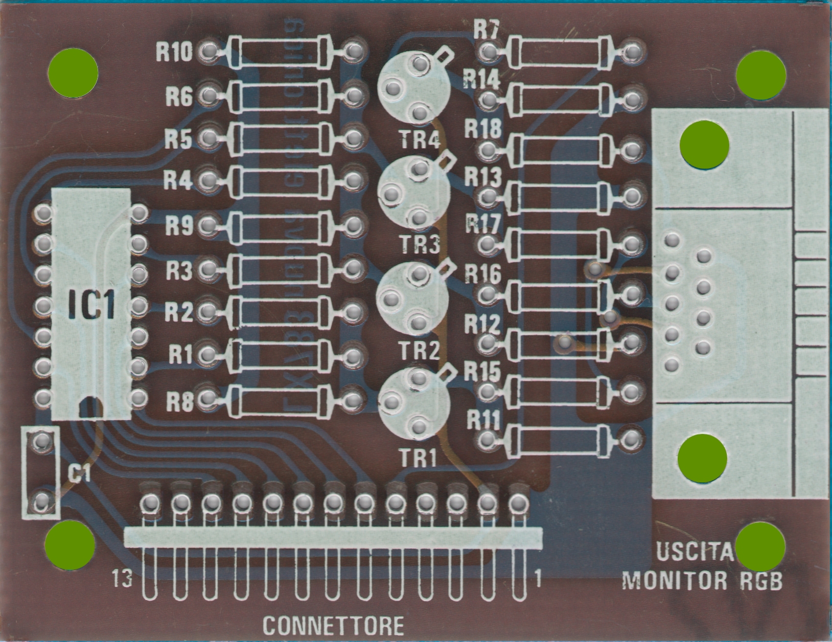
LX783_RGB_Video/scans/overlay.jpg
