frubem/NE_Delta_Schematics/LX783_RGB_Video/bom.md

# LX783 RGB Video board - BOM

| Component | Qty | Type / Value | Notes |
| --- | --- | --- | --- |
| C1 |  1  | 100nF/16V+ MLCC capacitor, 5mm pitch | |
| CONN.1 |  1  | pin header, 13P, 2.54mm pitch, right angle | |
| IC1 |  1  | 74LS04 DIP-14 | Make sure to use an LS here, HCT works but colors will be off unless resistor values are adjusted |
| J1 |  1  | DSUB-9 socket, horizontal | |
| R1, R3, R5 |  3  | 270ohm resistor, 1/4W | |
| R2, R4, R5 |  3  | 390ohm resistor, 1/4W | |
| R7 |  1  | 1Kohm resistor, 1/4W | |
| R8, R9, R10 |  3  | 560ohm resistor, 1/4W | |
| R11, R12, R13, R14 |  4  | 470ohm resistor, 1/4W | |
| R15, R16, R17, R18 |  4  | 68ohm resistor, 1/4W | |
| R19 |  1  | 100ohm resistor, 1/4W | |
| TR1, TR2, TR3, TR4 |  4  | 2N2222A, TO-92 | |
