frubem/NE_Delta_Schematics/LX780_Delta-fixed/component_notes.md

# Notes on components

- Noticed an improvement on DHR graphics stability/cleanliness replacing IC33 with an ALS variant.
- Clock tends to drift and be unstable using a 74LS04 for IC5. 74ALS04 or 7404 give a stable clock.
