frubem/NE_Delta_Schematics/Docs/delta_printer_interface.pdf

Se un terminale "video" e un componente Indispensabile per un computer. perche cl consente di vederetutto quello che digltiamo sulla tastiere. una "stampante" lo eancordi più . in quanto con essaè sufficiente premere un scio tasto per scrivere quanto è memorizzato nel nostro computer. ripetere ali'inlinito lo stesso testo. preparare tabulati. fatture, bolle di consegna. cataloghi e quanto altro
ancora dobbiamo conservare su carta stampata.
Per far funzionare una stampante non e sufficiente collegarlo ad una presa dl rete ed accenderia. ma occorre aggiungervi una "interfaccia". che. inserita in uno dei tanti connettori di espansione presenti sulla scheda base. ci consenta di gestlrla e controllarle. per poter cosi. a seconde della nostre esigenze. stampare in minuscolo o maiuscolo. ln chiaro o in neretto, scrivere caratteri a doppia altezza o larghezza. oppure compressi ed. infine. andare a capo a fine riga.

-lnnumerevoll integrati. invece basterà dare uno sguardo alla flg. 1. per scoprire che per Il nostro progetto. occorrono soltanto cinque integrati. quattro resistenze e sei condensatori.
Con il rettangolo a colore. visibile sul lato sinistro di questo scheme elettrico. abbiamo raffigurato ii connettore a pettine riportato direttamente sul circuito stampato. che andrà innestato in uno qualsiasi dei connettori femmina di espansione presenti sulla scheda base del computer Delta. anche se. per questa funzione sarebbe consigliabile utilizzare il CONNiiÀ
Su tele connettore giungono tutti I segnali di comanda necessari alla stampante. più precisamente. partendo dai basso verso i'aito. i DATI (vedi ingressi lndlcatl A2-A9) per un toteledi B fili. che. al solo scopo di semplificare lo schema elettrico. abbiamo raggruppate In una lascia di colore "azzurro"4

### Chl dispone di un computer senza dubbio avvertira i'eslgenza di

completano con una atampante e per far cio e indispensabile una

### “interfaccia”. Quella che ora vi presentiamo. oltre che con Il nostro computer DELTA, può essere utilizzata anche con qualsiasi com-

puter APPLE e relativi compatibili.

L'interfaccia che vi presentiamo. progettata per Il nostro computer DELTA. oltre a rispondere a tall esigenze. presenta il vantaggio di poter essere utilizzata con i computer APPLE 2 e APPLE 26 e con qualsiasi altro computer compatibile APPLE.
In uscita da questa interfaccia è possibile utiiizzare qualsiasi stampante reperibile in commercio. purchè predisposta per un INGRESSO STAN-DARD CENTRONICS PARALLELQ
Essendo questa nostra interfaccia un modello STANDARD/APPLE. precisiamo che sare in grado di gestire tutte le funzioni di stampa per qualunque tipo di carattere. me non per i caratteri semigrafici e in grafica ad alta risoluzione.

SCHEMA ELETTRICO

Quando si parla di interfaccia stampante ai pensa subito e schemi estremamente complessi con

Questi DATI. come vedasi chiaramente. giungeranno sul piedini 940-1 1-13-14-15-16-17 deli'lntegrato IC4 e. contemporaneamente, sul piedini 3-18›4-13~B-14-7-17 deli'integrato lCã.
L'integrato iC4. in pratica. è una Eprom programmata, contenente "tutte le istruzioni" necessarie alla CPU per gestire una stampante. vale a dire che il computer` interrogando questa Eprom. conoscerà quali istruzioni dovrà inviare alla schede interfaccia. per far funzionare in modo perfetto la stampante ed esso collegata.
L'integrato iCS, un normale TTL tipo 74LSG74. è una memoria temporanea. indispensabile per ricevere dal computer tutto quanto dovrà essere stampato e tenerlo in memoria. per ii solo tempo necessario alla stampante per preievarlo e stamparlo. Non bisogna infetti dimenticare che nel BUS dei DATI. oltre ai "caratteri da stampare". sono pre senti anche numerosissime altre informazioni per gestire i rimanenti integrati presenti nel computer. che. se giungessero alla stampante. non essendo da quest'ultima riconosciute, potrebbero incepparla.
L'integrato ICS seleziona. Ira tutte queste inlormozioni. isoli “caratteri da stampare". in modo che la stampante Ii possa da qui prelevare pertettamente "puliti" e pronti per essere stampati. Proseguendo sempre lungo il connettoredi sinistra. sopra al BUS dei DATI. troviamo il terminale
18. siglato I/O ri. collegato direttamente al piedino 20 della Eprom lCd.
Questo ingresso servirà al computer per selezionare entro alla Eprom. il programma gestione stampante.
Salendo ancora su tale connettore. incontriamoi piedini siglati 28 a12B(11 ingressi). che abbiamo raggruppate in un'unica fascia di color "blu" e che ci serviranno per il BUS INDIRIZZI. che indirizza tutte le celle di memoria di ICd.
Intatti. come vedesi nello schema elettrico. il BUS INDIRIZZI la capo ai piedini 8-7~6-5›4-3~2-1-23-22-19 della Eprom IC4.
Sempre continuando a salire lungo tale connettore. incontriamo due ingressi ponticellatl (vedi terminali 243-24A e 238-23A). poi ll terminale 10A siglato DEV SEL (Device Select). utilizzato dal computer per Inviare alla Interfaccia I segnali di abilitazione.
Pertanto. lCt/A. congiuntamente a ICI/BlC1/D-lCt/C. ci permetterà di abilitare il trasferimento dei dati dall'lntegrato ICS alla stampante. dl generare. tramite ICZ. l'irnpulso di STROBE con Ia giusta temporizzazione ed. inline, di leggere i segnali di controllo provenienti dalla stampante verso il computer. tramite gli integrati ICS/A e ICß/B. Intatti. la stampante deve “sapere” quando può prelevare i dati da ICS e. ancora. deve essere in grado di abilitare il computerad inviare a ICS altri “caratteri”. solo quando ha terminato di stampare quelli precedentemente immagazzinati. Infatti. non dobbiamodimenticare che. in Iase di stampa. la carla può venire a mancare. si può rompere. o. per errore. si può spegnere la stampante stessa. ecct. pertanto. senza questi "controlli" di protezione il computer oontinuerebbe ad inviare a ICS tutto quanto gli abbiamo comandato di "stampare” e non risultando la stampante in funzione. tutti questi dati andrebbero irrimediabilmente persi.
Cosl. se la stampante dovesse lermarsí per un

n
ln
l
›
Ivt
t

I 55 P⁻.-~†,--

E-LENCO COMPONENTI LXJBS
R1 : 10.000 ohm 1/4 "Il" | 02 : "n.000 DF polluti"
R2 : 10.000 ohm 1/4 watt | ü : 220 pF I dlaco
H3 : 1.000 ohm1/4 watt | CA : 220 pF I dllco
R4 : 1.000 ohm 1/4 WIN | C5 : 100.000 DF 00|t
| Cß : 100.000 DF 000"t
CI : 100.000 pF hdmi". | IC1 : SNJÃLSM

IC2 : SN.14LS123
ICJ : SNJOLS125
ICI : EP.785
IOS : SNJOLSSN
P1 : pontlcnllo
P2 : pontlutlo

Flg. 1 schema elettrico doll. lntemoctl Itampanto per Il computer Delta presentato sul numero 104-105 della nvlntn. Con la tucln colorata vlllbllo lull- pam llnlstra dello lchm, lbhllmo rufllgurnto Il connettori l pltflnt da tnnutan nel CONNJ dal computer. ment'. con la Iucll color-ta peut. nulli dum, Il connettore dl uscita per la numplnte. Nella tig. 2 quutl du. conmttofl ma bon dlstlngulblll.

# 'JL Jura'. _ MINETTOK STAMPANTE

"fine carta" o per un qualsiasi altro motivo, ìl computer si bloccnerebbe e tomerebbe a riprendere la stampa laddove I'aveva precedentemente interrot~ te e. in tal modo. non perderemmo alcun carattere. Per terminare` sul nostro connettore di sinistra troviamo, in alto. gli ultimi due terminali di alimentazione, e qui è intuibile che il terminale 25^ è quello di "massa" e il 258, quello dei "5 volt positivl".
A questo punto, possiamo passare al connettore posto a destra. che ci servirà per collegercl. tramite piattlna, alla stampante.
Nello schema elettrico dl questa interfaccia non ahbiamo ancora precisato la completa funzione del doppio temporizzatore, siglato IC2.
La prima sezione, che fa capo ai piedini 15-14 (vedi R1 e C3). ci servirà per ottenere un ritardo di circa 1 microsecondo, per dare la possibilita all'integrato ICS di prelevare i dati di stampa dal BUS e trasierirli al connettore di uscita della stampante. La seconda sezione che fa capo ai piedini 7-6 (vedi R2 e C4). ci servirà per ottenere l'impulso di STROBE, necessario ad avvisare la stampanteche sul terminali di uscita del connettore sono gia disponibili i successivi caratteri da stampare.
Questo secondo temporizzatore risultando collegato in serie el primo (vedi piedini 4 e 10)` genererà un impulso sempre di 1 microsecondo. dopo aver ricevuto dal primo temporizzatore l'impulso di start.
Perconcludereladescrizione delloschema elettrico, vi indichiamo a cosa serve il ponticello P1 collegato sul piedino 15 di lcd e il ponticello P2. collegato in aerle alla resistenza RdV

P1 Per ora questo ponticello andrà lasciato aperto, cioè si dovrà Inserire la spina femmina tra il terminale centrale e A, oppure non inserirla affatto. Tale ponticello è stato previsto per adattare stampanti speciall, che potrebbero in futuro presentarsi sul mercato.
P2 Questo ponticello serve perdlsabilitare la tunzione di controllo "fine carta". Infatti` molte stempanti non dispongono di tale controllo4 per cui Il computer non ricevendo dalla stampante questa informazione, si bloccherehbe subito. ln questo caso, dovremo cortoclrcultare a mau- la resistenza R4 e cio si otterrà inserendo la spina femmina tra il terminale centrale e il C.
Se la vostra stampante dispone di tale controllo, dovrete lasciare aperto questo ponticello, cioe inserire la spina femmina tra il terminale centrale e I'A. oppure non inserirla affetto.
Per stabilire se la vostra stampante dispona del controllo di fino carta. sara sufficiente leggere nel libretto in dotazione, se sul connettore di uscita e presente un terminale siglato PE. che. in pratica. significa PAPER END, cioe “fine carta".
Nel dubbio se tale controllo esista o meno. potre-

### te coliegare la vostra stampante e se non Inserendo

la spine femmina. essa non entra in funzione, non dovrete far altro che innestare la spina per corto-

### circuitare, come sopraocennato. il terminale cen-

trale di P2 con il terminale C.
Owiamente. li connettore di uscita visibile sulla destra servirà esclusivamente per innestare la

### stampanteA

Pensiamo sia Interessante accennare al perche abbiamo collegato a massa tutti i terminali che

Flg. 2 Folc della Inlerfaecla come al prenatara a costruzione ultimata. La eprom con la “finutro" ancora leoparh
vlalblle al centro, la rico-

### verato programmata o

“coperta” da una eti-

### chetta con 'apra Itam-

pntø enna.

109

Flg. J Schema pratico
di montaggio deli'lntarfaccia descritta nali'artlcolo. i due ponticelli siglati P1 a P2 (vedi ln alto. sopra a ICS) andranno
predisposti come chianmanto spiegato nel testo.
:iliililllliiliiiiliiiiii.

vanno dal n. 15 al n. 26. quando UNO SOLO sarebbe gia stato sufficiente percoilegare la massa fra la stampante e l'interfaccia.
Questa disposizione dei terminali risponde al proposito di separare ogni filo della piattina in cui scorrono i segnali. con un filo di "massa". In modo da evitare interferenze
Infatti. questi fili collegati a massa. assicurano una completa schermatura ai rimanenti fill del segnaii.

REALIZZAZIONE PRATICA
Ii circuito di interfaccia oltre ad essere un doppia faccia con tori metallizzatl e completo di connettore a pettine per poterlo innestare nella femmina presente sul circuito base del computer Delta. risulta protetto con una speciale vemice.che lascia aperti i soli bollini da saldare.
Da quando ahblamo utilizzato questa vernice sul circuiti a fori metallizzati. ci siamo accorti di aver totalmente eliminato tutte quelle riparazioni causate da un eccesso di stagno. che metteva in cortocircuito due piste adiacenti.
Una volta in possesso di questo stampato. siglato LXJBS. inizierete il montaggio inserendo dapprima ll connettore di uscita per la stampante. Dopo averne saldato tutti i terminali. potrete lnserire le poche resistenze e i relativi condensatori. poi i due connettori maschi P1 e P2. infine completerete Il montaggio inserendo tutti gli loccoii per gli integrati. Ultimate le saldature, inserirete negli zoccoli tutti gli integrati. rivolgendo la tacca di riferimento riportata su un solo lato del corpo come chiaramente visibile in fig. 3.
Ovviamente. nel disegno. letacche sono raffigurate tutte di uguale grandezza. inpratica, invece. sugli integrati risulteranno leggermente diverse. ad esempio nella Eprom 104 troverete solo un piccolissimo "taglio".
Neil'inserire gli integrati entro i relativi zoccoli. verificate che tutti i piedini s'innestino perfettamente nei loro vani; diciamo cio. perche in molte riparazioni scopriamo qualche piedino ripiegato verso l'intemo ed e owlo che. in tali condizioni. il circuito non puo funzionare.

COME PROVARLA

Inserite questa scheda nel connettore 1 del computer DELTA. rivolgendo il connettore della stampante verso l'esterno4
Dobbiamo precisare chela scelta dei CONNET-TORE 1. in cui dovrete inserire questa interfaccia. non e casuale. bensì dovuta al fattu che quasi tutti i programmi delI'Apple reperibili in commercio. indirizzano la stampante su questo specifico connettore. quindi. se inserirete tale interfaccia In un qualsiasi altro connettore la stampante non funzionerà ed il computer sl “bloccherà”. perchè non riceverà risposta dl rltomo al comando di abilitazioneÀ

Solo nei casi In cui puo risultare necessario Inaerire nel computer DUE stampanti. la seconda interfaccia potra essere innestata in un altro connettore. ad esempio CONN<3 o GONNA. selezionando pol quella oelledue stampanti che si desidera abilitare, scrivendo nella istruzione di stampe (vedi più avanti) quanto segue:

PIHH : quando vornmo abilitare la 'tamponi' polta nel CONNJ
PMI: : quando vornmo abilitare la atampanta poeta nel CONNÂI
PM"- u avremo lnaartto l'lnteriaccia nel

### CONN.,4 anziche nei CONNJ

Dopo aver inserito I interfaccia nel CONNJ e innestato nei connettore di uscita la plattina che ia capo alla stampante. rammentando owiamenta di accendere quesl'ultima. potrete fornire tensione al vostro computer.
Appena ud rete il "beep" iniziale potrete digitare: PR#1 e il tasto RETURN
cosi iacendo. l'interiaccia stampante risulterà in linea ed infatti vedrete la carta avanzare di 1 riga. Da questo momento. tutto quanto digitarete sulla tastiera e che. ovviamente. apparirà sul video, verra stampato non appena pigerete il tasto RE-TURN.
Poichè nei caratteri tipogralici manca il segno "grafico" presente nella tastiera sul tasto del numero 3 (segno a forma di cancelletto). carattere
che al correttore di bozze può facilmente sfuggire, per non mettervi in difficolta, preciaiamo che la riga da digitare sara la seguente:
PR cancellano 1

Bisogna anche precisare che la grafica riportata sul video non verra effettuata in stampa. mentre sarà possibile, in tese di prova. stampare trasi anche composte da più parole.
Provate ora a scrivere una irase qualsiasi, ad esempio il vostro norne completo di Indirizzo, esempio:
PROI
ZANETTI FRANCO VIA GARIBALDI N.2 VICENZA

poi piglate RETURN ed immediatamente la stam-

### pante trascrivere il vostro esatto indirizzo. comple-

tandolo a fine riga con la scritta:
SINTAX ERROR

Non preoccupatevi di questa scritta e non cercatequalche "errore" di scrittura. perche il computer inserisce questo messaggio per il tatto che in memoria non esiste alcuna istruzione siglata con il
vostro nomel che perciò viene lntarpretato come
un errore.

### SIF/“8374 EE m

Flo. 4 Connaulonl di tutti gli integrati utilizzati In tale progetto visti da sopra. VI ricordiamo che I'integrato EPJIS e una Eprom 2532 program-
mata per quem .poema random.

111

Infatti. se scriverete questo semplice program-
ma:
10 PR #1
20 PRINT CHR$(9)+”N";
30 FOR A : 1 TO 10
40 PRINT "PROVA DI sTAIPA'; 50 NEXT
60 PRINT CHR$(9)+"I";
70 PFHIO

digitando RUN e RETURN la stampante scrivere i! ` dl seguito per 10 volte le scritta PROVA DI STAM-
PA.
Provate a modificare nella riga 30 la scritta 1 T0
10 con 1 T0 15 e la scritta PROVA DI STAMPA verrà eseguita per 15 volte consecutive.
Provate ancora a togliere nella riga 40 Il punto e virgola, cioè a scrivere:
40 PRINT "PROVA DI STAMPA”

e vedrete che tale lrase, anzichè essere ripetute 10 volte dl seguito, verra stampata su DIECI RIGHE. A questo punto avrete compreso che è possibile

Fig. 5 Come spiegato nell'artimzilo` ta scheda Intertlccla ltampante andrà Innntata nel CONNJ. due nel connettore porto wperlor-

IIIQIII! E Chiaramente indlcãlo dilll IIECCIB.

sostituire la scritta “PROVA DI STAMPA" con frasi
diverse.
Per stampare questo semplice listato di pro~ gramma. sarà sutticiente digitare:
PROH pol plgiere i| tasto RETURN e scrivere: LIST e nuovamente RETURN

una volta terminate la stampa del listato. dovrete necessariamente digitare:
PIHHI

Ouest'ultlma istruzione serve per dlutttvnre la stampante ed avere cosi ii computer libero. In assenza di questa istruzione` la stampante continuera a scrivere tutto quanto apparirà sul video. Verificate il pertetto funzionamento di tale interfaccia, potrete caricare qualsiasi programma su lloppy o nastro e. come constatarete, su di essi è sempre indicato Il tasto da digitare per ottenere la stampa.
Cosi, in un programma la stampa ei otterrà piìiendo:
Il MELA APERTA od 8

112

## '1'MIU'H'""'l'l'n'l'l'l'l '

Iwww

\\t\\n\\\n`\l\lll~.

num lc i i «LW i: ........,,,."unum"

in altri programmi. digitando ampliamento: P oppure S o LPRINT
Queste informazioni le ricaverate sempre dal programma utilizzato. nell'ambito del MENO d FUNZIONI. che si visualizzerà sul video. quindi sarà suiiicienta Ieggerleed eseguirlo come in esso riportato.
Se non utilizzate nessun lloppy o nastro. ma operate direttamente con ii BASIC già residente neII'intarno deI DELTA. allora risulterà necessario inserire nell'interno del programma da voi prepareto. tutte le istruzioni di gestione stampante. Riportiamo qui un esempio di un programma molto semplice, per preparare una schedina dal TOTOCALCIO con Ia relativa stampa:
5 mn asus)
1o una: -1s:tea_o
20 nam-r "entries un mero esa xutzmas" :o a-mntn
ao iF Pesa i-1e:a4›(1ze som :o
so non:
mo Foa T- o To 12
1o: a-annm
11a tr cat-.ss 'mea mwi-"r-isoro 1m 120 x: n›-.sc 'men auT›---z~1isoro no 1:0 astri-"x"
mo Nex'r 'r
zoo rien
z1ú enim cnauenum
Foa x-o ru 12
' eam'r aux)
NEXT X
' ` nam analisiwv
' ` nano
mein' "vuol uit-arma ecnemun ts/m "ma ti: news" eo'ro 10° namr "suona Foaruuae»
:oo :un
Dalla riga 5 alla riga 40 sono presenti le istruzioni per iar scorrere in continuità dei numeri casuali dello 0 allo 0.99. in modo che pigiando un qualsiasi tasto Sl OTTENGA UN NUMERO sempre diverso.
Senza questa istruzione il primo risultato della schedina sarebbe sempre identico.
La riga 90 con la scritta HOME serve per cancellare sul video tutte ie scritte effettuate in precedenza
La riga 100 cl serve periniziare il ciclo di operazioni per calcolare le 13 colonne della schedina. Con la riga 105 preleviamo nella variabile A il numero casuale, che. come abbiamo detto. va da 0 a 0.99.
Dalle riga 1 10al|a riga 130 sono presenti Ie istruzioni che vi permetteranno di stampare un 1 se nella variabile A e presente un numero Interiore a
0.38. oppure un 2 se nella variabile e presente un numero maggiore di 0.66 ed una Xin qualsiasi altro
caso,
Nella riga 200 e presente I'istruzione per abilitare la stampante. inserita nel GONNA.
Nella riga 210 la istruzione per la stampa. disabilltando ii video.

Nelle righe 220 e 230ieistruzionlperesegulm13 colonne In stampa.
Nella rlga 250 la Istruzione per rlabllitare il video. Nella riga 260 la Istruzione per disabilitare la stampante.
Le righe successive per ripartire con una successiva schedina se digitate S e RETURN. oppure, per terminare. digitando S e RETURN. nei qual caso sul video vi apparirà la scritta BUONA FOR-TUNA.
Anche se per un esperto sottwerista quanto ora diremo potrà sembrare owio ed elementare. non bisogna dimenticare che vi sono molti giovani ancora inesperti. che potrebbero trovarsi in difficolta per la mancanza di una nota esplicativa.
Per questo motivo riteniamo utile precisare quanto segue:

FROM Questa istruzione serve per attivare la stampante. pertanto. tutto ciò che apparire sul video verrà stampato. Come già accennato in preceden~ za. il numero 1 serve per indicare al computer che I'Intertaccia stampante è stata innestate nel CONNJ, Se invece innestassimo I'intedaccia nel CONN.5. owiamente, dovremmo scrivere PR #5. PMHI Questa istruzione serve a disabilitare la

### stampante. In qualunque connettore essa risulti

lnnestala.
PftT CHR$(9)+"N"; Questa istruzione attiva oaciuaivamonta la stampante, pertanto, quello che stamperete non verra visualizzato sul video (vedi programma del totocalcio).
PRINT CNR$(9)+"I”; Questa istruzione servea reinserire il vldeo. quindi tutto quello che verra stampato sarà contemporaneamente visualizzato sul monitor.
PRINT CHR$(9)+”K"; Questa Istruzione elimina l'avanzamento automatico delle righe di stampa. Pensando di non aver tralasciato nulla d'importante, vi lasciamo qui. augurandovi buon lavoro e. logicamente. buona stampa.

COSTO DI REALIZZAZIONE

Tutti i componenti necessari perla realizzazione di questa Interiaccia LXJBS. cioè circuito stampato, Integrati. eprom programmata. tutti gli zoccoli e
connettore di uscita | L. 40.000

Una piattina lunga rn. 1.20. completa di connettori
già pinzali | L. 21 .000 .7.000

Nei prezzi sopraindicati non sono incluse le spese postali di spedizione a domicllIo.

Il solo circuito stampato LX.785

113
