frubem/NE_Delta_Schematics/LX780_Delta-fixed/fixes.md

# LX780: Required fixes

## Rev. 0

- DE9 connector has mounting holes slightly off-center, connector can be installed without issues anyway
- C7 is actually 10nF, even if it lacks the silkscreen label
- Silkscreen for R25 and R24 are swapped. R25 should be 47K, R24 is actually 12K
