frubem/NE_Delta_Schematics/LX782_Monochrome_Video/fixes.md

# LX782: Required fixes

## Rev. 0

- R8 must always be installed, not only for the RF section
