frubem/NE_Delta_Schematics/hram_regs_patch/hram_regs_patch.pdf

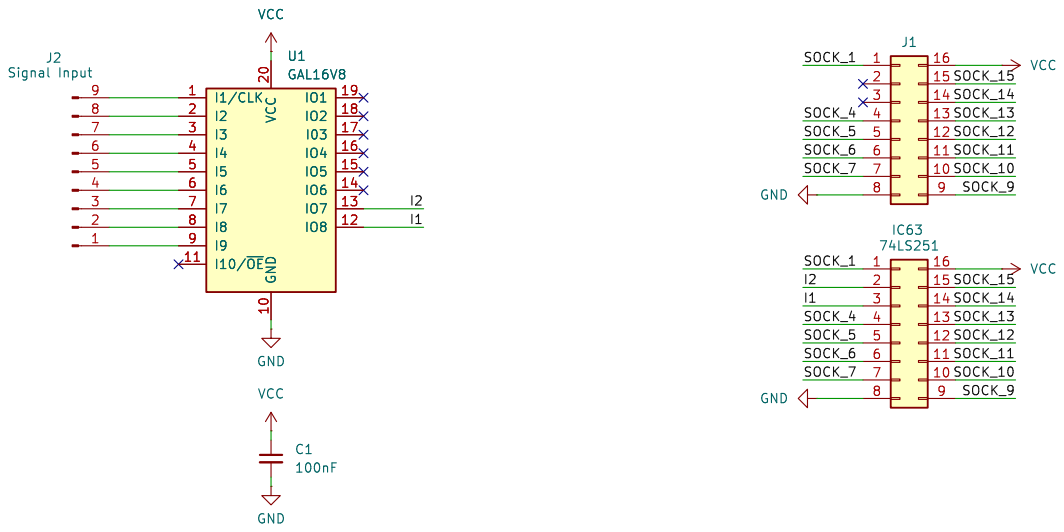
[picture p11: page 1]

Id: 1/1 Title: File: hram_regs_patch.kicad_sch Sheet: / C1
