frubem/NE_Delta_Schematics/LX780_Delta-fixed/NE_Delta.kicad_pcb

## KiCad design LX780_Delta-fixed/NE_Delta.kicad_pcb (2026-10-20)

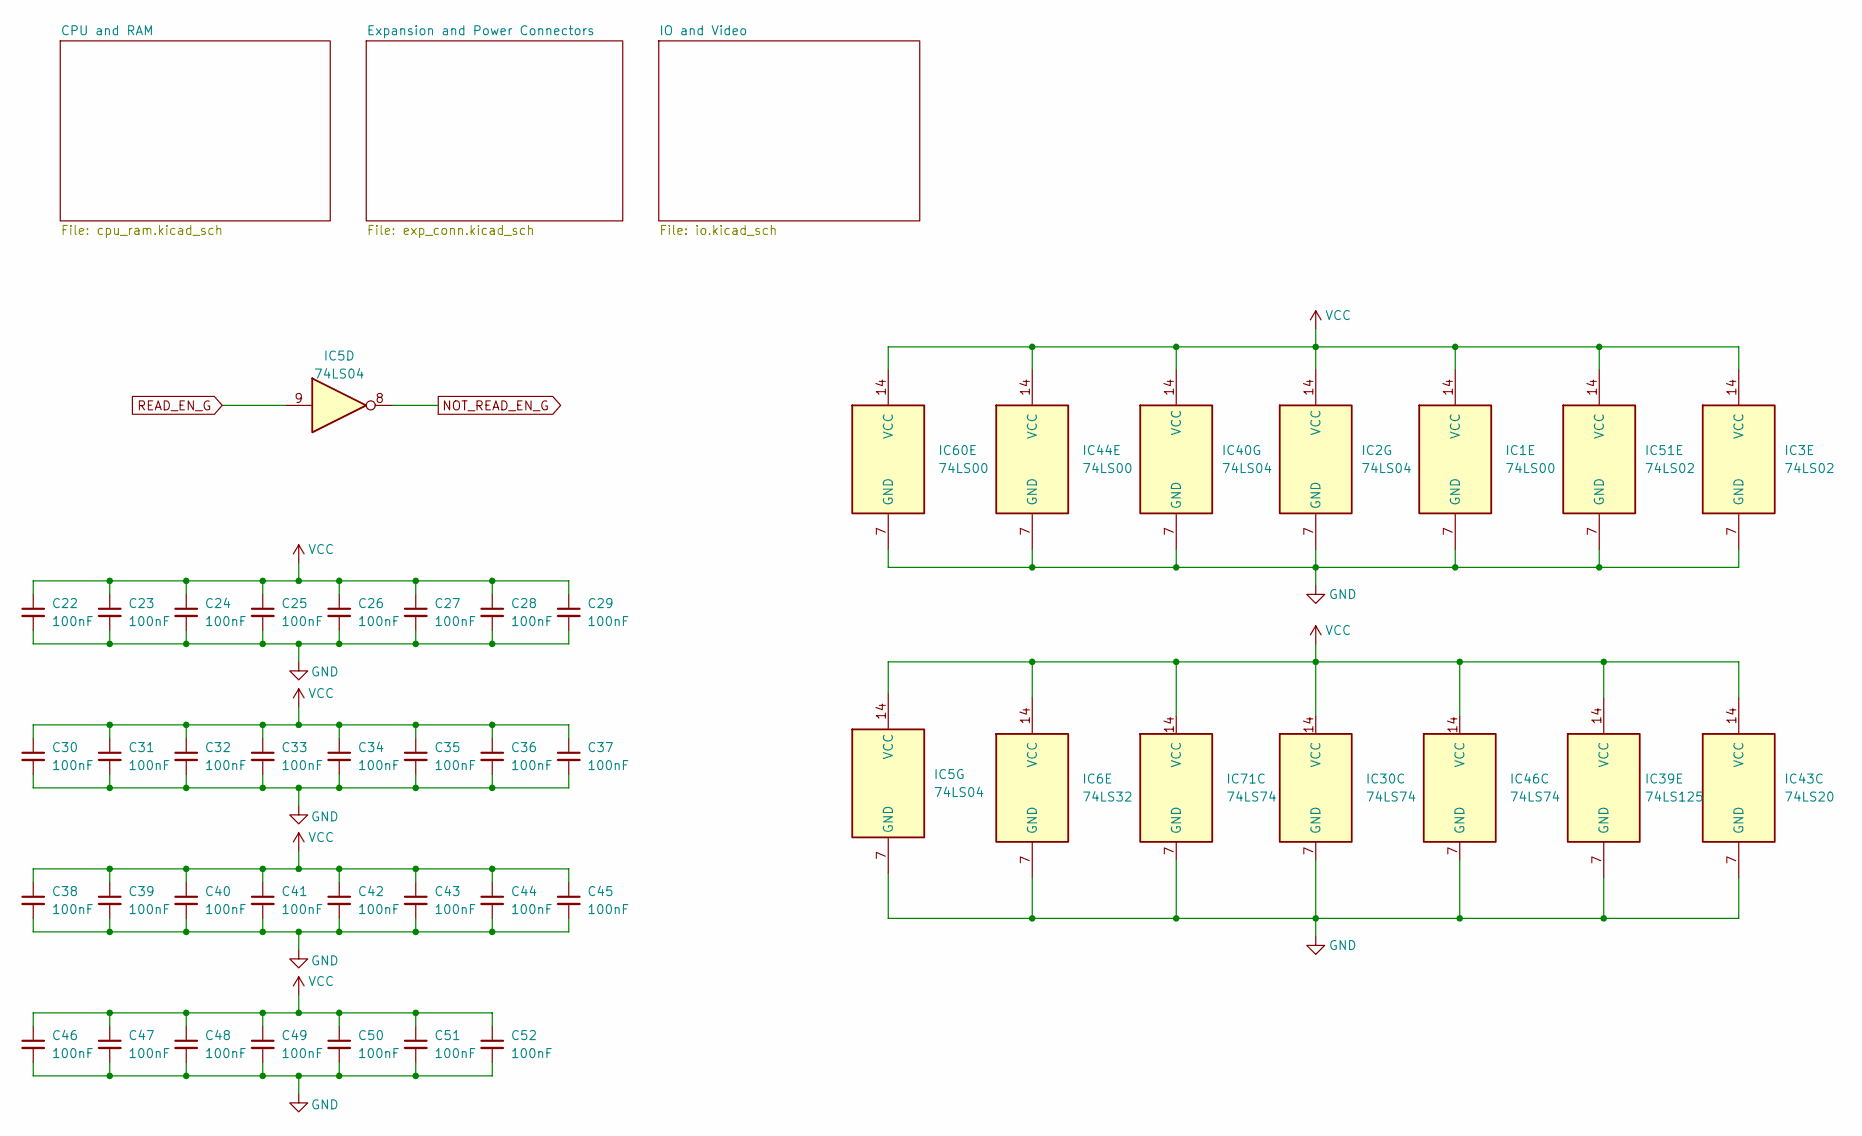
[picture p12: schematic NE_Delta.kicad_sch, N.E. DELTA]

Parts:
C22, C23, C24, C25, C26, C27, C28, C29, C30, C31, C32, C33, C34, C35, C36, C37, C38, C39, C40, C41, C42, C43, C44, C45, C46, C47, C48, C49, C50, C51, C52: 100nF; C_Disc_D6.0mm_W2.5mm_P5.00mm
IC1, IC44, IC60: 74LS00; DIP-14_W7.62mm
IC2, IC5, IC40: 74LS04; DIP-14_W7.62mm
IC3, IC51: 74LS02; DIP-14_W7.62mm
IC6: 74LS32; DIP-14_W7.62mm
IC30, IC46, IC71: 74LS74; DIP-14_W7.62mm
IC39: 74LS125; DIP-14_W7.62mm
IC43: 74LS20; DIP-14_W7.62mm

Connections:
+5V: C22.1, C23.1, C24.1, C25.1, C26.1, C27.1, C28.1, C29.1, C30.1, C31.1, C32.1, C33.1, C34.1, C35.1, C36.1, C37.1, C38.1, C39.1, C40.1, C41.1, C42.1, C43.1, C44.1, C45.1, C46.1, C47.1, C48.1, C49.1, C50.1, C51.1, C52.1, IC1.14 (VCC), IC2.14 (VCC), IC3.14 (VCC), IC5.14 (VCC), IC6.14 (VCC), IC30.14 (VCC), IC39.14 (VCC), IC40.14 (VCC), IC43.14 (VCC), IC44.14 (VCC), IC46.14 (VCC), IC51.14 (VCC), IC60.14 (VCC), IC71.14 (VCC); also elsewhere on the board
GND: C22.2, C23.2, C24.2, C25.2, C26.2, C27.2, C28.2, C29.2, C30.2, C31.2, C32.2, C33.2, C34.2, C35.2, C36.2, C37.2, C38.2, C39.2, C40.2, C41.2, C42.2, C43.2, C44.2, C45.2, C46.2, C47.2, C48.2, C49.2, C50.2, C51.2, C52.2, IC1.7 (GND), IC2.7 (GND), IC3.7 (GND), IC5.7 (GND), IC6.7 (GND), IC30.7 (GND), IC39.7 (GND), IC40.7 (GND), IC43.7 (GND), IC44.7 (GND), IC46.7 (GND), IC51.7 (GND), IC60.7 (GND), IC71.7 (GND); also elsewhere on the board
unnamed 261: IC5.8; also elsewhere on the board

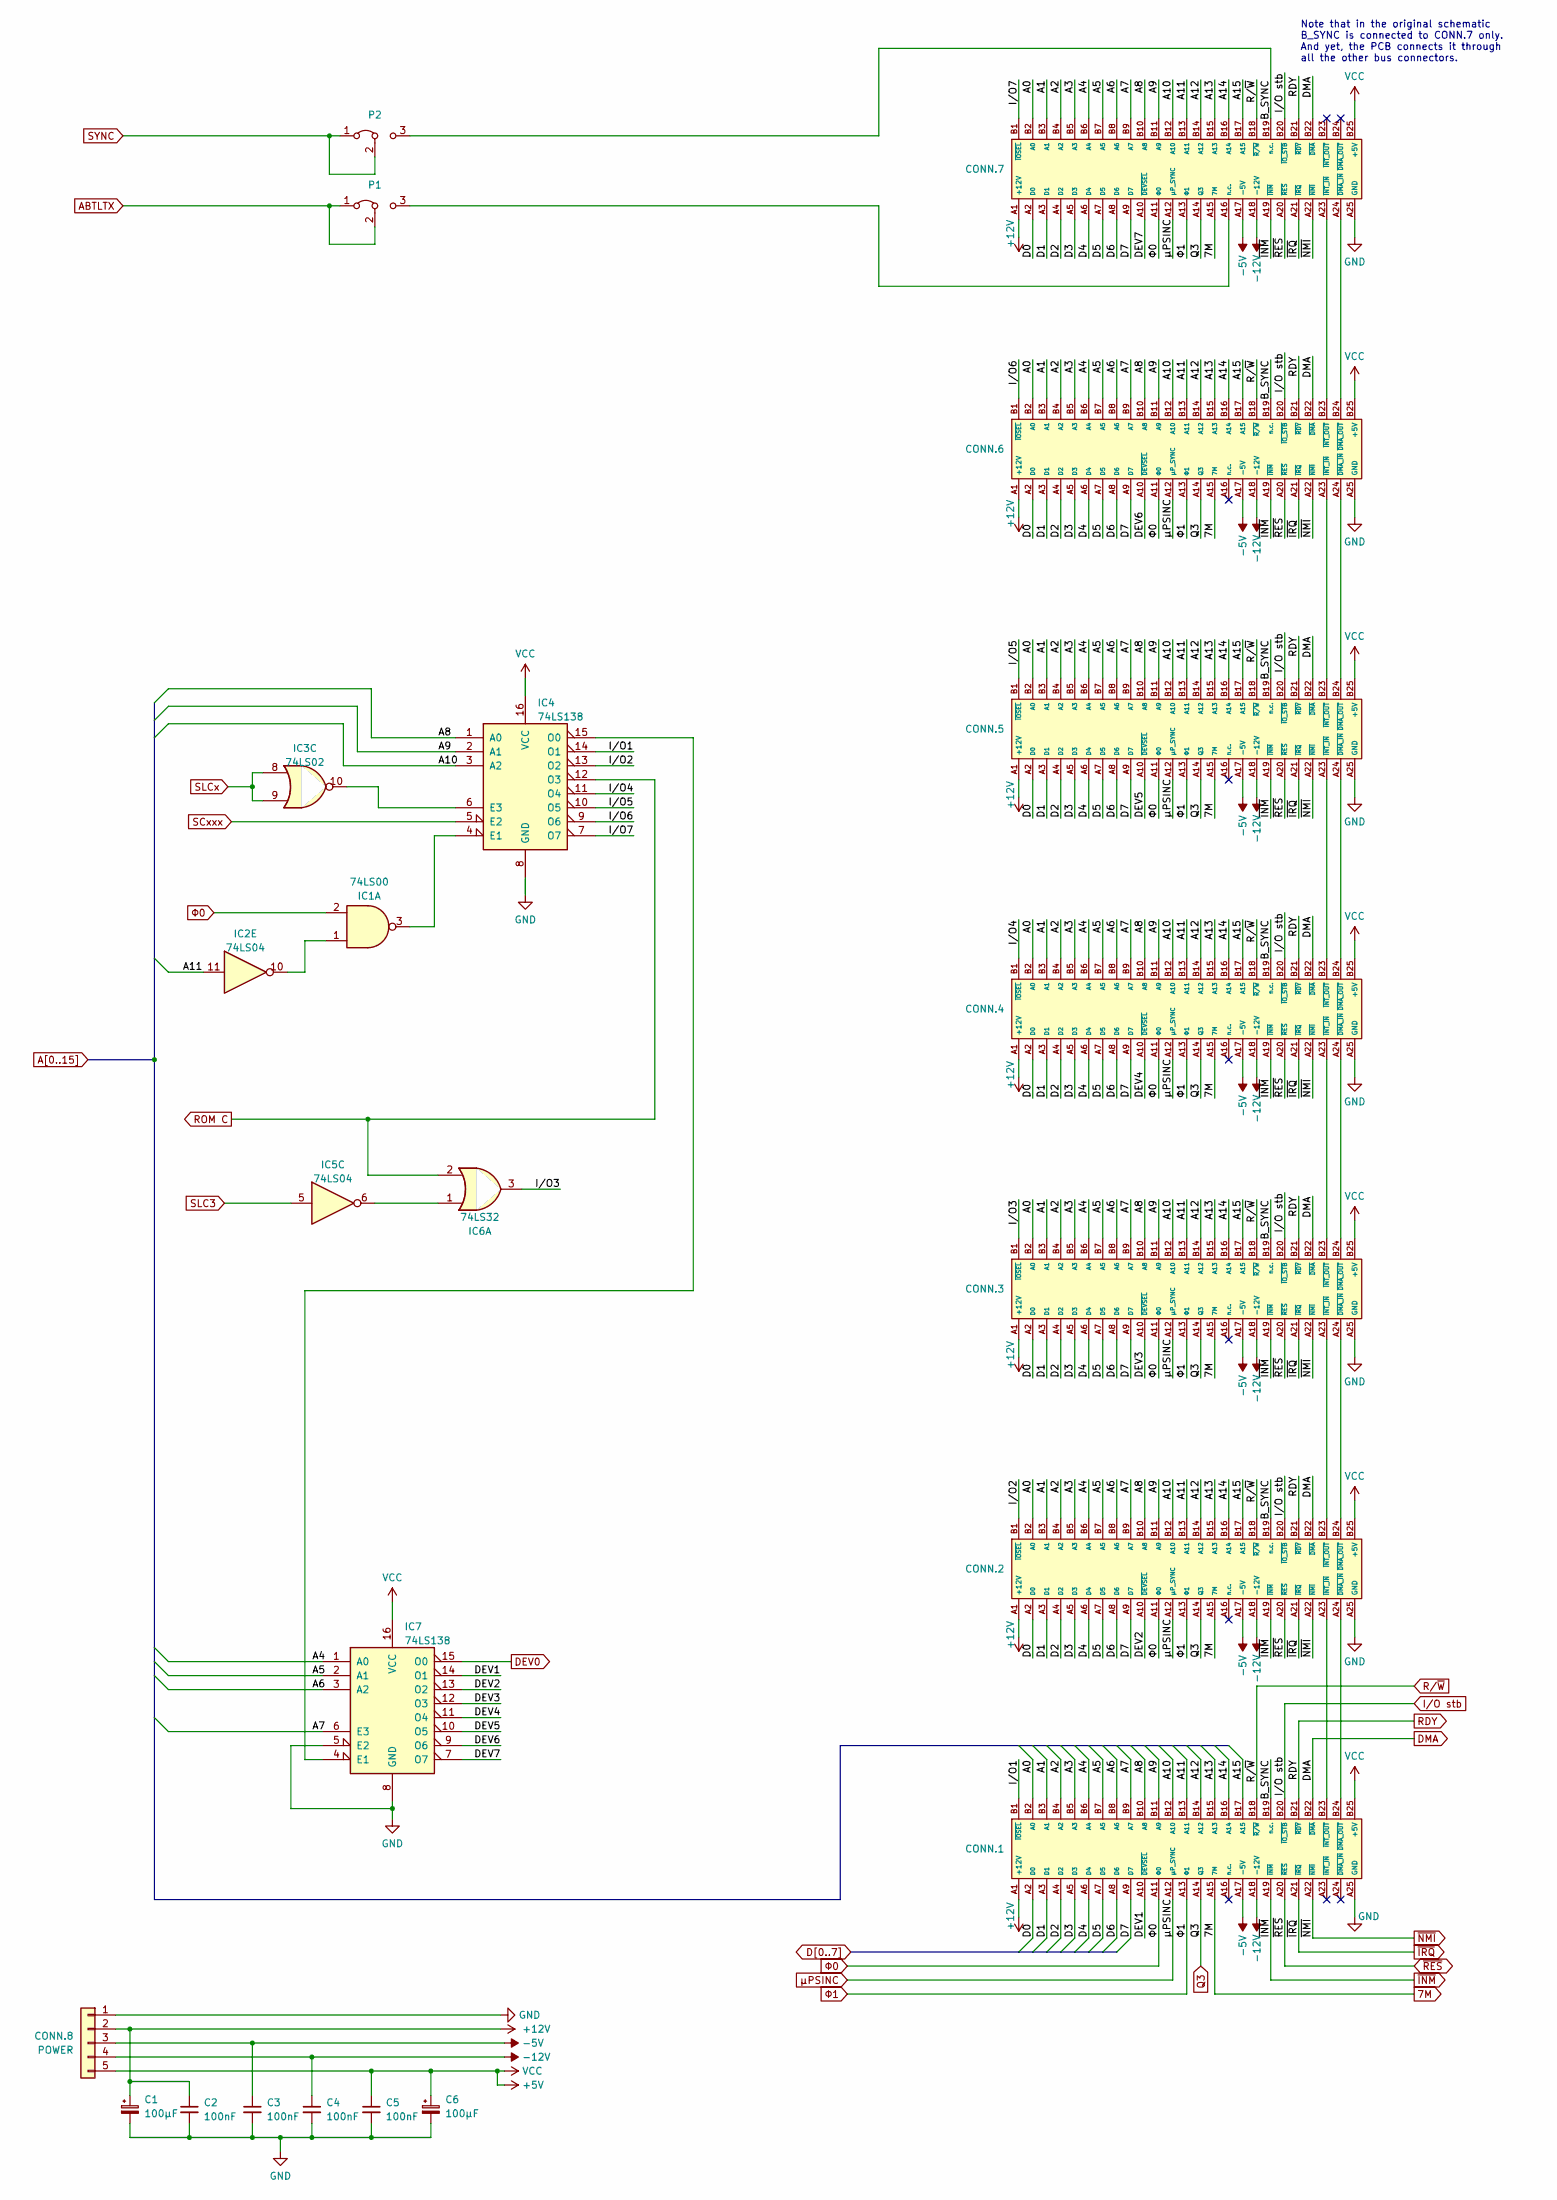
[picture p13: schematic exp_conn.kicad_sch]

Parts:
C1, C6: 100μF; CP_Radial_D8.0mm_P5.00mm
C2, C3, C4, C5: 100nF; C_Disc_D6.0mm_W2.5mm_P5.00mm
CONN.1, CONN.2, CONN.3, CONN.4, CONN.5, CONN.6: NE_BUS
CONN.7: NE_BUS_halfsilk
CONN.8: POWER; NE_POWER
IC1: 74LS00; DIP-14_W7.62mm
IC2, IC5: 74LS04; DIP-14_W7.62mm
IC3: 74LS02; DIP-14_W7.62mm
IC4, IC7: 74LS138; DIP-16_W7.62mm
IC6: 74LS32; DIP-14_W7.62mm
P1, P2: Jumper_3_Bridged12; PinHeader_1x03_P2.54mm_Vertical

Connections:
7M: CONN.1.A15 (7M), CONN.2.A15 (7M), CONN.3.A15 (7M), CONN.4.A15 (7M), CONN.5.A15 (7M), CONN.6.A15 (7M), CONN.7.A15 (7M); also elsewhere on the board
+5V: C5.1, C6.1, CONN.1.B25 (+5V), CONN.2.B25 (+5V), CONN.3.B25 (+5V), CONN.4.B25 (+5V), CONN.5.B25 (+5V), CONN.6.B25 (+5V), CONN.7.B25 (+5V), CONN.8.5, IC4.16 (VCC), IC7.16 (VCC); also elsewhere on the board
+12V: C1.1, C2.1, CONN.1.A1 (+12V), CONN.2.A1 (+12V), CONN.3.A1 (+12V), CONN.4.A1 (+12V), CONN.5.A1 (+12V), CONN.6.A1 (+12V), CONN.7.A1 (+12V), CONN.8.2; also elsewhere on the board
-5V: C3.1, CONN.1.A17 (-5V), CONN.2.A17 (-5V), CONN.3.A17 (-5V), CONN.4.A17 (-5V), CONN.5.A17 (-5V), CONN.6.A17 (-5V), CONN.7.A17 (-5V), CONN.8.3; also elsewhere on the board
-12V: C4.1, CONN.1.A18 (-12V), CONN.2.A18 (-12V), CONN.3.A18 (-12V), CONN.4.A18 (-12V), CONN.5.A18 (-12V), CONN.6.A18 (-12V), CONN.7.A18 (-12V), CONN.8.4; also elsewhere on the board
/Expansion and Power Connectors/B_SYNC: CONN.1.B19 (n.c.), CONN.2.B19 (n.c.), CONN.3.B19 (n.c.), CONN.4.B19 (n.c.), CONN.5.B19 (n.c.), CONN.6.B19 (n.c.), CONN.7.B19 (n.c.), P2.3 (B)
/Expansion and Power Connectors/DEV1: CONN.1.A10 (~DEVSEL), IC7.14 (O1)
/Expansion and Power Connectors/DEV2: CONN.2.A10 (~DEVSEL), IC7.13 (O2)
/Expansion and Power Connectors/DEV3: CONN.3.A10 (~DEVSEL), IC7.12 (O3)
/Expansion and Power Connectors/DEV4: CONN.4.A10 (~DEVSEL), IC7.11 (O4)
/Expansion and Power Connectors/DEV5: CONN.5.A10 (~DEVSEL), IC7.10 (O5)
/Expansion and Power Connectors/DEV6: CONN.6.A10 (~DEVSEL), IC7.9 (O6)
/Expansion and Power Connectors/DEV7: CONN.7.A10 (~DEVSEL), IC7.7 (O7)
/Expansion and Power Connectors/I/O1: CONN.1.B1 (~IOSEL), IC4.14 (O1)
/Expansion and Power Connectors/I/O2: CONN.2.B1 (~IOSEL), IC4.13 (O2)
/Expansion and Power Connectors/I/O3: CONN.3.B1 (~IOSEL), IC6.3
/Expansion and Power Connectors/I/O4: CONN.4.B1 (~IOSEL), IC4.11 (O4)
/Expansion and Power Connectors/I/O5: CONN.5.B1 (~IOSEL), IC4.10 (O5)
/Expansion and Power Connectors/I/O6: CONN.6.B1 (~IOSEL), IC4.9 (O6)
/Expansion and Power Connectors/I/O7: CONN.7.B1 (~IOSEL), IC4.7 (O7)
A0: CONN.1.B2 (A0), CONN.2.B2 (A0), CONN.3.B2 (A0), CONN.4.B2 (A0), CONN.5.B2 (A0), CONN.6.B2 (A0), CONN.7.B2 (A0); also elsewhere on the board
A1: CONN.1.B3 (A1), CONN.2.B3 (A1), CONN.3.B3 (A1), CONN.4.B3 (A1), CONN.5.B3 (A1), CONN.6.B3 (A1), CONN.7.B3 (A1); also elsewhere on the board
A2: CONN.1.B4 (A2), CONN.2.B4 (A2), CONN.3.B4 (A2), CONN.4.B4 (A2), CONN.5.B4 (A2), CONN.6.B4 (A2), CONN.7.B4 (A2); also elsewhere on the board
A3: CONN.1.B5 (A3), CONN.2.B5 (A3), CONN.3.B5 (A3), CONN.4.B5 (A3), CONN.5.B5 (A3), CONN.6.B5 (A3), CONN.7.B5 (A3); also elsewhere on the board
A4: CONN.1.B6 (A4), CONN.2.B6 (A4), CONN.3.B6 (A4), CONN.4.B6 (A4), CONN.5.B6 (A4), CONN.6.B6 (A4), CONN.7.B6 (A4), IC7.1 (A0); also elsewhere on the board
A5: CONN.1.B7 (A5), CONN.2.B7 (A5), CONN.3.B7 (A5), CONN.4.B7 (A5), CONN.5.B7 (A5), CONN.6.B7 (A5), CONN.7.B7 (A5), IC7.2 (A1); also elsewhere on the board
A6: CONN.1.B8 (A6), CONN.2.B8 (A6), CONN.3.B8 (A6), CONN.4.B8 (A6), CONN.5.B8 (A6), CONN.6.B8 (A6), CONN.7.B8 (A6), IC7.3 (A2); also elsewhere on the board
A7: CONN.1.B9 (A7), CONN.2.B9 (A7), CONN.3.B9 (A7), CONN.4.B9 (A7), CONN.5.B9 (A7), CONN.6.B9 (A7), CONN.7.B9 (A7), IC7.6 (E3); also elsewhere on the board
A8: CONN.1.B10 (A8), CONN.2.B10 (A8), CONN.3.B10 (A8), CONN.4.B10 (A8), CONN.5.B10 (A8), CONN.6.B10 (A8), CONN.7.B10 (A8), IC4.1 (A0); also elsewhere on the board
A9: CONN.1.B11 (A9), CONN.2.B11 (A9), CONN.3.B11 (A9), CONN.4.B11 (A9), CONN.5.B11 (A9), CONN.6.B11 (A9), CONN.7.B11 (A9), IC4.2 (A1); also elsewhere on the board
A10: CONN.1.B12 (A10), CONN.2.B12 (A10), CONN.3.B12 (A10), CONN.4.B12 (A10), CONN.5.B12 (A10), CONN.6.B12 (A10), CONN.7.B12 (A10), IC4.3 (A2); also elsewhere on the board
A11: CONN.1.B13 (A11), CONN.2.B13 (A11), CONN.3.B13 (A11), CONN.4.B13 (A11), CONN.5.B13 (A11), CONN.6.B13 (A11), CONN.7.B13 (A11), IC2.11; also elsewhere on the board
A12: CONN.1.B14 (A12), CONN.2.B14 (A12), CONN.3.B14 (A12), CONN.4.B14 (A12), CONN.5.B14 (A12), CONN.6.B14 (A12), CONN.7.B14 (A12); also elsewhere on the board
A13: CONN.1.B15 (A13), CONN.2.B15 (A13), CONN.3.B15 (A13), CONN.4.B15 (A13), CONN.5.B15 (A13), CONN.6.B15 (A13), CONN.7.B15 (A13); also elsewhere on the board
A14: CONN.1.B16 (A14), CONN.2.B16 (A14), CONN.3.B16 (A14), CONN.4.B16 (A14), CONN.5.B16 (A14), CONN.6.B16 (A14), CONN.7.B16 (A14); also elsewhere on the board
A15: CONN.1.B17 (A15), CONN.2.B17 (A15), CONN.3.B17 (A15), CONN.4.B17 (A15), CONN.5.B17 (A15), CONN.6.B17 (A15), CONN.7.B17 (A15); also elsewhere on the board
ABTLTX: P1.1 (A), P1.2 (C); also elsewhere on the board
D0: CONN.1.A2 (D0), CONN.2.A2 (D0), CONN.3.A2 (D0), CONN.4.A2 (D0), CONN.5.A2 (D0), CONN.6.A2 (D0), CONN.7.A2 (D0); also elsewhere on the board
D1: CONN.1.A3 (D1), CONN.2.A3 (D1), CONN.3.A3 (D1), CONN.4.A3 (D1), CONN.5.A3 (D1), CONN.6.A3 (D1), CONN.7.A3 (D1); also elsewhere on the board
D2: CONN.1.A4 (D2), CONN.2.A4 (D2), CONN.3.A4 (D2), CONN.4.A4 (D2), CONN.5.A4 (D2), CONN.6.A4 (D2), CONN.7.A4 (D2); also elsewhere on the board
D3: CONN.1.A5 (D3), CONN.2.A5 (D3), CONN.3.A5 (D3), CONN.4.A5 (D3), CONN.5.A5 (D3), CONN.6.A5 (D3), CONN.7.A5 (D3); also elsewhere on the board
D4: CONN.1.A6 (D4), CONN.2.A6 (D4), CONN.3.A6 (D4), CONN.4.A6 (D4), CONN.5.A6 (D4), CONN.6.A6 (D4), CONN.7.A6 (D4); also elsewhere on the board
D5: CONN.1.A7 (D5), CONN.2.A7 (D5), CONN.3.A7 (D5), CONN.4.A7 (D5), CONN.5.A7 (D5), CONN.6.A7 (D5), CONN.7.A7 (D5); also elsewhere on the board
D6: CONN.1.A8 (D6), CONN.2.A8 (D6), CONN.3.A8 (D6), CONN.4.A8 (D6), CONN.5.A8 (D6), CONN.6.A8 (D6), CONN.7.A8 (D6); also elsewhere on the board
D7: CONN.1.A9 (D7), CONN.2.A9 (D7), CONN.3.A9 (D7), CONN.4.A9 (D7), CONN.5.A9 (D7), CONN.6.A9 (D7), CONN.7.A9 (D7); also elsewhere on the board
DEV0: IC7.15 (O0); also elsewhere on the board
DMA: CONN.1.B22 (~DMA), CONN.2.B22 (~DMA), CONN.3.B22 (~DMA), CONN.4.B22 (~DMA), CONN.5.B22 (~DMA), CONN.6.B22 (~DMA), CONN.7.B22 (~DMA); also elsewhere on the board
GND: C1.2, C2.2, C3.2, C4.2, C5.2, C6.2, CONN.1.A25 (GND), CONN.2.A25 (GND), CONN.3.A25 (GND), CONN.4.A25 (GND), CONN.5.A25 (GND), CONN.6.A25 (GND), CONN.7.A25 (GND), CONN.8.1, IC4.8 (GND), IC7.5 (E2), IC7.8 (GND); also elsewhere on the board
I/O stb: CONN.1.B20 (~IO_STB), CONN.2.B20 (~IO_STB), CONN.3.B20 (~IO_STB), CONN.4.B20 (~IO_STB), CONN.5.B20 (~IO_STB), CONN.6.B20 (~IO_STB), CONN.7.B20 (~IO_STB); also elsewhere on the board
unnamed: CONN.1.B24 (~DMA_OUT), CONN.2.A24 (~DMA_IN)
unnamed: CONN.1.B23 (~INT_OUT), CONN.2.A23 (~INT_IN)
unnamed: CONN.2.B24 (~DMA_OUT), CONN.3.A24 (~DMA_IN)
unnamed: CONN.2.B23 (~INT_OUT), CONN.3.A23 (~INT_IN)
unnamed: CONN.3.B24 (~DMA_OUT), CONN.4.A24 (~DMA_IN)
unnamed: CONN.3.B23 (~INT_OUT), CONN.4.A23 (~INT_IN)
unnamed: CONN.4.B24 (~DMA_OUT), CONN.5.A24 (~DMA_IN)
unnamed: CONN.4.B23 (~INT_OUT), CONN.5.A23 (~INT_IN)
unnamed: CONN.5.B24 (~DMA_OUT), CONN.6.A24 (~DMA_IN)
unnamed: CONN.5.B23 (~INT_OUT), CONN.6.A23 (~INT_IN)
unnamed: CONN.6.B24 (~DMA_OUT), CONN.7.A24 (~DMA_IN)
unnamed: CONN.6.B23 (~INT_OUT), CONN.7.A23 (~INT_IN)
unnamed: IC1.1, IC2.10
unnamed: IC1.3, IC4.4 (E1)
unnamed: IC3.10, IC4.6 (E3)
unnamed: IC4.15 (O0), IC7.4 (E1)
unnamed: IC5.6, IC6.1
unnamed: CONN.7.A16 (n.c.), P1.3 (B)
Q3: CONN.1.A14 (Q3), CONN.2.A14 (Q3), CONN.3.A14 (Q3), CONN.4.A14 (Q3), CONN.5.A14 (Q3), CONN.6.A14 (Q3), CONN.7.A14 (Q3); also elsewhere on the board
RDY: CONN.1.B21 (~RDY), CONN.2.B21 (~RDY), CONN.3.B21 (~RDY), CONN.4.B21 (~RDY), CONN.5.B21 (~RDY), CONN.6.B21 (~RDY), CONN.7.B21 (~RDY); also elsewhere on the board
ROM C: IC4.12 (O3), IC6.2; also elsewhere on the board
R/~W: CONN.1.B18 (~R/W), CONN.2.B18 (~R/W), CONN.3.B18 (~R/W), CONN.4.B18 (~R/W), CONN.5.B18 (~R/W), CONN.6.B18 (~R/W), CONN.7.B18 (~R/W); also elsewhere on the board
SCxxx: IC4.5 (E2); also elsewhere on the board
SLC3: IC5.5; also elsewhere on the board
SLCx: IC3.8, IC3.9; also elsewhere on the board
SYNC: P2.1 (A), P2.2 (C); also elsewhere on the board
~INM: CONN.1.A19 (~INM), CONN.2.A19 (~INM), CONN.3.A19 (~INM), CONN.4.A19 (~INM), CONN.5.A19 (~INM), CONN.6.A19 (~INM), CONN.7.A19 (~INM); also elsewhere on the board
~IRQ: CONN.1.A21 (~IRQ), CONN.2.A21 (~IRQ), CONN.3.A21 (~IRQ), CONN.4.A21 (~IRQ), CONN.5.A21 (~IRQ), CONN.6.A21 (~IRQ), CONN.7.A21 (~IRQ); also elsewhere on the board
~NMI: CONN.1.A22 (~NMI), CONN.2.A22 (~NMI), CONN.3.A22 (~NMI), CONN.4.A22 (~NMI), CONN.5.A22 (~NMI), CONN.6.A22 (~NMI), CONN.7.A22 (~NMI); also elsewhere on the board
~RES: CONN.1.A20 (~RES), CONN.2.A20 (~RES), CONN.3.A20 (~RES), CONN.4.A20 (~RES), CONN.5.A20 (~RES), CONN.6.A20 (~RES), CONN.7.A20 (~RES); also elsewhere on the board
Φ0: CONN.1.A11 (Φ0), CONN.2.A11 (Φ0), CONN.3.A11 (Φ0), CONN.4.A11 (Φ0), CONN.5.A11 (Φ0), CONN.6.A11 (Φ0), CONN.7.A11 (Φ0), IC1.2; also elsewhere on the board
Φ1: CONN.1.A13 (Φ1), CONN.2.A13 (Φ1), CONN.3.A13 (Φ1), CONN.4.A13 (Φ1), CONN.5.A13 (Φ1), CONN.6.A13 (Φ1), CONN.7.A13 (Φ1); also elsewhere on the board
μPSINC: CONN.1.A12 (μP_SYNC), CONN.2.A12 (μP_SYNC), CONN.3.A12 (μP_SYNC), CONN.4.A12 (μP_SYNC), CONN.5.A12 (μP_SYNC), CONN.6.A12 (μP_SYNC), CONN.7.A12 (μP_SYNC); also elsewhere on the board

Notes on the sheet:
Note that in the original schematic B_SYNC is connected to CONN.7 only. And yet, the PCB connects it through all the other bus connectors.
