frubem/NE_Delta_Schematics/LX780_Delta-fixed/NE_Delta.kicad_pcb

## KiCad design LX780_Delta-fixed/NE_Delta.kicad_pcb (continued)

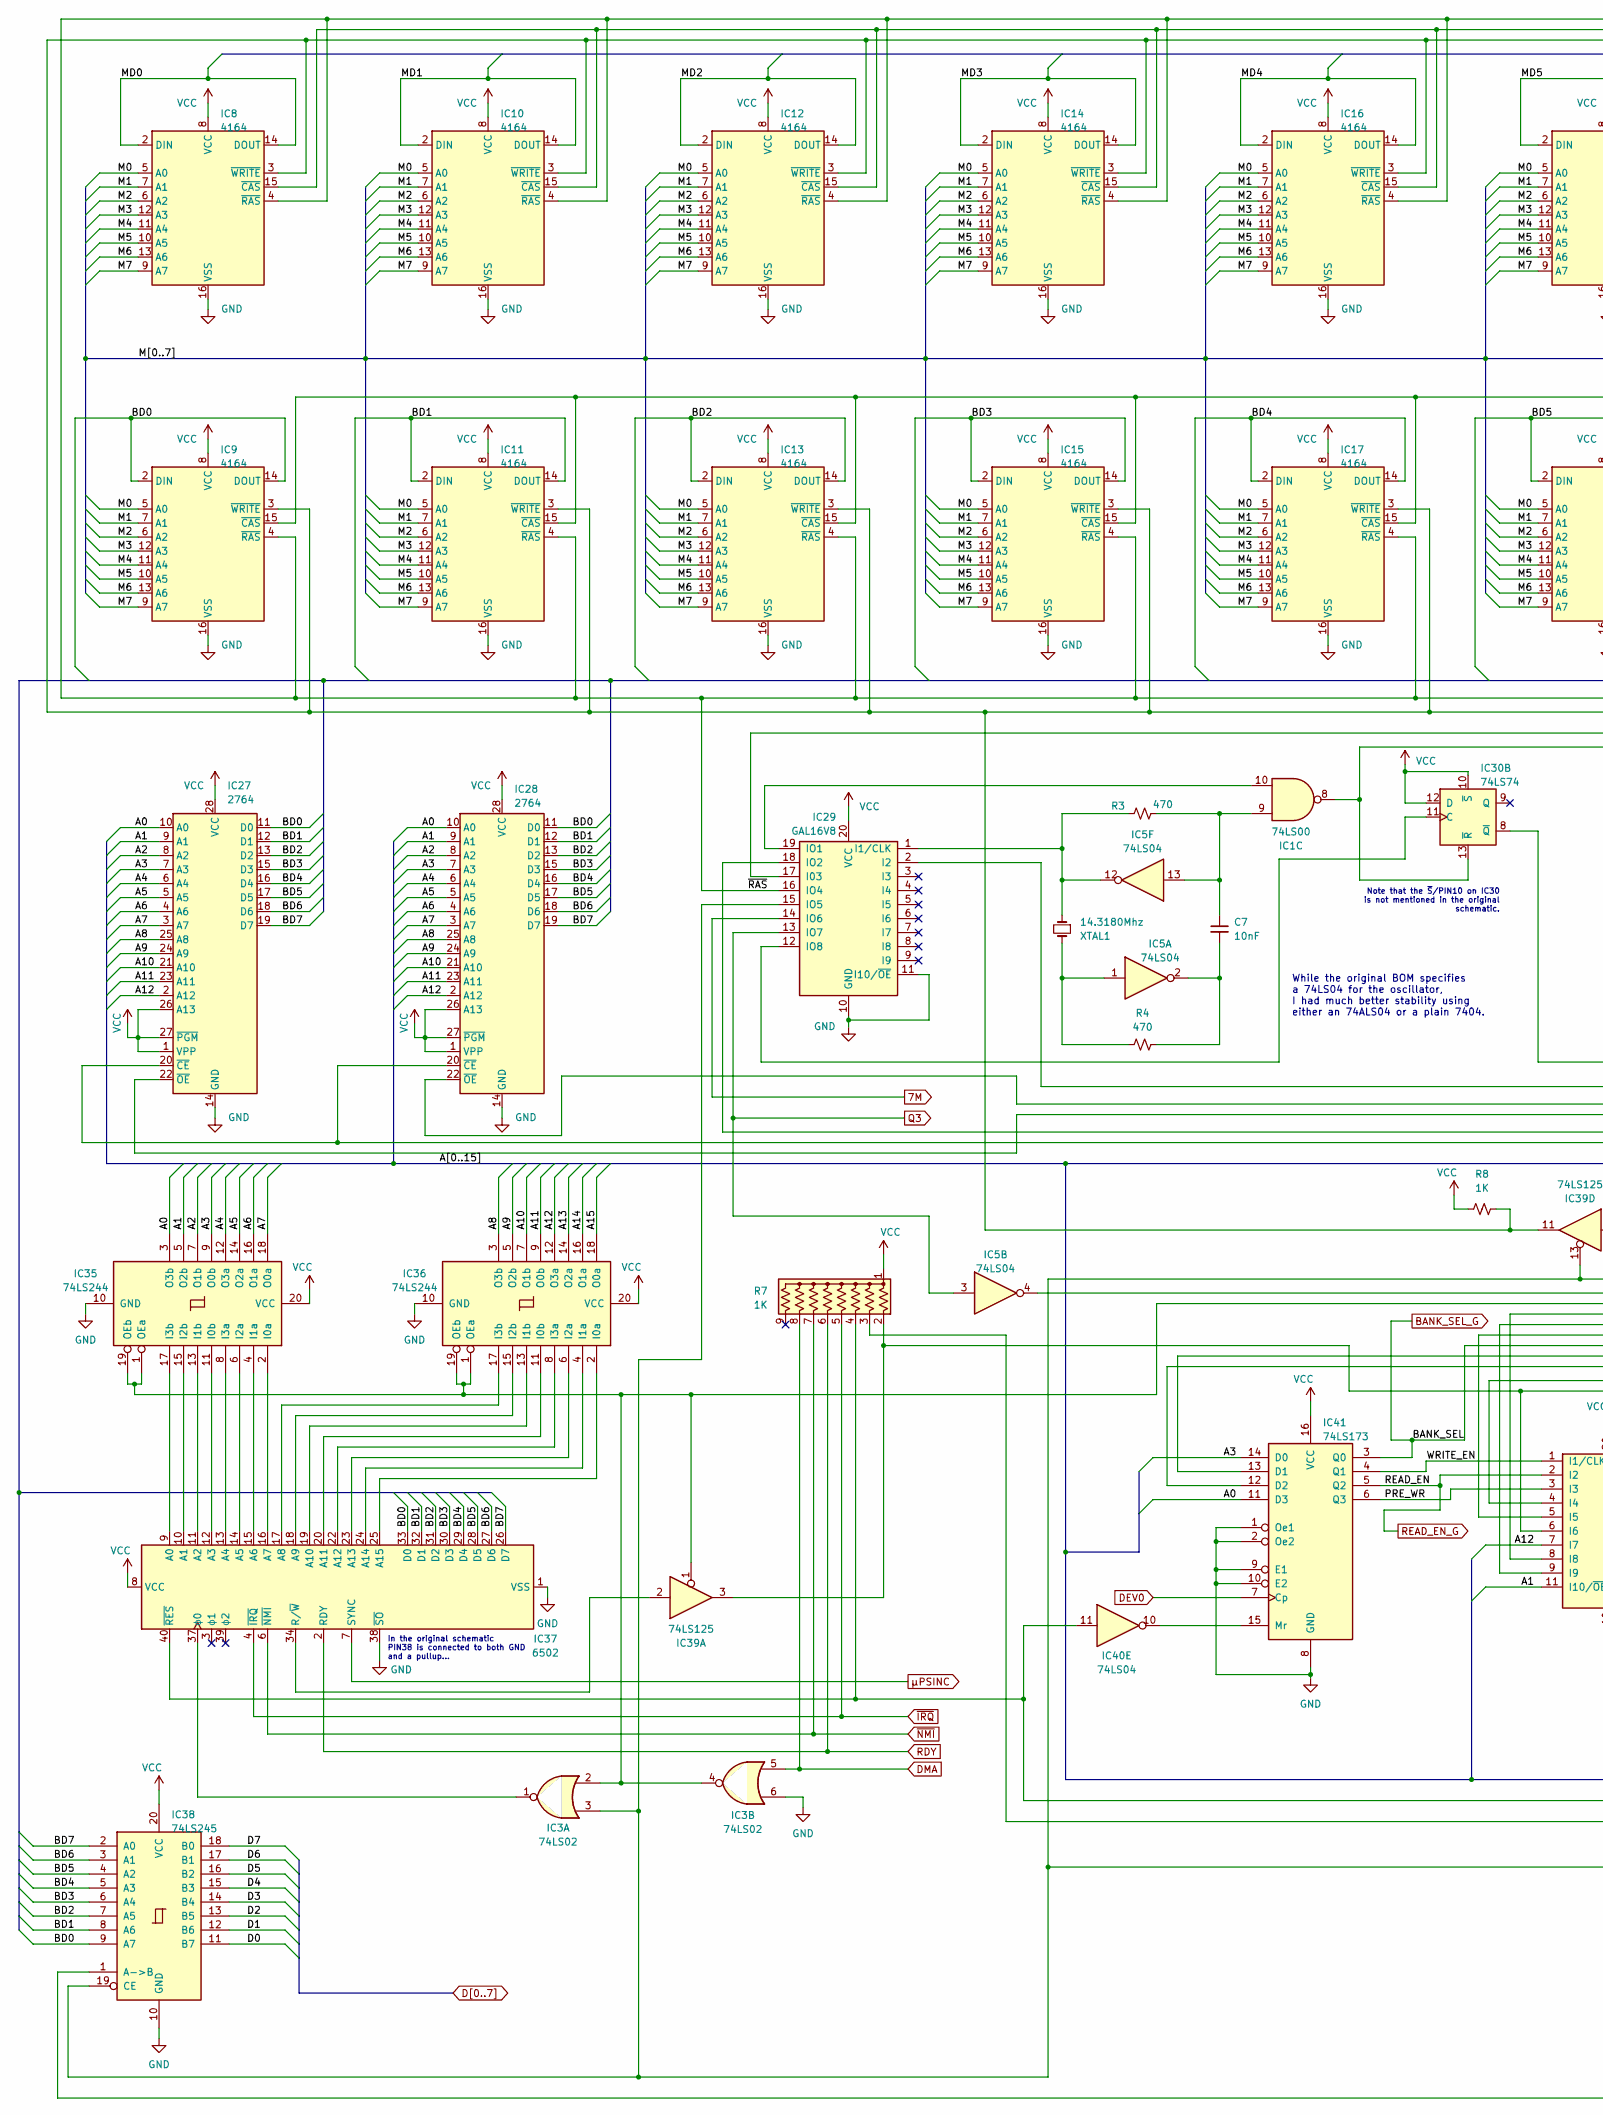
[picture p14: schematic cpu_ram.kicad_sch, part in row 1, column 1]

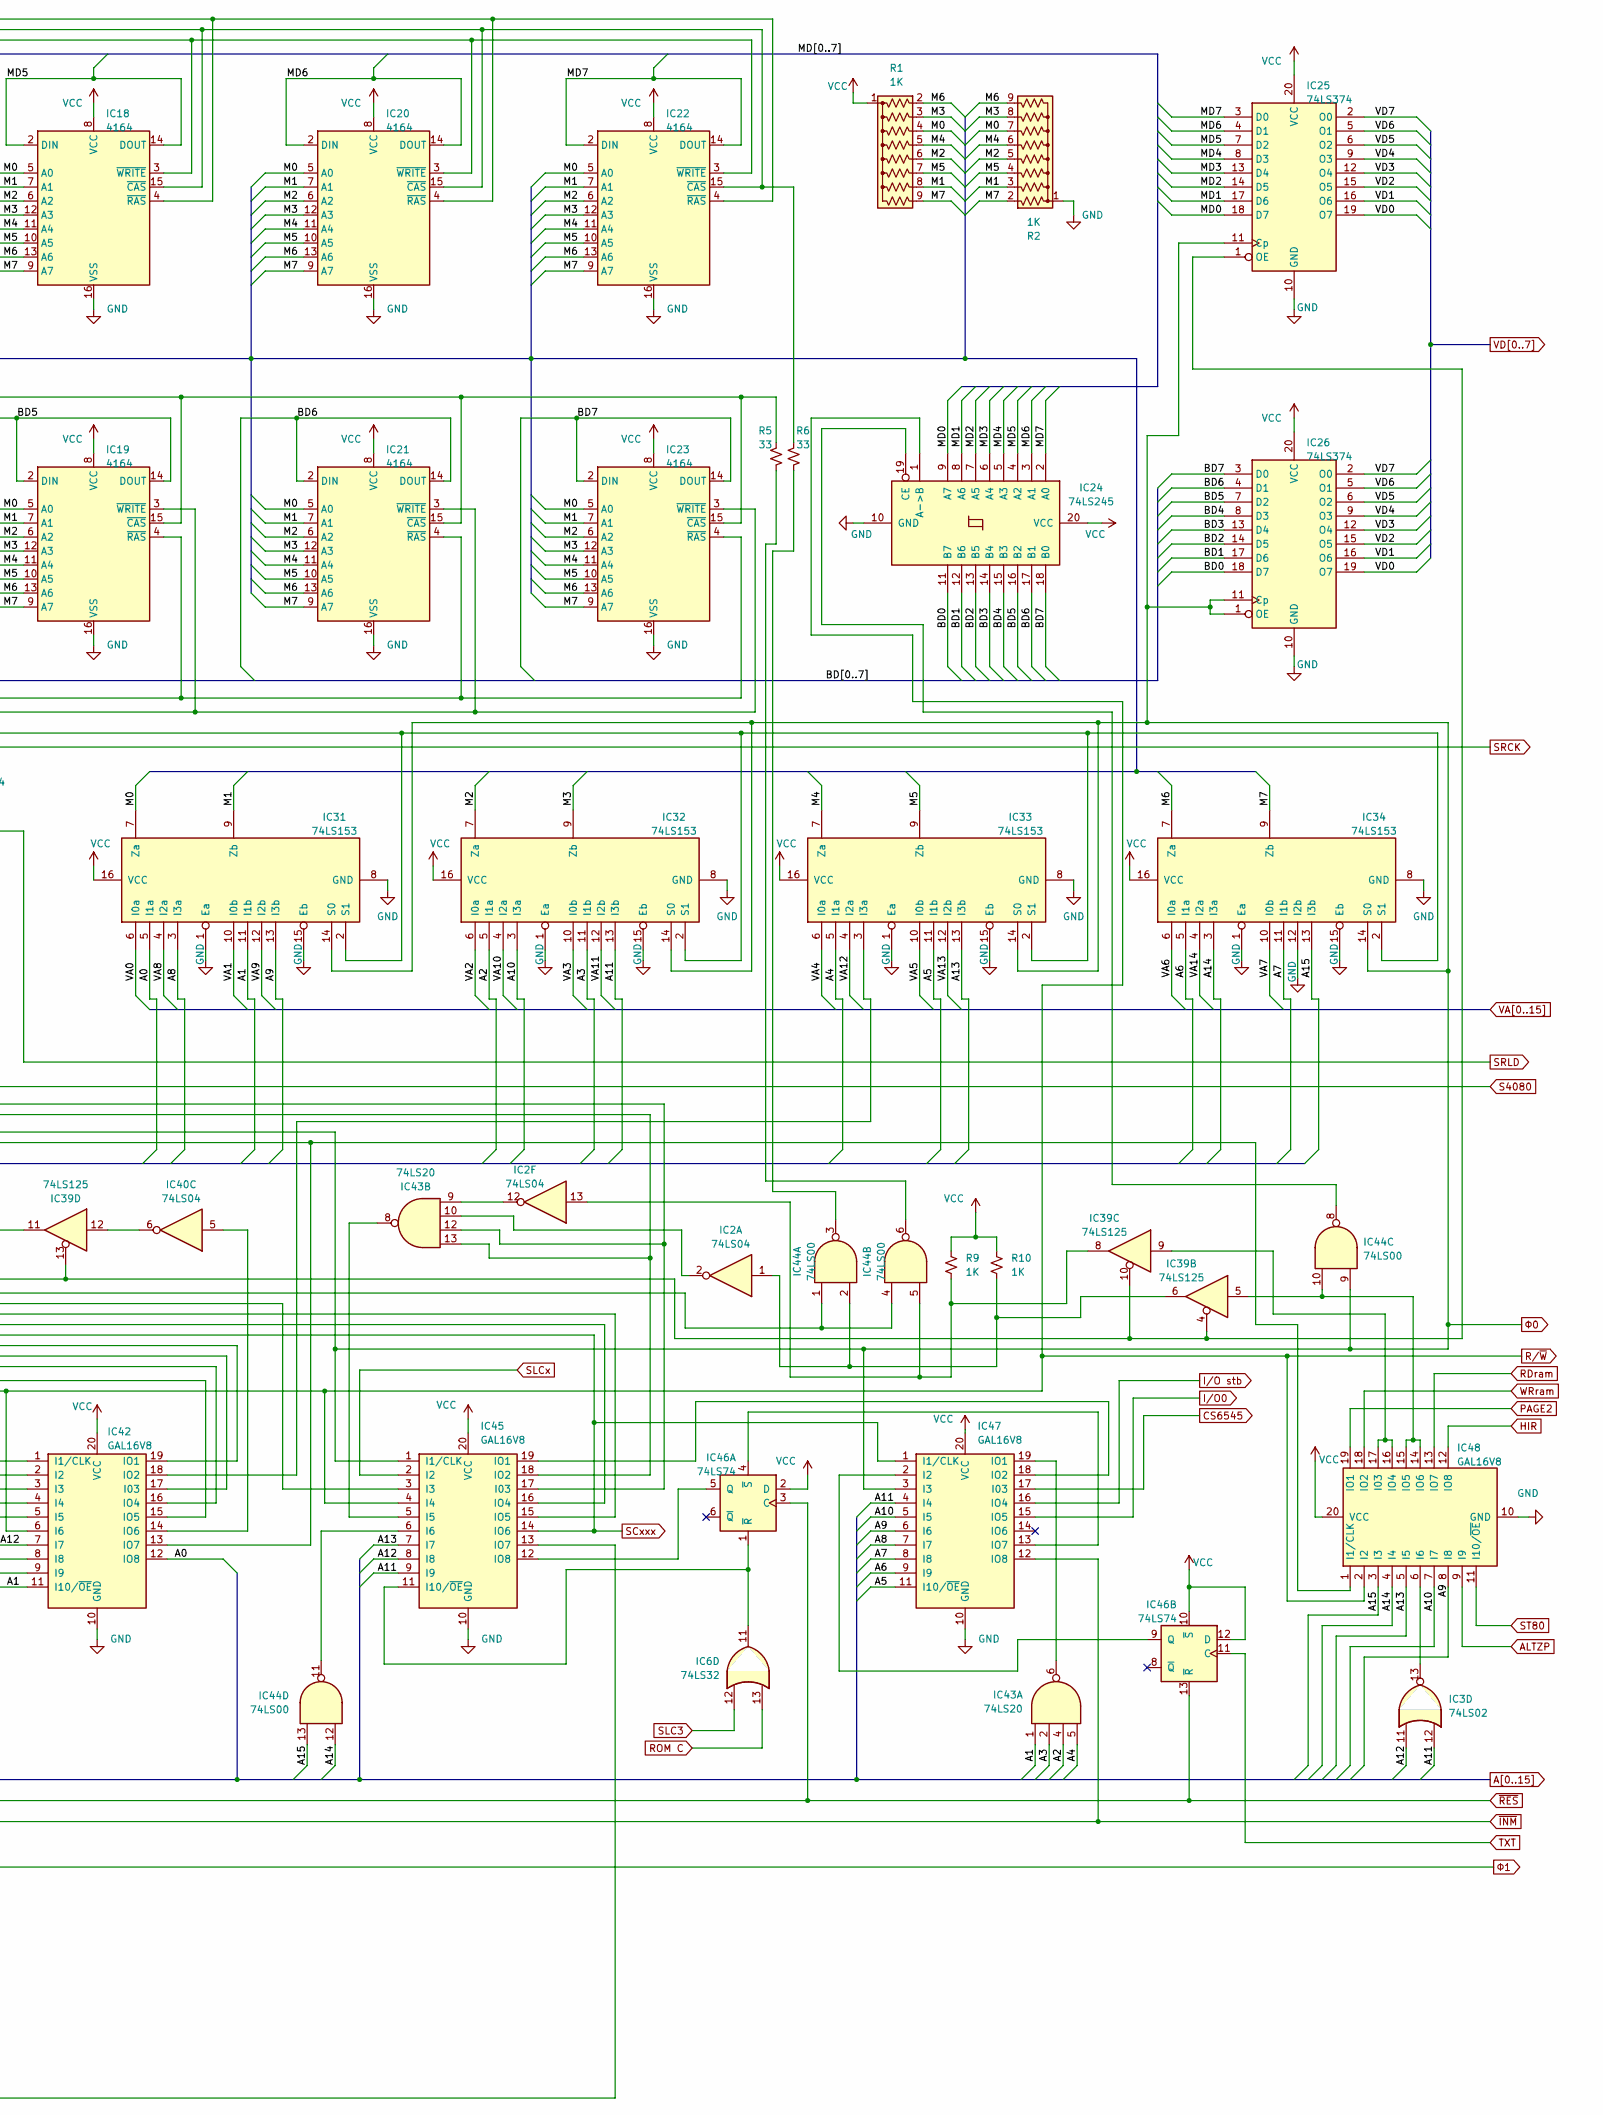
[picture p15: schematic cpu_ram.kicad_sch, part in row 1, column 2]

Parts:
C7: 10nF; C_Disc_D6.0mm_W2.5mm_P5.00mm
IC1, IC44: 74LS00; DIP-14_W7.62mm
IC2, IC5, IC40: 74LS04; DIP-14_W7.62mm
IC3: 74LS02; DIP-14_W7.62mm
IC6: 74LS32; DIP-14_W7.62mm
IC8, IC9, IC10, IC11, IC12, IC13, IC14, IC15, IC16, IC17, IC18, IC19, IC20, IC21, IC22, IC23: 4164; DIP-16_W7.62mm
IC24, IC38: 74LS245; DIP-20_W7.62mm
IC25, IC26: 74LS374; DIP-20_W7.62mm
IC27, IC28: 2764; DIP-28_W15.24mm
IC29, IC42, IC45, IC47, IC48: GAL16V8; DIP-20_W7.62mm
IC30, IC46: 74LS74; DIP-14_W7.62mm
IC31, IC32, IC33, IC34: 74LS153; DIP-16_W7.62mm
IC35, IC36: 74LS244; DIP-20_W7.62mm
IC37: 6502; DIP-40_W15.24mm
IC39: 74LS125; DIP-14_W7.62mm
IC41: 74LS173; DIP-16_W7.62mm
IC43: 74LS20; DIP-14_W7.62mm
R1, R2, R7: 1K; R_Array_SIP9
R3, R4: 470; R_Axial_DIN0309_L9.0mm_D3.2mm_P15.24mm_Horizontal
R5, R6: 33; R_Axial_DIN0309_L9.0mm_D3.2mm_P17.34mm_Horizontal
R8, R9, R10: 1K; R_Axial_DIN0309_L9.0mm_D3.2mm_P15.24mm_Horizontal
XTAL1: 14.3180Mhz; Crystal_HC18-U_Horizontal

Connections:
7M: IC29.14 (IO6); also elsewhere on the board
+5V: IC8.8 (VCC), IC9.8 (VCC), IC10.8 (VCC), IC11.8 (VCC), IC12.8 (VCC), IC13.8 (VCC), IC14.8 (VCC), IC15.8 (VCC), IC16.8 (VCC), IC17.8 (VCC), IC18.8 (VCC), IC19.8 (VCC), IC20.8 (VCC), IC21.8 (VCC), IC22.8 (VCC), IC23.8 (VCC), IC24.20 (VCC), IC25.20 (VCC), IC26.20 (VCC), IC27.1 (VPP), IC27.26 (A13), IC27.27 (~PGM), IC27.28 (VCC), IC28.1 (VPP), IC28.26 (A13), IC28.27 (~PGM), IC28.28 (VCC), IC29.20 (VCC), IC30.10 (~S), IC30.12 (D), IC31.16 (VCC), IC32.16 (VCC), IC33.16 (VCC), IC34.16 (VCC), IC35.20 (VCC), IC36.20 (VCC), IC37.8 (VCC), IC38.20 (VCC), IC41.16 (VCC), IC42.20 (VCC), IC45.20 (VCC), IC46.2 (D), IC46.10 (~S), IC46.12 (D), IC47.20 (VCC), IC48.20 (VCC), R1.1 (common), R7.1 (common), R8.1, R9.1, R10.1; also elsewhere on the board
/CPU and RAM/BD0: IC9.2 (DIN), IC9.14 (DOUT), IC24.11 (B7), IC26.18 (D7), IC27.11 (D0), IC28.11 (D0), IC37.33 (D0), IC38.9 (A7)
/CPU and RAM/BD1: IC11.2 (DIN), IC11.14 (DOUT), IC24.12 (B6), IC26.17 (D6), IC27.12 (D1), IC28.12 (D1), IC37.32 (D1), IC38.8 (A6)
/CPU and RAM/BD2: IC13.2 (DIN), IC13.14 (DOUT), IC24.13 (B5), IC26.14 (D5), IC27.13 (D2), IC28.13 (D2), IC37.31 (D2), IC38.7 (A5)
/CPU and RAM/BD3: IC15.2 (DIN), IC15.14 (DOUT), IC24.14 (B4), IC26.13 (D4), IC27.15 (D3), IC28.15 (D3), IC37.30 (D3), IC38.6 (A4)
/CPU and RAM/BD4: IC17.2 (DIN), IC17.14 (DOUT), IC24.15 (B3), IC26.8 (D3), IC27.16 (D4), IC28.16 (D4), IC37.29 (D4), IC38.5 (A3)
/CPU and RAM/BD5: IC19.2 (DIN), IC19.14 (DOUT), IC24.16 (B2), IC26.7 (D2), IC27.17 (D5), IC28.17 (D5), IC37.28 (D5), IC38.4 (A2)
/CPU and RAM/BD6: IC21.2 (DIN), IC21.14 (DOUT), IC24.17 (B1), IC26.4 (D1), IC27.18 (D6), IC28.18 (D6), IC37.27 (D6), IC38.3 (A1)
/CPU and RAM/BD7: IC23.2 (DIN), IC23.14 (DOUT), IC24.18 (B0), IC26.3 (D0), IC27.19 (D7), IC28.19 (D7), IC37.26 (D7), IC38.2 (A0)
/CPU and RAM/M0: IC8.5 (A0), IC9.5 (A0), IC10.5 (A0), IC11.5 (A0), IC12.5 (A0), IC13.5 (A0), IC14.5 (A0), IC15.5 (A0), IC16.5 (A0), IC17.5 (A0), IC18.5 (A0), IC19.5 (A0), IC20.5 (A0), IC21.5 (A0), IC22.5 (A0), IC23.5 (A0), IC31.7 (Za), R1.4 (R3), R2.7 (R6)
/CPU and RAM/M1: IC8.7 (A1), IC9.7 (A1), IC10.7 (A1), IC11.7 (A1), IC12.7 (A1), IC13.7 (A1), IC14.7 (A1), IC15.7 (A1), IC16.7 (A1), IC17.7 (A1), IC18.7 (A1), IC19.7 (A1), IC20.7 (A1), IC21.7 (A1), IC22.7 (A1), IC23.7 (A1), IC31.9 (Zb), R1.8 (R7), R2.3 (R2)
/CPU and RAM/M2: IC8.6 (A2), IC9.6 (A2), IC10.6 (A2), IC11.6 (A2), IC12.6 (A2), IC13.6 (A2), IC14.6 (A2), IC15.6 (A2), IC16.6 (A2), IC17.6 (A2), IC18.6 (A2), IC19.6 (A2), IC20.6 (A2), IC21.6 (A2), IC22.6 (A2), IC23.6 (A2), IC32.7 (Za), R1.6 (R5), R2.5 (R4)
/CPU and RAM/M3: IC8.12 (A3), IC9.12 (A3), IC10.12 (A3), IC11.12 (A3), IC12.12 (A3), IC13.12 (A3), IC14.12 (A3), IC15.12 (A3), IC16.12 (A3), IC17.12 (A3), IC18.12 (A3), IC19.12 (A3), IC20.12 (A3), IC21.12 (A3), IC22.12 (A3), IC23.12 (A3), IC32.9 (Zb), R1.3 (R2), R2.8 (R7)
/CPU and RAM/M4: IC8.11 (A4), IC9.11 (A4), IC10.11 (A4), IC11.11 (A4), IC12.11 (A4), IC13.11 (A4), IC14.11 (A4), IC15.11 (A4), IC16.11 (A4), IC17.11 (A4), IC18.11 (A4), IC19.11 (A4), IC20.11 (A4), IC21.11 (A4), IC22.11 (A4), IC23.11 (A4), IC33.7 (Za), R1.5 (R4), R2.6 (R5)
/CPU and RAM/M5: IC8.10 (A5), IC9.10 (A5), IC10.10 (A5), IC11.10 (A5), IC12.10 (A5), IC13.10 (A5), IC14.10 (A5), IC15.10 (A5), IC16.10 (A5), IC17.10 (A5), IC18.10 (A5), IC19.10 (A5), IC20.10 (A5), IC21.10 (A5), IC22.10 (A5), IC23.10 (A5), IC33.9 (Zb), R1.7 (R6), R2.4 (R3)
/CPU and RAM/M6: IC8.13 (A6), IC9.13 (A6), IC10.13 (A6), IC11.13 (A6), IC12.13 (A6), IC13.13 (A6), IC14.13 (A6), IC15.13 (A6), IC16.13 (A6), IC17.13 (A6), IC18.13 (A6), IC19.13 (A6), IC20.13 (A6), IC21.13 (A6), IC22.13 (A6), IC23.13 (A6), IC34.7 (Za), R1.2 (R1), R2.9 (R8)
/CPU and RAM/M7: IC8.9 (A7), IC9.9 (A7), IC10.9 (A7), IC11.9 (A7), IC12.9 (A7), IC13.9 (A7), IC14.9 (A7), IC15.9 (A7), IC16.9 (A7), IC17.9 (A7), IC18.9 (A7), IC19.9 (A7), IC20.9 (A7), IC21.9 (A7), IC22.9 (A7), IC23.9 (A7), IC34.9 (Zb), R1.9 (R8), R2.2 (R1)
/CPU and RAM/MD0: IC8.2 (DIN), IC8.14 (DOUT), IC24.9 (A7), IC25.18 (D7)
/CPU and RAM/MD1: IC10.2 (DIN), IC10.14 (DOUT), IC24.8 (A6), IC25.17 (D6)
/CPU and RAM/MD2: IC12.2 (DIN), IC12.14 (DOUT), IC24.7 (A5), IC25.14 (D5)
/CPU and RAM/MD3: IC14.2 (DIN), IC14.14 (DOUT), IC24.6 (A4), IC25.13 (D4)
/CPU and RAM/MD4: IC16.2 (DIN), IC16.14 (DOUT), IC24.5 (A3), IC25.8 (D3)
/CPU and RAM/MD5: IC18.2 (DIN), IC18.14 (DOUT), IC24.4 (A2), IC25.7 (D2)
/CPU and RAM/MD6: IC20.2 (DIN), IC20.14 (DOUT), IC24.3 (A1), IC25.4 (D1)
/CPU and RAM/MD7: IC22.2 (DIN), IC22.14 (DOUT), IC24.2 (A0), IC25.3 (D0)
/CPU and RAM/~RAS: IC8.4 (~RAS), IC9.4 (~RAS), IC10.4 (~RAS), IC11.4 (~RAS), IC12.4 (~RAS), IC13.4 (~RAS), IC14.4 (~RAS), IC15.4 (~RAS), IC16.4 (~RAS), IC17.4 (~RAS), IC18.4 (~RAS), IC19.4 (~RAS), IC20.4 (~RAS), IC21.4 (~RAS), IC22.4 (~RAS), IC23.4 (~RAS), IC29.16 (IO4)
A0: IC27.10 (A0), IC28.10 (A0), IC31.5 (I1a), IC35.3 (O3b), IC41.11 (D3), IC42.12 (IO8); also elsewhere on the board
A1: IC27.9 (A1), IC28.9 (A1), IC31.11 (I1b), IC35.5 (O2b), IC42.11 (I10/~OE), IC43.1; also elsewhere on the board
A2: IC27.8 (A2), IC28.8 (A2), IC32.5 (I1a), IC35.7 (O1b), IC43.4; also elsewhere on the board
A3: IC27.7 (A3), IC28.7 (A3), IC32.11 (I1b), IC35.9 (O0b), IC41.14 (D0), IC43.2; also elsewhere on the board
A4: IC27.6 (A4), IC28.6 (A4), IC33.5 (I1a), IC35.12 (O3a), IC43.5; also elsewhere on the board
A5: IC27.5 (A5), IC28.5 (A5), IC33.11 (I1b), IC35.14 (O2a), IC47.11 (I10/~OE); also elsewhere on the board
A6: IC27.4 (A6), IC28.4 (A6), IC34.5 (I1a), IC35.16 (O1a), IC47.9 (I9); also elsewhere on the board
A7: IC27.3 (A7), IC28.3 (A7), IC34.11 (I1b), IC35.18 (O0a), IC47.8 (I8); also elsewhere on the board
A8: IC27.25 (A8), IC28.25 (A8), IC31.3 (I3a), IC36.3 (O3b), IC47.7 (I7); also elsewhere on the board
A9: IC27.24 (A9), IC28.24 (A9), IC31.13 (I3b), IC36.5 (O2b), IC47.6 (I6), IC48.8 (I8); also elsewhere on the board
A10: IC27.21 (A10), IC28.21 (A10), IC32.3 (I3a), IC36.7 (O1b), IC47.5 (I5), IC48.7 (I7); also elsewhere on the board
A11: IC3.12, IC27.23 (A11), IC28.23 (A11), IC32.13 (I3b), IC36.9 (O0b), IC45.9 (I9), IC47.4 (I4); also elsewhere on the board
A12: IC3.11, IC27.2 (A12), IC28.2 (A12), IC36.12 (O3a), IC42.7 (I7), IC45.8 (I8); also elsewhere on the board
A13: IC33.13 (I3b), IC36.14 (O2a), IC45.7 (I7), IC48.5 (I5); also elsewhere on the board
A14: IC34.3 (I3a), IC36.16 (O1a), IC44.12, IC48.4 (I4); also elsewhere on the board
A15: IC34.13 (I3b), IC36.18 (O0a), IC44.13, IC48.3 (I3); also elsewhere on the board
ALTZP: IC48.9 (I9); also elsewhere on the board
CS6545: IC47.17 (I03); also elsewhere on the board
D0: IC38.11 (B7); also elsewhere on the board
D1: IC38.12 (B6); also elsewhere on the board
D2: IC38.13 (B5); also elsewhere on the board
D3: IC38.14 (B4); also elsewhere on the board
D4: IC38.15 (B3); also elsewhere on the board
D5: IC38.16 (B2); also elsewhere on the board
D6: IC38.17 (B1); also elsewhere on the board
D7: IC38.18 (B0); also elsewhere on the board
DEV0: IC41.7 (Cp); also elsewhere on the board
DMA: IC3.5, R7.8 (R7); also elsewhere on the board
GND: IC3.6, IC8.16 (VSS), IC9.16 (VSS), IC10.16 (VSS), IC11.16 (VSS), IC12.16 (VSS), IC13.16 (VSS), IC14.16 (VSS), IC15.16 (VSS), IC16.16 (VSS), IC17.16 (VSS), IC18.16 (VSS), IC19.16 (VSS), IC20.16 (VSS), IC21.16 (VSS), IC22.16 (VSS), IC23.16 (VSS), IC24.10 (GND), IC25.10 (GND), IC26.10 (GND), IC27.14 (GND), IC28.14 (GND), IC29.10 (GND), IC29.11 (I10/~OE), IC31.1 (Ea), IC31.8 (GND), IC31.15 (Eb), IC32.1 (Ea), IC32.8 (GND), IC32.15 (Eb), IC33.1 (Ea), IC33.8 (GND), IC33.15 (Eb), IC34.1 (Ea), IC34.8 (GND), IC34.12 (I2b), IC34.15 (Eb), IC35.10 (GND), IC36.10 (GND), IC37.1 (VSS), IC37.21 (VSS), IC37.38 (~SO), IC38.10 (GND), IC41.1 (Oe1), IC41.2 (Oe2), IC41.8 (GND), IC41.9 (E1), IC41.10 (E2), IC42.10 (GND), IC45.10 (GND), IC47.10 (GND), IC48.10 (GND), R2.1 (common); also elsewhere on the board
HIR: IC48.12 (IO8); also elsewhere on the board
I/O0: IC47.15 (IO5); also elsewhere on the board
I/O stb: IC47.16 (IO4); also elsewhere on the board
unnamed: C7.1, IC1.9, IC5.13, R3.2
unnamed: C7.2, IC5.2, R4.2
unnamed: IC2.1, IC39.6, IC44.2, R10.2
unnamed: IC2.2, IC43.10
unnamed: IC2.12, IC43.9
unnamed: IC2.13, IC39.8, IC44.5, R9.2
unnamed: IC5.1, R4.1, XTAL1.2
unnamed: IC8.15 (~CAS), IC10.15 (~CAS), IC12.15 (~CAS), IC14.15 (~CAS), IC16.15 (~CAS), IC18.15 (~CAS), IC20.15 (~CAS), IC22.15 (~CAS), R6.1
unnamed: IC8.3 (~WRITE), IC9.3 (~WRITE), IC10.3 (~WRITE), IC11.3 (~WRITE), IC12.3 (~WRITE), IC13.3 (~WRITE), IC14.3 (~WRITE), IC15.3 (~WRITE), IC16.3 (~WRITE), IC17.3 (~WRITE), IC18.3 (~WRITE), IC19.3 (~WRITE), IC20.3 (~WRITE), IC21.3 (~WRITE), IC22.3 (~WRITE), IC23.3 (~WRITE), IC39.11, R8.2
unnamed: IC9.15 (~CAS), IC11.15 (~CAS), IC13.15 (~CAS), IC15.15 (~CAS), IC17.15 (~CAS), IC19.15 (~CAS), IC21.15 (~CAS), IC23.15 (~CAS), R5.1
unnamed: IC24.19 (CE), IC44.8
unnamed: IC27.20 (~CE), IC28.20 (~CE), IC42.13 (IO7), IC48.1 (I1/CLK)
unnamed: IC27.22 (~OE), IC43.13, IC45.18 (IO2)
unnamed: IC28.22 (~OE), IC43.12, IC45.17 (I03)
unnamed: IC5.12, IC29.1 (I1/CLK), R3.1, XTAL1.1
unnamed: IC29.17 (I03), IC31.2 (S1), IC32.2 (S1), IC33.2 (S1), IC34.2 (S1)
unnamed: IC1.10, IC29.19 (IO1)
unnamed: IC29.12 (IO8), IC30.11 (C)
unnamed: IC33.3 (I3a), IC42.18 (IO2)
unnamed: IC35.2 (I0a), IC37.16 (A7)
unnamed: IC35.11 (I0b), IC37.12 (A3)
unnamed: IC35.4 (I1a), IC37.15 (A6)
unnamed: IC35.13 (I1b), IC37.11 (A2)
unnamed: IC35.6 (I2a), IC37.14 (A5)
unnamed: IC35.15 (I2b), IC37.10 (A1)
unnamed: IC35.8 (I3a), IC37.13 (A4)
unnamed: IC35.17 (I3b), IC37.9 (A0)
unnamed: IC3.2, IC3.4, IC35.1 (OEa), IC35.19 (OEb), IC36.1 (OEa), IC36.19 (OEb), IC39.1, IC45.3 (I3)
unnamed: IC36.2 (I0a), IC37.25 (A15)
unnamed: IC36.11 (I0b), IC37.20 (A11)
unnamed: IC36.4 (I1a), IC37.24 (A14)
unnamed: IC36.13 (I1b), IC37.19 (A10)
unnamed: IC36.6 (I2a), IC37.23 (A13)
unnamed: IC36.15 (I2b), IC37.18 (A9)
unnamed: IC36.8 (I3a), IC37.22 (A12)
unnamed: IC36.17 (I3b), IC37.17 (A8)
unnamed: IC37.34 (R/~W), IC39.2
unnamed: IC3.1, IC37.37 (ϕ0)
unnamed: IC38.1 (A->B), IC45.13 (IO7)
unnamed: IC39.12, IC40.6
unnamed: IC41.13 (D1), IC42.17 (I03)
unnamed: IC41.12 (D2), IC42.16 (IO4)
unnamed: IC40.10, IC41.15 (Mr)
unnamed: IC41.4 (Q1), IC42.1 (I1/CLK)
unnamed: IC41.6 (Q3), IC42.3 (I3)
unnamed: IC42.4 (I4), IC42.15 (IO5)
unnamed: IC42.8 (I8), IC45.15 (IO5)
unnamed: IC42.9 (I9), IC45.16 (IO4)
unnamed: IC40.5, IC42.14 (IO6)
unnamed: IC5.4, IC44.1, IC44.4
unnamed: IC44.3, R6.2
unnamed: IC44.6, R5.2
unnamed: IC43.8, IC45.5 (I5)
unnamed: IC44.11, IC45.6 (I6)
unnamed: IC6.11, IC45.11 (I10/~OE), IC46.1 (~R)
unnamed: IC45.19 (IO1), IC47.18 (IO2)
unnamed: IC45.12 (IO8), IC46.5 (Q)
unnamed: IC46.4 (~S), IC47.13 (IO7)
unnamed: IC46.9 (Q), IC47.2 (I2)
unnamed: IC43.6, IC47.19 (IO1)
unnamed: IC39.9, IC48.16 (IO4), IC48.17 (I03)
unnamed: IC3.13, IC48.6 (I6)
unnamed: IC39.5, IC44.10, IC48.14 (IO6), IC48.15 (IO5)
PAGE2: IC48.19 (IO1); also elsewhere on the board
Q3: IC5.3, IC29.13 (IO7); also elsewhere on the board
RDY: IC37.2 (RDY), R7.6 (R5); also elsewhere on the board
RDram: IC48.13 (IO7); also elsewhere on the board
ROM C: IC6.13; also elsewhere on the board
R/~W: IC24.1 (A->B), IC39.3, IC42.6 (I6), IC45.4 (I4), IC48.2 (I2), R7.2 (R1); also elsewhere on the board
S4080: IC29.2 (I2); also elsewhere on the board
SCxxx: IC42.5 (I5), IC45.14 (IO6), IC47.1 (I1/CLK); also elsewhere on the board
SLC3: IC6.12; also elsewhere on the board
SLCx: IC45.2 (I2); also elsewhere on the board
SRCK: IC1.8, IC30.13 (~R); also elsewhere on the board
SRLD: IC30.8 (~Q); also elsewhere on the board
ST80: IC48.11 (I10/~OE); also elsewhere on the board
TXT: IC46.11 (C); also elsewhere on the board
VA0: IC31.6 (I0a); also elsewhere on the board
VA1: IC31.10 (I0b); also elsewhere on the board
VA2: IC32.6 (I0a); also elsewhere on the board
VA3: IC32.10 (I0b); also elsewhere on the board
VA4: IC33.6 (I0a); also elsewhere on the board
VA5: IC33.10 (I0b); also elsewhere on the board
VA6: IC34.6 (I0a); also elsewhere on the board
VA7: IC34.10 (I0b); also elsewhere on the board
VA8: IC31.4 (I2a); also elsewhere on the board
VA9: IC31.12 (I2b); also elsewhere on the board
VA10: IC32.4 (I2a); also elsewhere on the board
VA11: IC32.12 (I2b); also elsewhere on the board
VA12: IC33.4 (I2a); also elsewhere on the board
VA13: IC33.12 (I2b); also elsewhere on the board
VA14: IC34.4 (I2a); also elsewhere on the board
VD0: IC25.19 (O7), IC26.19 (O7); also elsewhere on the board
VD1: IC25.16 (O6), IC26.16 (O6); also elsewhere on the board
VD2: IC25.15 (O5), IC26.15 (O5); also elsewhere on the board
VD3: IC25.12 (O4), IC26.12 (O4); also elsewhere on the board
VD4: IC25.9 (O3), IC26.9 (O3); also elsewhere on the board
VD5: IC25.6 (O2), IC26.6 (O2); also elsewhere on the board
VD6: IC25.5 (O1), IC26.5 (O1); also elsewhere on the board
VD7: IC25.2 (O0), IC26.2 (O0); also elsewhere on the board
WRram: IC48.18 (IO2); also elsewhere on the board
~INM: IC47.12 (IO8), R7.3 (R2); also elsewhere on the board
~IRQ: IC37.4 (~IRQ), R7.5 (R4); also elsewhere on the board
~NMI: IC37.6 (~NMI), R7.7 (R6); also elsewhere on the board
~RES: IC37.40 (~RES), IC40.11, IC46.3 (C), IC46.13 (~R), R7.4 (R3); also elsewhere on the board
Φ0: IC25.11 (Cp), IC26.1 (OE), IC26.11 (Cp), IC29.18 (IO2), IC31.14 (S0), IC32.14 (S0), IC33.14 (S0), IC34.14 (S0), IC44.9, IC45.1 (I1/CLK), IC47.3 (I3); also elsewhere on the board
Φ1: IC3.3, IC25.1 (OE), IC29.15 (IO5), IC38.19 (CE), IC39.4, IC39.10, IC39.13; also elsewhere on the board
μPSINC: IC37.7 (SYNC); also elsewhere on the board

Notes on the sheet:
In the original schematic PIN38 is connected to both GND and a pullup...
While the original BOM specifies a 74LS04 for the oscillator, I had much better stability using either an 74ALS04 or a plain 7404.
Note that the ~{S}/PIN10 on IC30 is not mentioned in the original schematic.
