frubem/NE_Delta_Schematics/LX780_Delta-fixed/NE_Delta.kicad_pcb

## KiCad design LX780_Delta-fixed/NE_Delta.kicad_pcb (continued)

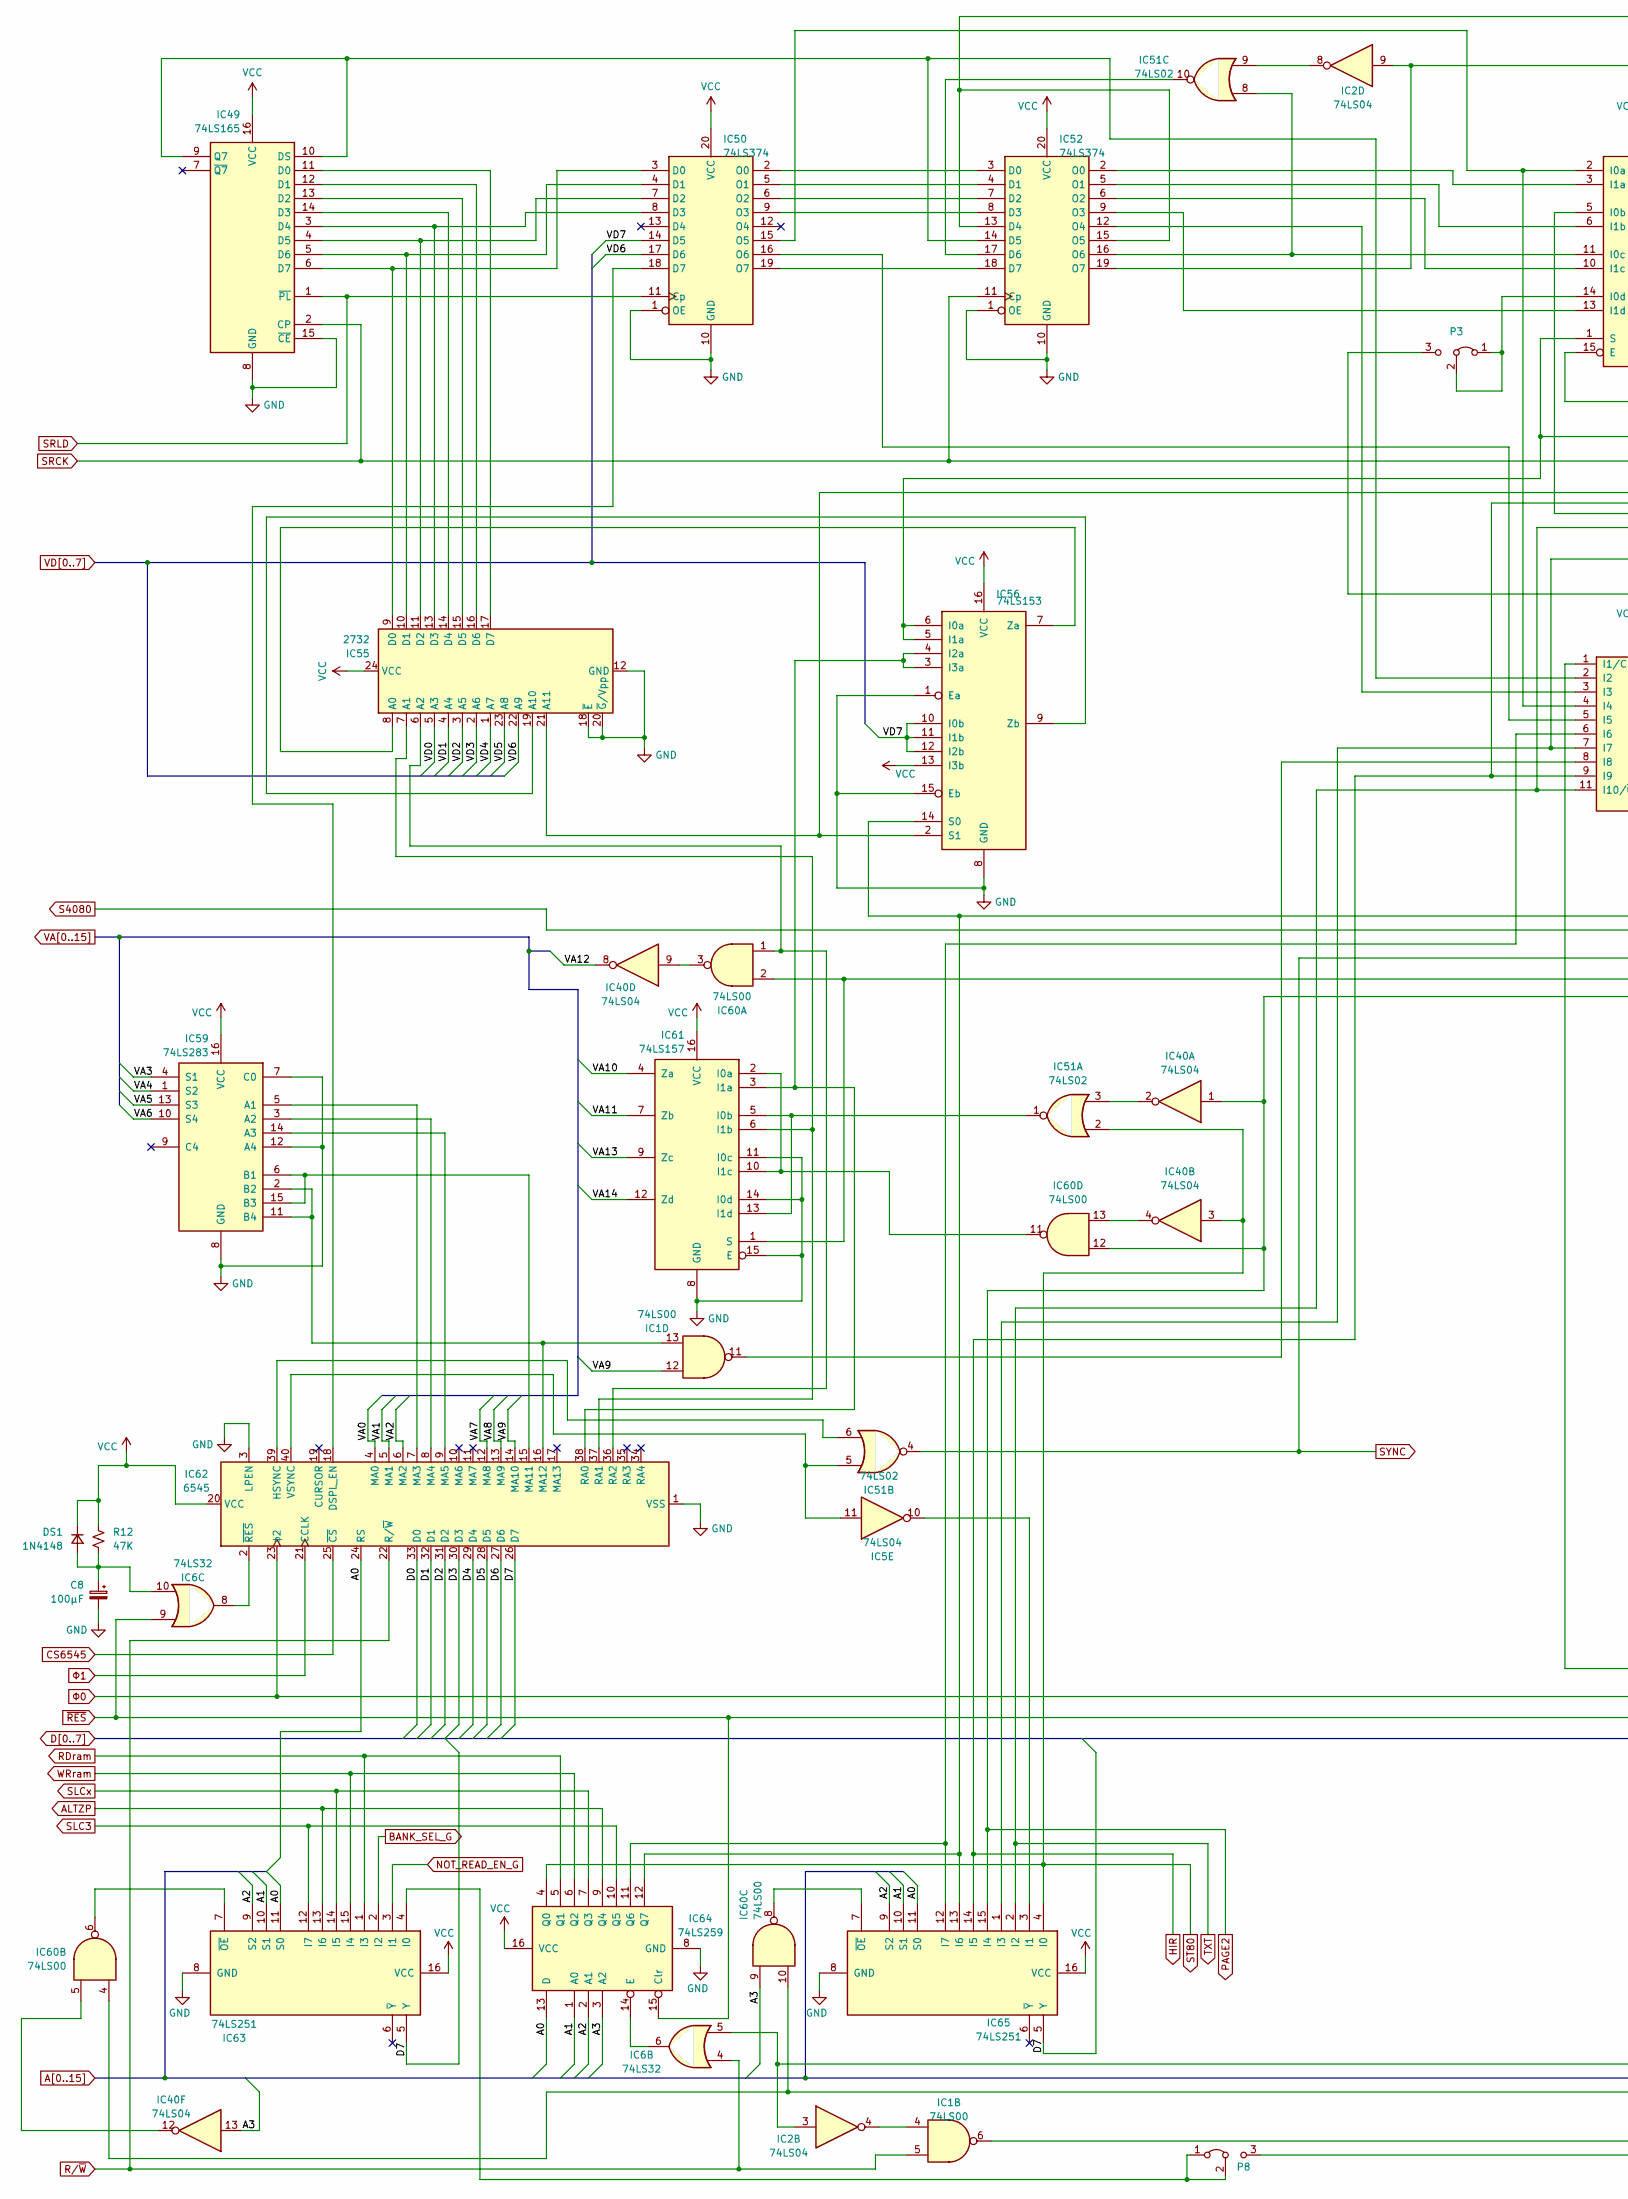
[picture p16: schematic io.kicad_sch, part in row 1, column 1]

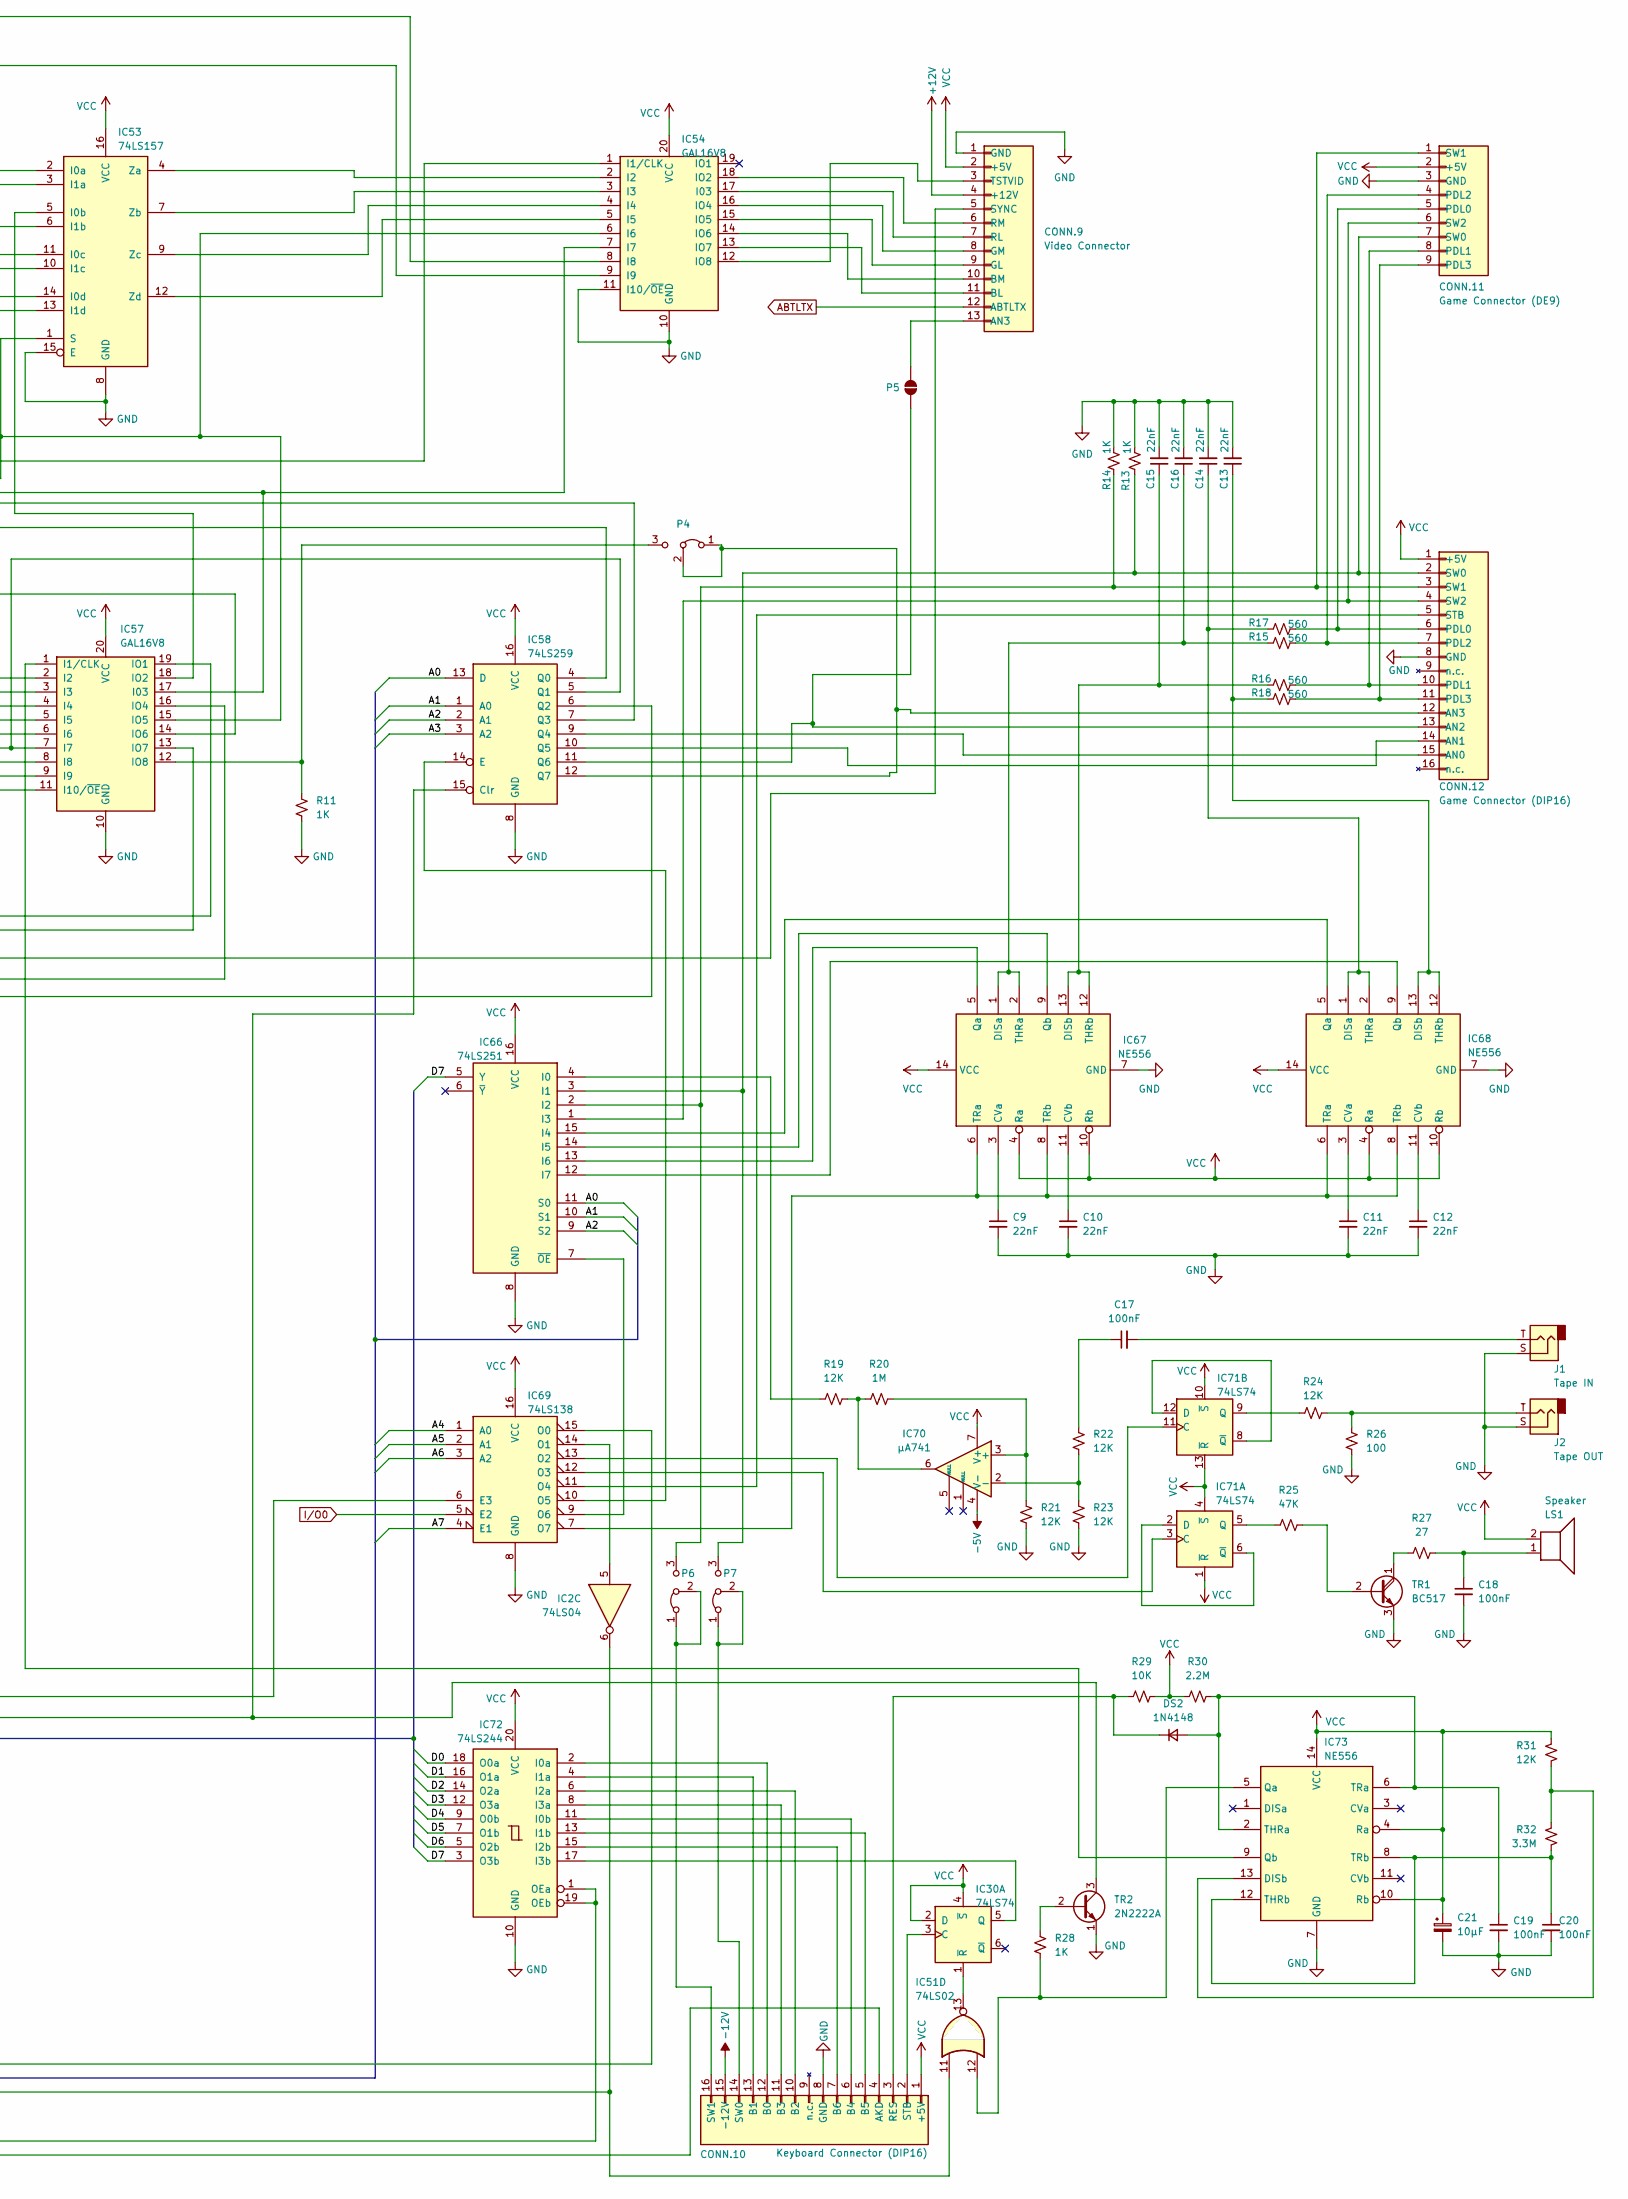
[picture p17: schematic io.kicad_sch, part in row 1, column 2]

Parts:
C8: 100μF; CP_Radial_D8.0mm_P3.50mm
C9, C10, C11, C12, C13, C14, C15, C16: 22nF; C_Disc_D6.0mm_W2.5mm_P5.00mm
C17, C18, C19, C20: 100nF; C_Disc_D6.0mm_W2.5mm_P5.00mm
C21: 10μF; CP_Radial_D8.0mm_P3.50mm
CONN.9: Video Connector; PinSocket_1x13_P2.54mm_Vertical
CONN.10: Keyboard Connector (DIP16); DIP-16_W7.62mm
CONN.11: Game Connector (DE9); DSUB-9_Socket_Horizontal
CONN.12: Game Connector (DIP16); DIP-16_W7.62mm
DS1, DS2: 1N4148; D_DO-35_SOD27_P15.24mm_Horizontal
IC1, IC60: 74LS00; DIP-14_W7.62mm
IC2, IC5, IC40: 74LS04; DIP-14_W7.62mm
IC6: 74LS32; DIP-14_W7.62mm
IC30, IC71: 74LS74; DIP-14_W7.62mm
IC49: 74LS165; DIP-16_W7.62mm
IC50, IC52: 74LS374; DIP-20_W7.62mm
IC51: 74LS02; DIP-14_W7.62mm
IC53, IC61: 74LS157; DIP-16_W7.62mm
IC54, IC57: GAL16V8; DIP-20_W7.62mm
IC55: 2732; DIP-24_W15.24mm
IC56: 74LS153; DIP-16_W7.62mm
IC58, IC64: 74LS259; DIP-16_W7.62mm
IC59: 74LS283; DIP-16_W7.62mm
IC62: 6545; DIP-40_W15.24mm
IC63, IC65, IC66: 74LS251; DIP-16_W7.62mm
IC67, IC68, IC73: NE556; DIP-14_W7.62mm
IC69: 74LS138; DIP-16_W7.62mm
IC70: μA741; DIP-8_W7.62mm
IC72: 74LS244; DIP-20_W7.62mm
J1: Tape IN; Jack_3.5mm_CUI_SJ1-3513N_Horizontal
J2: Tape OUT; Jack_3.5mm_CUI_SJ1-3513N_Horizontal
LS1: Speaker; PinHeader_1x02_P2.54mm_Horizontal
P3, P4, P6, P7, P8: Jumper_3_Bridged12; PinHeader_1x03_P2.54mm_Vertical
P5: SolderJumper_2_Open; SolderJumper-2_P1.3mm_Open_RoundedPad1.0x1.5mm
R11, R13, R14, R28: 1K; R_Axial_DIN0309_L9.0mm_D3.2mm_P15.24mm_Horizontal
R12, R25: 47K; R_Axial_DIN0309_L9.0mm_D3.2mm_P15.24mm_Horizontal
R15, R16, R17, R18: 560; R_Axial_DIN0309_L9.0mm_D3.2mm_P15.24mm_Horizontal
R19, R21, R22, R23, R24, R31: 12K; R_Axial_DIN0309_L9.0mm_D3.2mm_P15.24mm_Horizontal
R20: 1M; R_Axial_DIN0309_L9.0mm_D3.2mm_P15.24mm_Horizontal
R26: 100; R_Axial_DIN0309_L9.0mm_D3.2mm_P15.24mm_Horizontal
R27: 27; R_Axial_DIN0309_L9.0mm_D3.2mm_P15.24mm_Horizontal
R29: 10K; R_Axial_DIN0309_L9.0mm_D3.2mm_P15.24mm_Horizontal
R30: 2.2M; R_Axial_DIN0309_L9.0mm_D3.2mm_P15.24mm_Horizontal
R32: 3.3M; R_Axial_DIN0309_L9.0mm_D3.2mm_P15.24mm_Horizontal
TR1: BC517; TO-92_HandSolder
TR2: 2N2222A; TO-92_HandSolder

Connections:
+5V: C21.1, CONN.9.2 (+5V), CONN.10.1 (+5V), CONN.11.2 (+5V), CONN.12.1 (+5V), DS1.1 (K), IC30.2 (D), IC30.4 (~S), IC49.16 (VCC), IC50.20 (VCC), IC52.20 (VCC), IC53.16 (VCC), IC54.20 (VCC), IC55.24 (VCC), IC56.13 (I3b), IC56.16 (VCC), IC57.20 (VCC), IC58.16 (VCC), IC59.16 (VCC), IC61.16 (VCC), IC62.20 (VCC), IC63.16 (VCC), IC64.16 (VCC), IC65.16 (VCC), IC66.16 (VCC), IC67.4 (Ra), IC67.10 (Rb), IC67.14 (VCC), IC68.4 (Ra), IC68.10 (Rb), IC68.14 (VCC), IC69.16 (VCC), IC70.7 (V+), IC71.1 (~R), IC71.4 (~S), IC71.10 (~S), IC71.13 (~R), IC72.20 (VCC), IC73.4 (Ra), IC73.10 (Rb), IC73.14 (VCC), LS1.2, R12.1, R29.2, R30.1, R31.1; also elsewhere on the board
+12V: CONN.9.4 (+12V); also elsewhere on the board
-5V: IC70.4 (V-); also elsewhere on the board
-12V: CONN.10.15 (-12V); also elsewhere on the board
A0: IC58.13 (D), IC62.24 (RS), IC63.11 (S0), IC64.13 (D), IC65.11 (S0), IC66.11 (S0); also elsewhere on the board
A1: IC58.1 (A0), IC63.10 (S1), IC64.1 (A0), IC65.10 (S1), IC66.10 (S1); also elsewhere on the board
A2: IC58.2 (A1), IC63.9 (S2), IC64.2 (A1), IC65.9 (S2), IC66.9 (S2); also elsewhere on the board
A3: IC40.13, IC58.3 (A2), IC60.9, IC64.3 (A2); also elsewhere on the board
A4: IC69.1 (A0); also elsewhere on the board
A5: IC69.2 (A1); also elsewhere on the board
A6: IC69.3 (A2); also elsewhere on the board
A7: IC69.4 (E1); also elsewhere on the board
ABTLTX: CONN.9.12 (ABTLTX); also elsewhere on the board
ALTZP: IC63.13 (I6), IC64.9 (Q4); also elsewhere on the board
CS6545: IC62.25 (~CS); also elsewhere on the board
D0: IC62.33 (D0), IC72.18 (O0a); also elsewhere on the board
D1: IC62.32 (D1), IC72.16 (O1a); also elsewhere on the board
D2: IC62.31 (D2), IC72.14 (O2a); also elsewhere on the board
D3: IC62.30 (D3), IC72.12 (O3a); also elsewhere on the board
D4: IC62.29 (D4), IC72.9 (O0b); also elsewhere on the board
D5: IC62.28 (D5), IC72.7 (O1b); also elsewhere on the board
D6: IC62.27 (D6), IC72.5 (O2b); also elsewhere on the board
D7: IC62.26 (D7), IC63.5 (Y), IC65.5 (Y), IC66.5 (Y), IC72.3 (O3b); also elsewhere on the board
GND: C8.2, C9.2, C10.2, C11.2, C12.2, C13.2, C14.2, C15.2, C16.2, C18.2, C19.2, C20.2, C21.2, CONN.9.1 (GND), CONN.10.8 (GND), CONN.11.3 (GND), CONN.12.8 (GND), IC49.8 (GND), IC49.15 (~CE), IC50.1 (OE), IC50.10 (GND), IC52.1 (OE), IC52.10 (GND), IC53.8 (GND), IC53.15 (E), IC54.10 (GND), IC54.11 (I10/~OE), IC55.12 (GND), IC55.18 (~E), IC55.20 (~G/Vpp), IC56.1 (Ea), IC56.8 (GND), IC56.15 (Eb), IC57.10 (GND), IC58.8 (GND), IC59.7 (C0), IC59.8 (GND), IC59.12 (A4), IC61.8 (GND), IC61.11 (I0c), IC61.14 (I0d), IC61.15 (E), IC62.1 (VSS), IC62.3 (LPEN), IC63.8 (GND), IC64.8 (GND), IC65.8 (GND), IC66.8 (GND), IC67.7 (GND), IC68.7 (GND), IC69.8 (GND), IC72.10 (GND), IC73.7 (GND), J1.S, J2.S, R11.2, R13.2, R14.2, R21.2, R23.2, R26.2, TR1.3 (E), TR2.1 (E); also elsewhere on the board
HIR: IC57.9 (I9), IC58.7 (Q3), IC65.14 (I5); also elsewhere on the board
I/O0: IC69.5 (E2); also elsewhere on the board
unnamed: C17.1, R22.1
unnamed: C17.2, J1.T
unnamed: C18.1, LS1.1, R27.2
unnamed: CONN.9.11 (BL), IC54.13 (IO7)
unnamed: CONN.9.10 (BM), IC54.14 (IO6)
unnamed: CONN.9.9 (GL), IC54.15 (IO5)
unnamed: CONN.9.8 (GM), IC54.16 (IO4)
unnamed: CONN.9.7 (RL), IC54.17 (I03)
unnamed: CONN.9.6 (RM), IC54.18 (IO2)
unnamed: CONN.9.3 (TSTVID), IC54.12 (IO8)
unnamed: CONN.10.4 (AKD), P8.3 (B)
unnamed: CONN.10.12 (B0), IC72.2 (I0a)
unnamed: CONN.10.13 (B1), IC72.4 (I1a)
unnamed: CONN.10.10 (B2), IC72.6 (I2a)
unnamed: CONN.10.11 (B3), IC72.8 (I3a)
unnamed: CONN.10.6 (B4), IC72.11 (I0b)
unnamed: CONN.10.5 (B5), IC72.13 (I1b)
unnamed: CONN.10.7 (B6), IC72.15 (I2b)
unnamed: CONN.10.3 (RES), DS2.1 (K), R29.1
unnamed: CONN.10.2 (STB), IC30.3 (C)
unnamed: CONN.10.14 (SW0), P7.1 (A), P7.2 (C)
unnamed: CONN.10.16 (SW1), P6.1 (A), P6.2 (C)
unnamed: CONN.11.5 (PDL0), CONN.12.6 (PDL0), R17.2
unnamed: CONN.11.8 (PDL1), CONN.12.10 (PDL1), R16.2
unnamed: CONN.11.4 (PDL2), CONN.12.7 (PDL2), R15.2
unnamed: CONN.11.9 (PDL3), CONN.12.11 (PDL3), R18.2
unnamed: CONN.11.7 (SW0), CONN.12.2 (SW0), IC66.3 (I1), P7.3 (B), R13.1
unnamed: CONN.11.1 (SW1), CONN.12.3 (SW1), IC66.2 (I2), P6.3 (B), R14.1
unnamed: CONN.11.6 (SW2), CONN.12.4 (SW2), IC66.1 (I3)
unnamed: CONN.12.15 (AN0), IC58.9 (Q4)
unnamed: CONN.12.14 (AN1), IC58.10 (Q5)
unnamed: CONN.12.12 (AN3), IC58.12 (Q7), P4.1 (A), P4.2 (C)
unnamed: CONN.12.5 (STB), IC69.11 (O4)
unnamed: C8.1, DS1.2 (A), IC6.10, R12.2
unnamed: C19.1, DS2.2 (A), IC73.2 (THRa), IC73.6 (TRa), R30.2
unnamed: IC1.4, IC2.4
unnamed: IC2.6, IC51.11, IC60.4, IC60.10
unnamed: IC2.8, IC51.9
unnamed: IC30.5 (Q), IC72.17 (I3b)
unnamed: IC30.1 (~R), IC51.13
unnamed: IC40.2, IC51.3
unnamed: IC40.4, IC60.13
unnamed: IC40.9, IC60.3
unnamed: IC40.12, IC60.5
unnamed: IC49.11 (D0), IC55.17 (D7)
unnamed: IC49.12 (D1), IC55.16 (D6)
unnamed: IC49.13 (D2), IC55.15 (D5)
unnamed: IC49.14 (D3), IC55.14 (D4)
unnamed: IC49.3 (D4), IC50.8 (D3), IC55.13 (D3)
unnamed: IC49.4 (D5), IC50.7 (D2), IC55.11 (D2)
unnamed: IC49.5 (D6), IC50.4 (D1), IC55.10 (D1)
unnamed: IC49.6 (D7), IC50.3 (D0), IC55.9 (D0)
unnamed: IC49.9 (Q7), IC49.10 (DS), IC52.14 (D5), IC57.2 (I2)
unnamed: IC50.18 (D7), IC62.18 (DSPL_EN)
unnamed: IC50.2 (O0), IC52.3 (D0)
unnamed: IC50.5 (O1), IC52.4 (D1)
unnamed: IC50.6 (O2), IC52.7 (D2)
unnamed: IC50.9 (O3), IC52.8 (D3)
unnamed: IC50.15 (O5), IC53.2 (I0a), IC57.4 (I4)
unnamed: IC50.16 (O6), IC57.5 (I5)
unnamed: IC50.19 (O7), IC52.18 (D7)
unnamed: IC52.13 (D4), IC52.15 (O5), IC54.8 (I8)
unnamed: IC51.10, IC52.17 (D6)
unnamed: IC52.2 (O0), IC53.3 (I1a)
unnamed: IC52.5 (O1), IC53.6 (I1b)
unnamed: IC52.6 (O2), IC53.10 (I1c)
unnamed: IC52.9 (O3), IC53.13 (I1d)
unnamed: IC52.12 (O4), IC57.3 (I3)
unnamed: IC51.8, IC52.16 (O6), IC53.11 (I0c)
unnamed: IC2.9, IC52.19 (O7), IC54.9 (I9)
unnamed: IC53.5 (I0b), IC57.18 (IO2)
unnamed: IC53.14 (I0d), P3.1 (A), P3.2 (C)
unnamed: IC53.1 (S), IC54.6 (I6), IC56.5 (I1a), IC56.6 (I0a), IC57.15 (IO5)
unnamed: IC53.4 (Za), IC54.2 (I2)
unnamed: IC53.7 (Zb), IC54.3 (I3)
unnamed: IC53.9 (Zc), IC54.4 (I4)
unnamed: IC53.12 (Zd), IC54.5 (I5)
unnamed: IC54.7 (I7), IC55.21 (A11), IC56.2 (S1), IC57.17 (I03)
unnamed: IC55.8 (A0), IC56.7 (Za)
unnamed: IC55.7 (A1), IC61.6 (I1b), IC62.37 (RA1)
unnamed: IC55.6 (A2), IC60.1, IC62.36 (RA2)
unnamed: IC55.19 (A10), IC56.9 (Zb)
unnamed: IC56.3 (I3a), IC56.4 (I2a), IC61.3 (I1a), IC62.38 (RA0)
unnamed: IC56.14 (S0), IC57.19 (IO1), IC64.12 (Q7), IC65.13 (I6)
unnamed: IC57.1 (I1/CLK), IC73.9 (Qb)
unnamed: IC57.6 (I6), IC64.11 (Q6), IC65.12 (I7)
unnamed: IC57.7 (I7), IC58.5 (Q1), IC65.1 (I3)
unnamed: IC1.11, IC57.8 (I8)
unnamed: IC57.16 (IO4), IC60.2, IC61.1 (S)
unnamed: IC57.14 (IO6), P3.3 (B)
unnamed: IC57.12 (IO8), P4.3 (B), R11.1
unnamed: IC58.14 (E), IC69.10 (O5)
unnamed: IC59.5 (A1), IC62.7 (MA3)
unnamed: IC59.3 (A2), IC62.8 (MA4)
unnamed: IC59.14 (A3), IC62.9 (MA5)
unnamed: IC59.6 (B1), IC59.15 (B3), IC62.15 (MA11)
unnamed: IC1.13, IC59.2 (B2), IC59.11 (B4), IC62.16 (MA12)
unnamed: IC60.11, IC61.2 (I0a), IC61.10 (I1c)
unnamed: IC51.1, IC61.5 (I0b), IC61.13 (I1d)
unnamed: IC51.6, IC62.39 (HSYNC)
unnamed: IC5.11, IC51.5, IC62.40 (VSYNC)
unnamed: IC6.8, IC62.2 (~RES)
unnamed: IC63.4 (I0), P8.1 (A), P8.2 (C)
unnamed 261: IC63.3 (I1); also elsewhere on the board
unnamed: IC60.6, IC63.7 (~OE)
unnamed: IC6.6, IC64.14 (E)
unnamed: IC5.10, IC65.3 (I1)
unnamed: IC60.8, IC65.7 (~OE)
unnamed: IC66.4 (I0), R19.1
unnamed: IC66.15 (I4), IC68.5 (Qa)
unnamed: IC66.14 (I5), IC67.9 (Qb)
unnamed: IC66.13 (I6), IC67.5 (Qa)
unnamed: IC66.12 (I7), IC68.9 (Qb)
unnamed: IC66.7 (~OE), IC69.9 (O6)
unnamed: C9.1, IC67.3 (CVa)
unnamed: C10.1, IC67.11 (CVb)
unnamed: C16.1, IC67.1 (DISa), IC67.2 (THRa), R15.1
unnamed: C15.1, IC67.12 (THRb), IC67.13 (DISb), R16.1
unnamed: IC67.6 (TRa), IC67.8 (TRb), IC68.6 (TRa), IC68.8 (TRb), IC69.7 (O7)
unnamed: C11.1, IC68.3 (CVa)
unnamed: C12.1, IC68.11 (CVb)
unnamed: C14.1, IC68.1 (DISa), IC68.2 (THRa), R17.1
unnamed: C13.1, IC68.12 (THRb), IC68.13 (DISb), R18.1
unnamed: IC2.3, IC6.5, IC69.15 (O0)
unnamed: IC2.5, IC69.14 (O1)
unnamed: IC69.13 (O2), IC71.11 (C)
unnamed: IC69.12 (O3), IC71.3 (C)
unnamed: IC70.3 (+), R20.2, R21.1
unnamed: IC70.2 (-), R22.2, R23.1
unnamed: IC70.6, R19.2, R20.1
unnamed: IC71.2 (D), IC71.6 (~Q)
unnamed: IC71.5 (Q), R25.1
unnamed: IC71.8 (~Q), IC71.12 (D)
unnamed: IC71.9 (Q), R24.1
unnamed: IC1.6, IC72.1 (OEa), IC72.19 (OEb)
unnamed: IC73.13 (DISb), R31.2, R32.1
unnamed: IC51.12, IC73.5 (Qa), R28.2
unnamed: C20.1, IC73.8 (TRb), IC73.12 (THRb), R32.2
unnamed: J2.T, R24.2, R26.1
unnamed: R25.2, TR1.2 (B)
unnamed: R27.1, TR1.1 (C)
unnamed: R28.1, TR2.2 (B)
PAGE2: IC40.1, IC58.6 (Q2), IC60.12, IC65.15 (I4); also elsewhere on the board
RDram: IC63.1 (I3), IC64.5 (Q1); also elsewhere on the board
R/~W: IC1.5, IC6.4, IC62.22 (R/~W); also elsewhere on the board
S4080: IC57.13 (IO7); also elsewhere on the board
SLC3: IC63.12 (I7), IC64.10 (Q5); also elsewhere on the board
SLCx: IC63.14 (I5), IC64.7 (Q3); also elsewhere on the board
SRCK: IC49.2 (CP), IC52.11 (Cp), IC54.1 (I1/CLK); also elsewhere on the board
SRLD: IC49.1 (~PL), IC50.11 (Cp); also elsewhere on the board
ST80: IC40.3, IC51.2, IC64.4 (Q0), IC65.4 (I0); also elsewhere on the board
SYNC: CONN.9.5 (SYNC), IC51.4; also elsewhere on the board
TXT: IC57.11 (I10/~OE), IC58.4 (Q0), IC65.2 (I2); also elsewhere on the board
VA0: IC62.4 (MA0); also elsewhere on the board
VA1: IC62.5 (MA1); also elsewhere on the board
VA2: IC62.6 (MA2); also elsewhere on the board
VA3: IC59.4 (S1); also elsewhere on the board
VA4: IC59.1 (S2); also elsewhere on the board
VA5: IC59.13 (S3); also elsewhere on the board
VA6: IC59.10 (S4); also elsewhere on the board
VA7: IC62.12 (MA8); also elsewhere on the board
VA8: IC62.13 (MA9); also elsewhere on the board
VA9: IC1.12, IC62.14 (MA10); also elsewhere on the board
VA10: IC61.4 (Za); also elsewhere on the board
VA11: IC61.7 (Zb); also elsewhere on the board
VA12: IC40.8; also elsewhere on the board
VA13: IC61.9 (Zc); also elsewhere on the board
VA14: IC61.12 (Zd); also elsewhere on the board
VD0: IC55.5 (A3); also elsewhere on the board
VD1: IC55.4 (A4); also elsewhere on the board
VD2: IC55.3 (A5); also elsewhere on the board
VD3: IC55.2 (A6); also elsewhere on the board
VD4: IC55.1 (A7); also elsewhere on the board
VD5: IC55.23 (A8); also elsewhere on the board
VD6: IC50.17 (D6), IC55.22 (A9); also elsewhere on the board
VD7: IC50.14 (D5), IC56.10 (I0b), IC56.11 (I1b), IC56.12 (I2b); also elsewhere on the board
WRram: IC63.15 (I4), IC64.6 (Q2); also elsewhere on the board
~RES: IC6.9, IC58.15 (Clr), IC64.15 (Clr), TR2.3 (C); also elsewhere on the board
Φ0: IC62.23 (ϕ2), IC69.6 (E3); also elsewhere on the board
Φ1: IC62.21 (CCLK); also elsewhere on the board

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
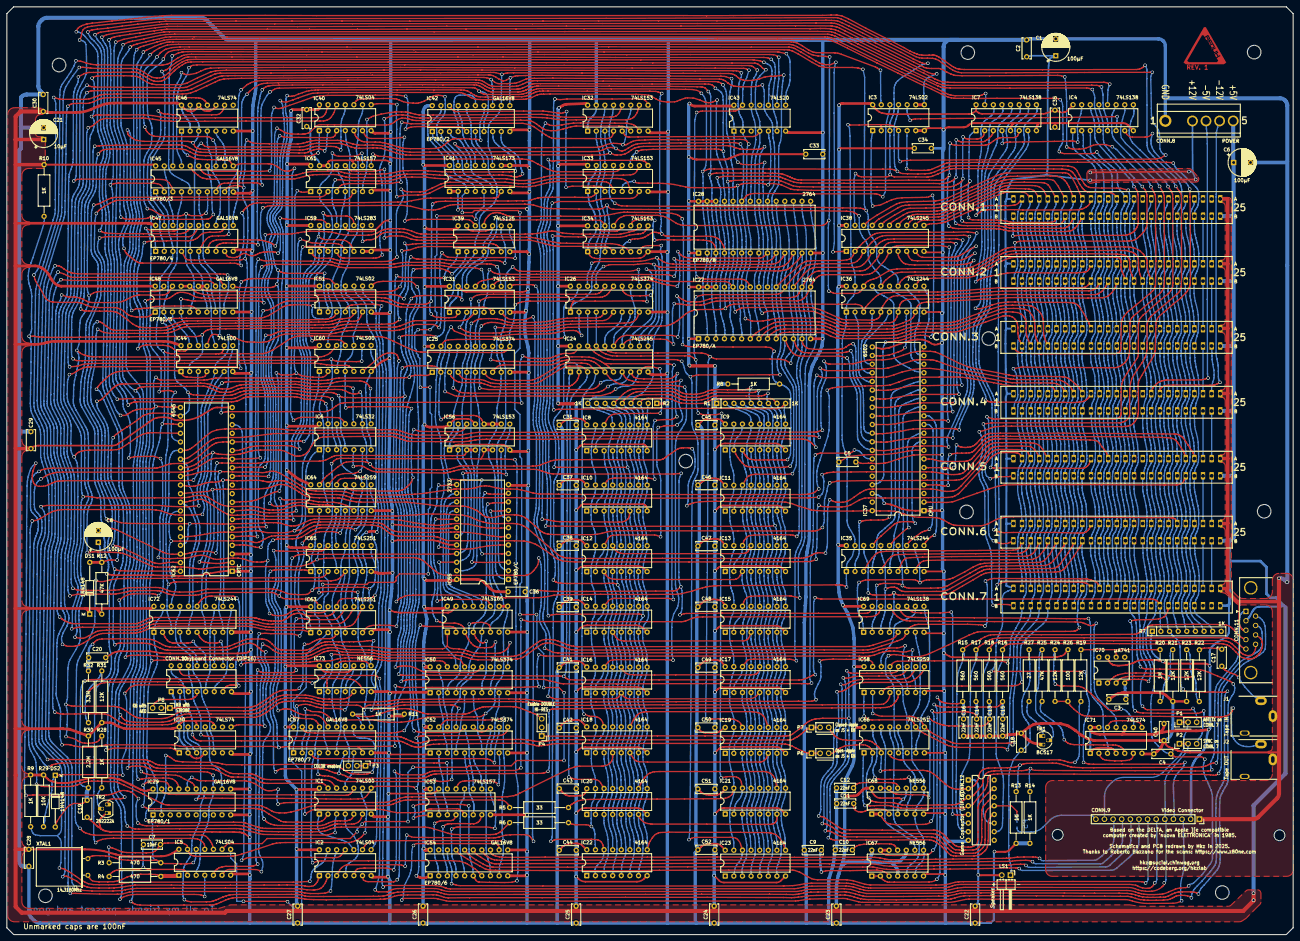
[picture p18: board NE_Delta.kicad_pcb from above]

Board: 2 copper layers, 379.1 x 273.4 mm, 185 parts (1 on the bottom side), 350 nets.
