frubem/NE_Delta_Schematics/LX783_RGB_Video/LX783.kicad_pcb

## KiCad design LX783_RGB_Video/LX783.kicad_pcb (2026-08-03)

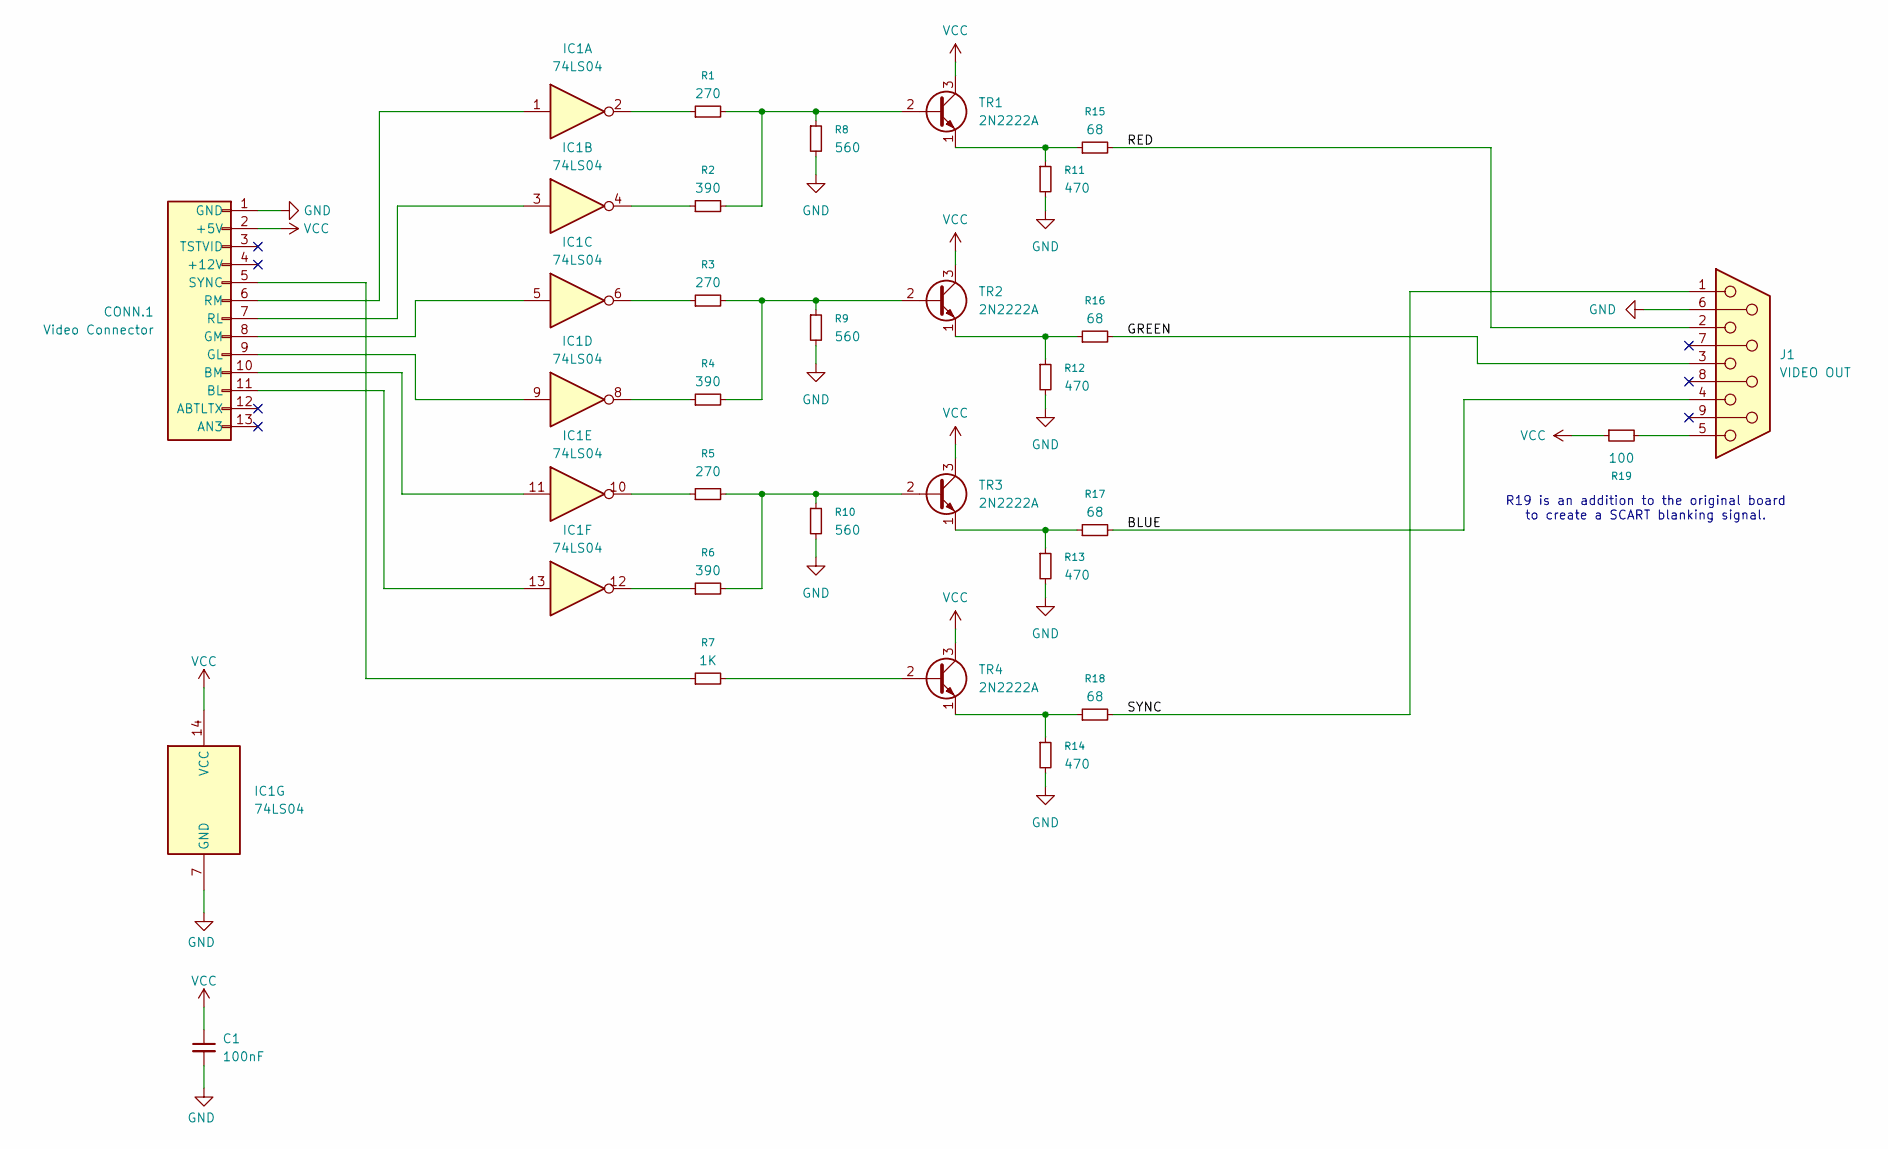
[picture p19: schematic LX783.kicad_sch]

Parts:
C1: 100nF; C_Disc_D6.0mm_W2.5mm_P5.00mm
CONN.1: Video Connector; PinHeader_1x13_P2.54mm_Horizontal
IC1: 74LS04; DIP-14_W7.62mm
J1: VIDEO OUT; DSUB-9_Socket_Horizontal
R1, R3, R5: 270; R_Axial_DIN0309_L9.0mm_D2.87mm_P12mm_Horizontal
R2, R4, R6: 390; R_Axial_DIN0309_L9.0mm_D2.87mm_P12mm_Horizontal
R7: 1K; R_Axial_DIN0309_L9.0mm_D2.87mm_P12mm_Horizontal
R8, R9, R10: 560; R_Axial_DIN0309_L9.0mm_D2.87mm_P12mm_Horizontal
R11, R12, R13, R14: 470; R_Axial_DIN0309_L9.0mm_D2.87mm_P12mm_Horizontal
R15, R16, R17, R18: 68; R_Axial_DIN0309_L9.0mm_D2.87mm_P12mm_Horizontal
R19: 100; R_Axial_DIN0309_L9.0mm_D2.87mm_P12mm_Horizontal
TR1, TR2, TR3, TR4: 2N2222A; TO-92_HandSolder

Connections:
/BLUE: J1.4, R17.2
/GREEN: J1.3, R16.2
/RED: J1.2, R15.2
/SYNC: J1.1, R18.2
GND: C1.2, CONN.1.1 (GND), IC1.7 (GND), J1.6, R8.2, R9.2, R10.2, R11.2, R12.2, R13.2, R14.2
unnamed: CONN.1.11 (BL), IC1.13
unnamed: CONN.1.10 (BM), IC1.11
unnamed: CONN.1.9 (GL), IC1.9
unnamed: CONN.1.8 (GM), IC1.5
unnamed: CONN.1.7 (RL), IC1.3
unnamed: CONN.1.6 (RM), IC1.1
unnamed: CONN.1.5 (SYNC), R7.1
unnamed: IC1.2, R1.1
unnamed: IC1.4, R2.1
unnamed: IC1.6, R3.1
unnamed: IC1.8, R4.1
unnamed: IC1.10, R5.1
unnamed: IC1.12, R6.1
unnamed: J1.5, R19.2
unnamed: R1.2, R2.2, R8.1, TR1.2 (B)
unnamed: R11.1, R15.1, TR1.1 (E)
unnamed: R3.2, R4.2, R9.1, TR2.2 (B)
unnamed: R12.1, R16.1, TR2.1 (E)
unnamed: R5.2, R6.2, R10.1, TR3.2 (B)
unnamed: R13.1, R17.1, TR3.1 (E)
unnamed: R7.2, TR4.2 (B)
unnamed: R14.1, R18.1, TR4.1 (E)
VCC: C1.1, CONN.1.2 (+5V), IC1.14 (VCC), R19.1, TR1.3 (C), TR2.3 (C), TR3.3 (C), TR4.3 (C)

Notes on the sheet:
R19 is an addition to the original board to create a SCART blanking signal.

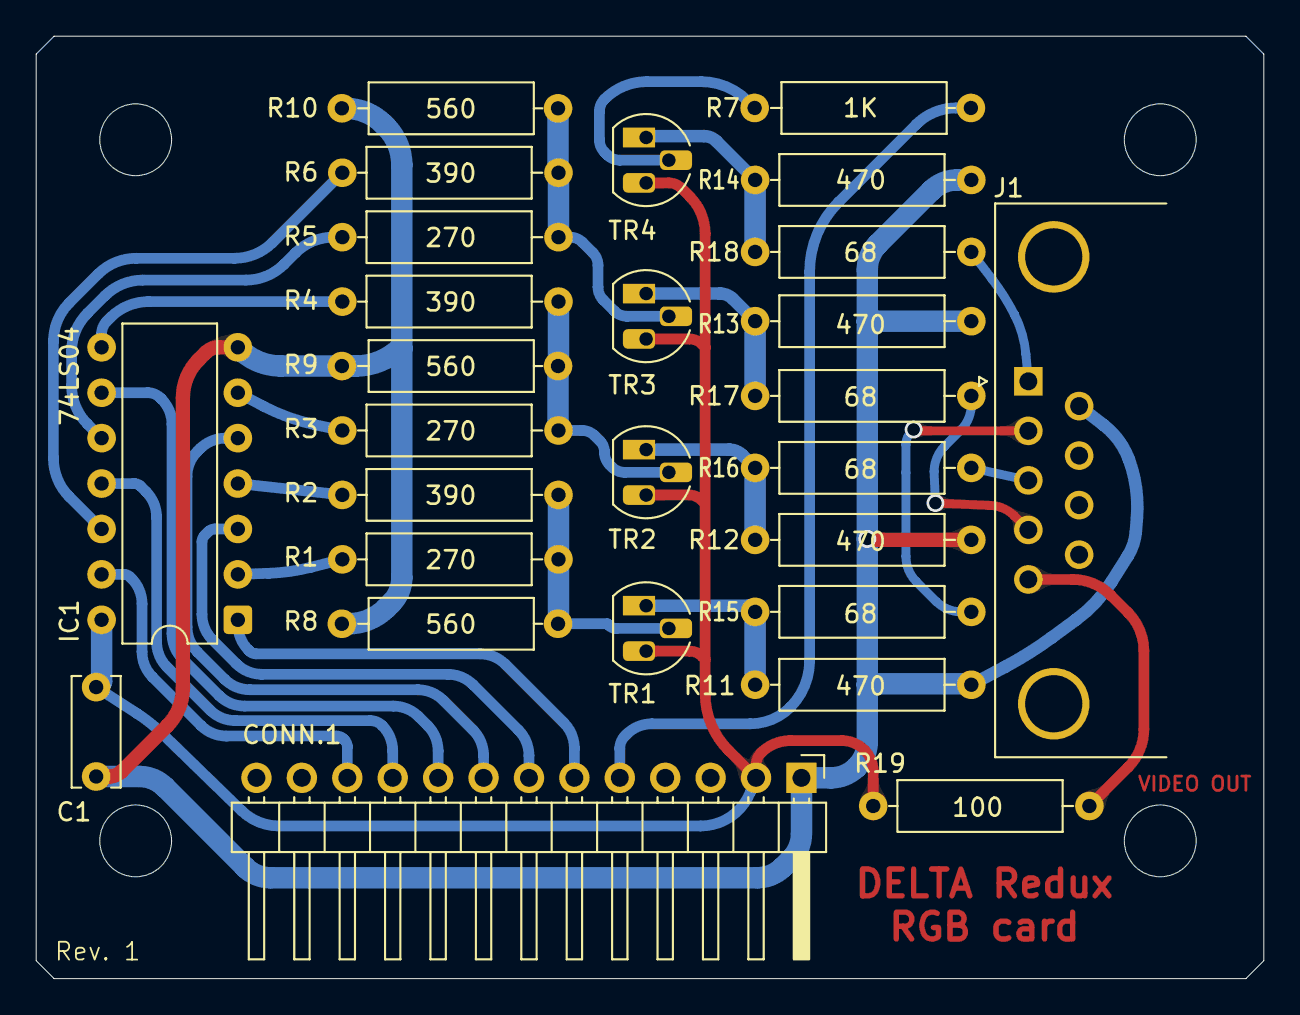
[picture p20: board LX783.kicad_pcb from above]

Board: 2 copper layers, 68.7 x 52.7 mm, 27 parts (0 on the bottom side), 28 nets.
