frubem/NE_Delta_Schematics/LX782_Monochrome_Video/LX782.kicad_pcb

## KiCad design LX782_Monochrome_Video/LX782.kicad_pcb (2026-08-03)

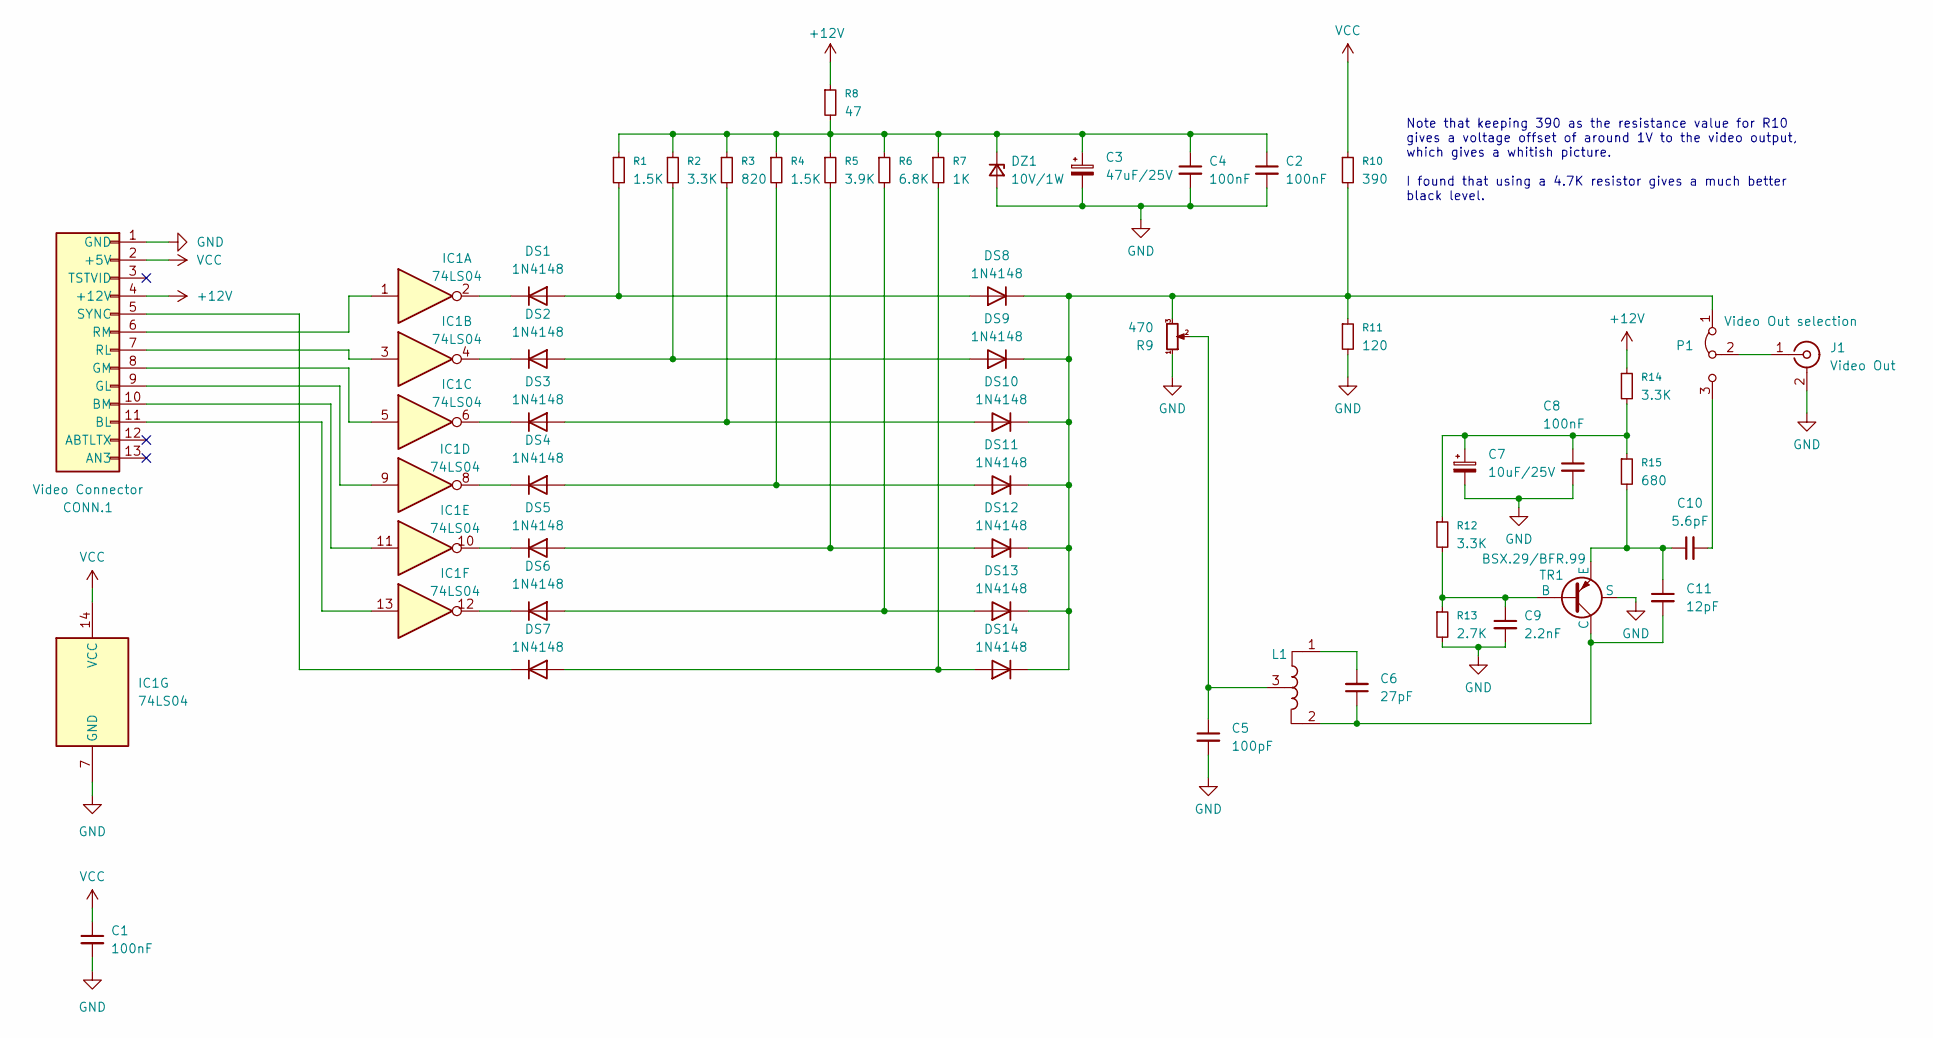
[picture p21: schematic LX782.kicad_sch, LX782 - Monochrome Video]

Parts:
C1, C2, C4, C8: 100nF; C_Disc_D6.0mm_W2.5mm_P5.00mm
C3: 47uF/25V; CP_Radial_D5.0mm_P2.50mm
C5: 100pF; C_Disc_D6.0mm_W2.5mm_P5.00mm
C6: 27pF; C_Disc_D6.0mm_W2.5mm_P5.00mm
C7: 10uF/25V; CP_Radial_D5.0mm_P2.50mm
C9: 2.2nF; C_Disc_D6.0mm_W2.5mm_P5.00mm
C10: 5.6pF; C_Disc_D6.0mm_W2.5mm_P5.00mm
C11: 12pF; C_Disc_D6.0mm_W2.5mm_P5.00mm
CONN.1: Video Connector; PinHeader_1x13_P2.54mm_Horizontal
DS1, DS2, DS3, DS4, DS5, DS6, DS7, DS8, DS9, DS10, DS11, DS12, DS13, DS14: 1N4148; D_DO-35_SOD27_P8mm_Horizontal
DZ1: 10V/1W; D_DO-35_SOD27_P8mm_Horizontal_BIGH
IC1: 74LS04; DIP-14_W7.62mm
J1: Video Out; Merlin_RCA
L1: Inductor_CenterTap; RF_Inductor
P1: Video Out selection; PinHeader_1x03_P2.54mm_Vertical
R1, R4: 1.5K; R_Axial_DIN0309_L9.0mm_D2.87mm_P10mm_Horizontal
R2, R12, R14: 3.3K; R_Axial_DIN0309_L9.0mm_D2.87mm_P10mm_Horizontal
R3: 820; R_Axial_DIN0309_L9.0mm_D2.87mm_P10mm_Horizontal
R5: 3.9K; R_Axial_DIN0309_L9.0mm_D2.87mm_P10mm_Horizontal
R6: 6.8K; R_Axial_DIN0309_L9.0mm_D2.87mm_P10mm_Horizontal
R7: 1K; R_Axial_DIN0309_L9.0mm_D2.87mm_P10mm_Horizontal
R8: 47; R_Axial_DIN0309_L9.0mm_D2.87mm_P10mm_Horizontal
R9: 470; Potentiometer_Bourns_3386P_Vertical
R10: 390; R_Axial_DIN0309_L9.0mm_D2.87mm_P10mm_Horizontal
R11: 120; R_Axial_DIN0309_L9.0mm_D2.87mm_P10mm_Horizontal
R13: 2.7K; R_Axial_DIN0309_L9.0mm_D2.87mm_P10mm_Horizontal
R15: 680; R_Axial_DIN0309_L9.0mm_D2.87mm_P10mm_Horizontal
TR1: BSX.29/BFR.99; TO72_BFR99

Connections:
+12V: CONN.1.4 (+12V), R8.1, R14.1
GND: C1.2, C2.2, C3.2, C4.2, C5.2, C7.2, C8.2, C9.2, CONN.1.1 (GND), DZ1.2 (A), IC1.7 (GND), J1.2 (Ext), R9.1, R11.2, R13.2, TR1.S
unnamed: C5.1, L1.3, R9.2
unnamed: C6.2, L1.1
unnamed: C7.1, C8.1, R12.1, R14.2, R15.1
unnamed: C9.1, R12.2, R13.1, TR1.B
unnamed: C10.1, C11.1, R15.2, TR1.E
unnamed: C6.1, C11.2, L1.2, TR1.C
unnamed: CONN.1.11 (BL), IC1.13
unnamed: CONN.1.10 (BM), IC1.11
unnamed: CONN.1.9 (GL), IC1.9
unnamed: CONN.1.8 (GM), IC1.5
unnamed: CONN.1.7 (RL), IC1.3
unnamed: CONN.1.6 (RM), IC1.1
unnamed: CONN.1.5 (SYNC), DS7.1 (K)
unnamed: DS1.2 (A), DS8.2 (A), R1.2
unnamed: DS1.1 (K), IC1.2
unnamed: DS2.2 (A), DS9.2 (A), R2.2
unnamed: DS2.1 (K), IC1.4
unnamed: DS3.1 (K), IC1.6
unnamed: DS4.1 (K), IC1.8
unnamed: DS5.1 (K), IC1.10
unnamed: DS6.1 (K), IC1.12
unnamed: DS3.2 (A), DS10.2 (A), R3.2
unnamed: DS8.1 (K), DS9.1 (K), DS10.1 (K), DS11.1 (K), DS12.1 (K), DS13.1 (K), DS14.1 (K), P1.1 (A), R9.3, R10.2, R11.1
unnamed: DS4.2 (A), DS11.2 (A), R4.2
unnamed: DS5.2 (A), DS12.2 (A), R5.2
unnamed: DS6.2 (A), DS13.2 (A), R6.2
unnamed: DS7.2 (A), DS14.2 (A), R7.2
unnamed: C2.1, C3.1, C4.1, DZ1.1 (K), R1.1, R2.1, R3.1, R4.1, R5.1, R6.1, R7.1, R8.2
unnamed: J1.1 (In), P1.2 (C)
unnamed: C10.2, P1.3 (B)
VCC: C1.1, CONN.1.2 (+5V), IC1.14 (VCC), R10.1

Notes on the sheet:
Note that keeping 390 as the resistance value for R10 gives a voltage offset of around 1V to the video output, which gives a whitish picture. I found that using a 4.7K resistor gives a much better black level.

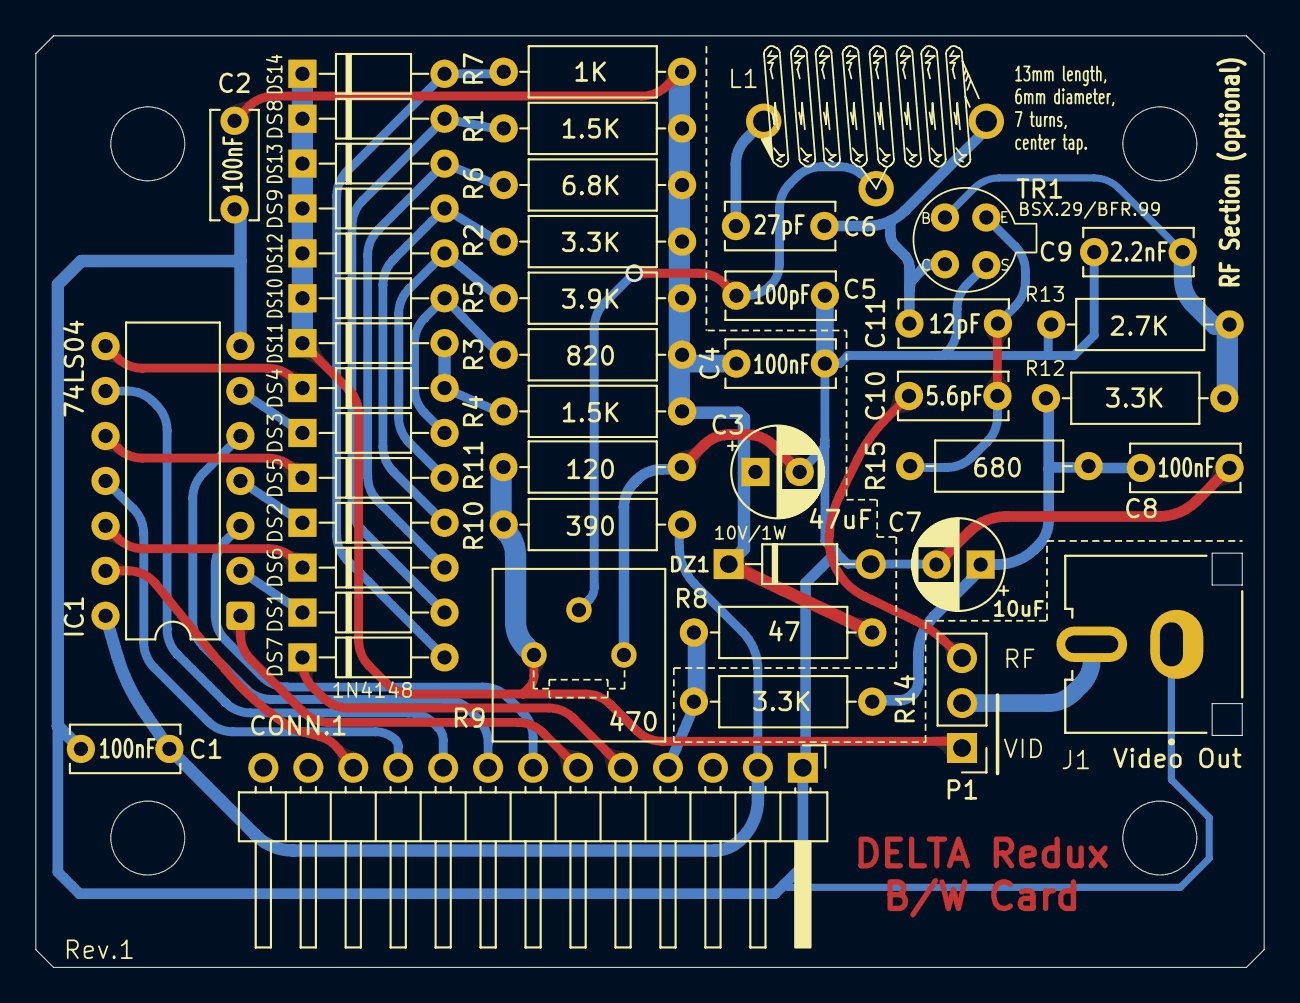
[picture p22: board LX782.kicad_pcb from above]

Board: 2 copper layers, 69.4 x 52.6 mm, 47 parts (0 on the bottom side), 33 nets.
