frubem/NE_Delta_Schematics/hram_regs_patch/hram_regs_patch.kicad_pcb

## KiCad design hram_regs_patch/hram_regs_patch.kicad_pcb (2026-08-03)

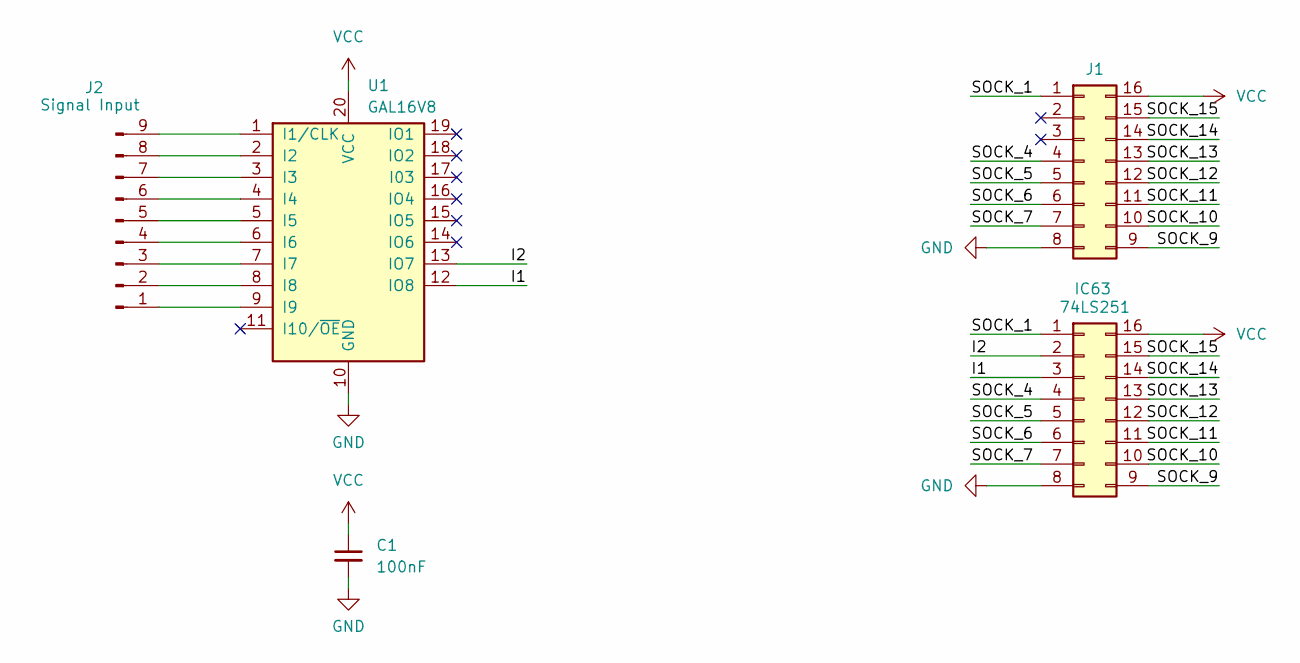
[picture p23: schematic hram_regs_patch.kicad_sch]

Parts:
C1: 100nF; C_Disc_D4.3mm_W1.9mm_P5.00mm
IC63: 74LS251; DIP-16_W7.62mm
J1: reversed_DIP-16_W7.62mm
J2: Signal Input; PinHeader_1x09_P2.54mm_Horizontal
U1: GAL16V8; DIP-20_W7.62mm

Connections:
/I1: IC63.3, U1.12 (IO8)
/I2: IC63.2, U1.13 (IO7)
/SOCK_1: IC63.1, J1.1
/SOCK_4: IC63.4, J1.4
/SOCK_5: IC63.5, J1.5
/SOCK_6: IC63.6, J1.6
/SOCK_7: IC63.7, J1.7
/SOCK_9: IC63.9, J1.9
/SOCK_10: IC63.10, J1.10
/SOCK_11: IC63.11, J1.11
/SOCK_12: IC63.12, J1.12
/SOCK_13: IC63.13, J1.13
/SOCK_14: IC63.14, J1.14
/SOCK_15: IC63.15, J1.15
GND: C1.2, IC63.8, J1.8, U1.10 (GND)
unnamed: J2.1, U1.9 (I9)
unnamed: J2.2, U1.8 (I8)
unnamed: J2.3, U1.7 (I7)
unnamed: J2.4, U1.6 (I6)
unnamed: J2.5, U1.5 (I5)
unnamed: J2.6, U1.4 (I4)
unnamed: J2.7, U1.3 (I3)
unnamed: J2.8, U1.2 (I2)
unnamed: J2.9, U1.1 (I1/CLK)
VCC: C1.1, IC63.16, J1.16, U1.20 (VCC)

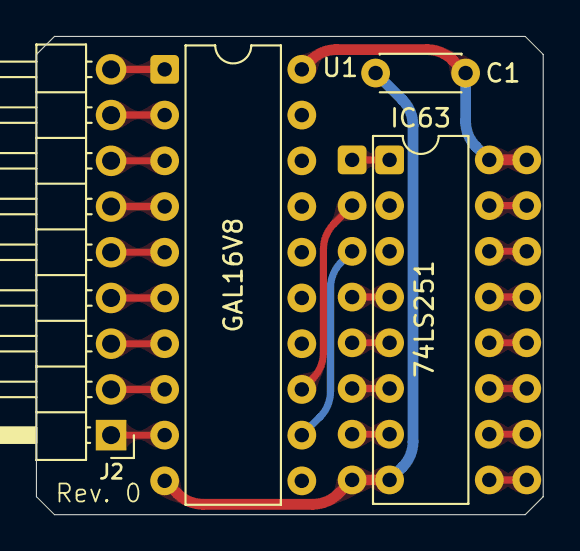
[picture p24: board hram_regs_patch.kicad_pcb from above]

Board: 2 copper layers, 28.2 x 26.6 mm, 5 parts (0 on the bottom side), 25 nets.
