frubem/NE_Delta_Schematics/LX780_Delta-fixed/scans/overlay_color.jpg

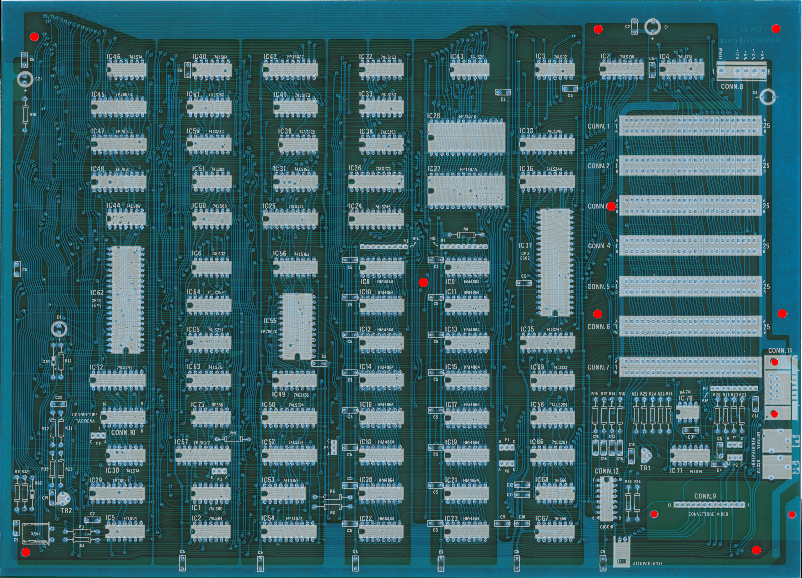
LX780_Delta-fixed/scans/overlay_color.jpg
